Ja-cup/FiveLink/README.md

# FiveLink
FiveLink is a remote-controlled, pick-and-place robot developed for our Bachelor thesis in collaboration with Tronrud Engineering. The design builds on the earlier DuoPod prototype.

Project video: https://youtu.be/_2HHFRIy9HQ
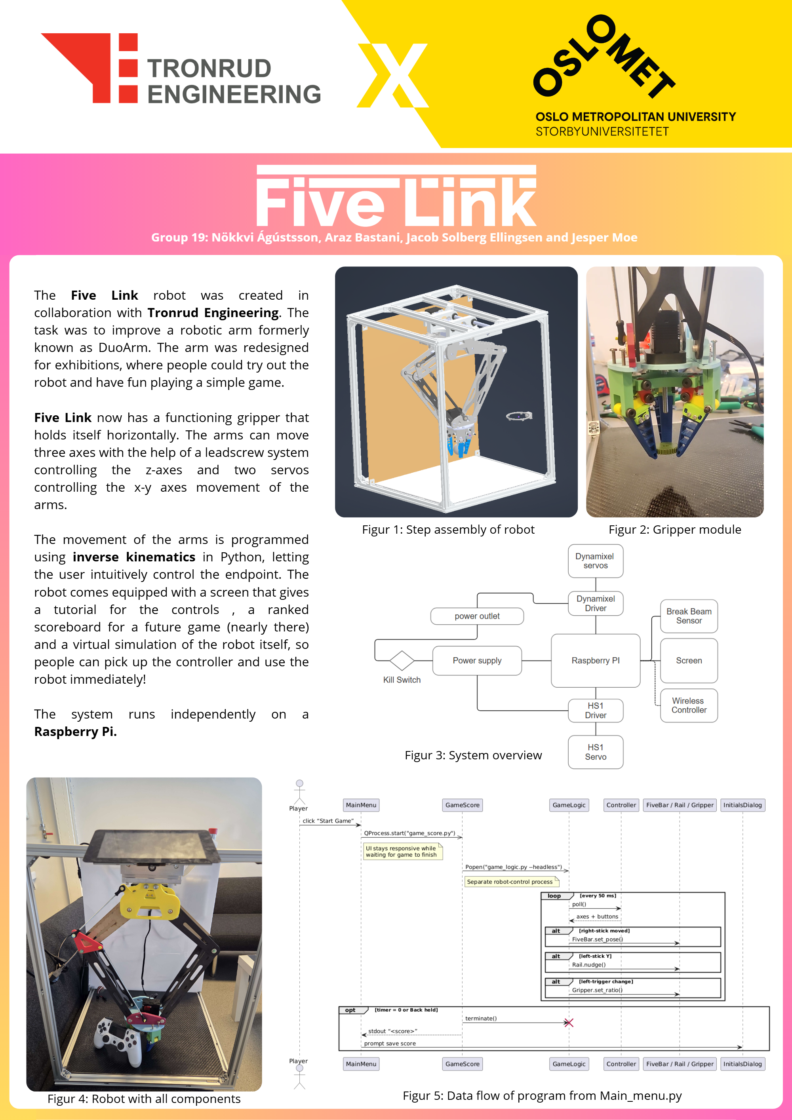
[picture p1: Poster.png]
PDF Poster
