Ja-cup/FiveLink/Software/goal gifs/hey-hi.gif

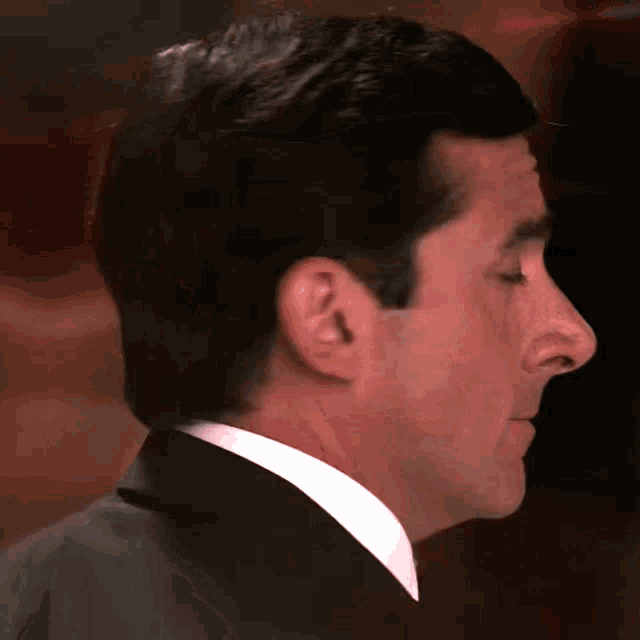
Software/goal gifs/hey-hi.gif
