Ja-cup/FiveLink/Software/goal gifs/kermit-nod-nod.gif

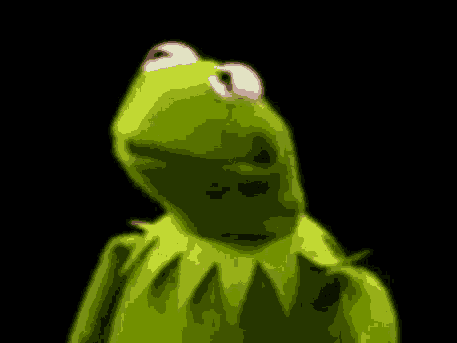
Software/goal gifs/kermit-nod-nod.gif
