Ja-cup/FiveLink/Software/goal gifs/siuuu-siu.gif

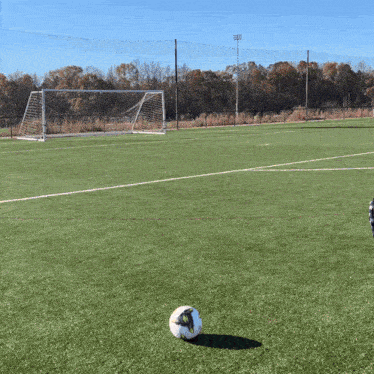
Software/goal gifs/siuuu-siu.gif
