Ja-cup/FiveLink/Software/goal gifs/spongebob-nick.gif

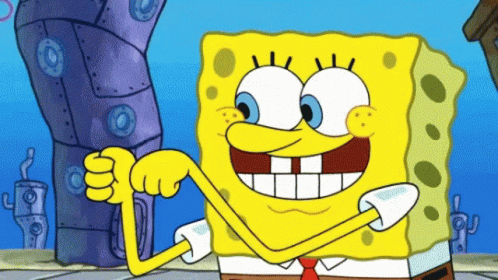
Software/goal gifs/spongebob-nick.gif
