Ja-cup/FiveLink/Design/6 Griper/Finger/Finger Assembly.stp

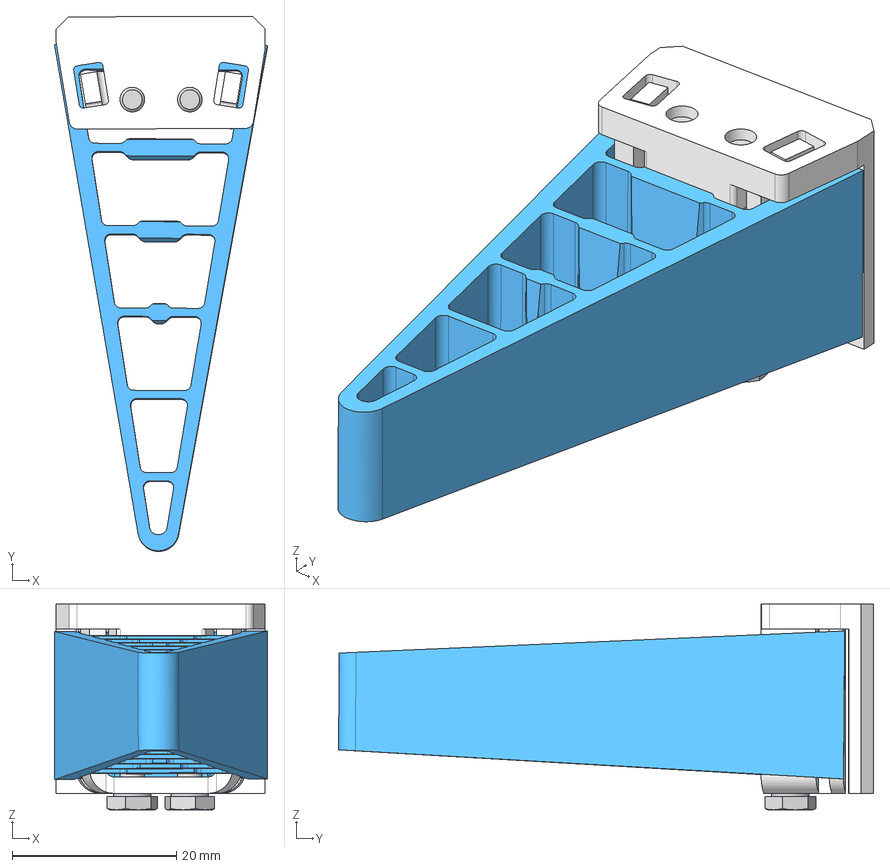
[picture p6: CAD file, 2025-08-07]
Design/6 Griper/Finger/Finger Assembly.stp
25.9 x 65.1 x 25.0 mm
4464306 DHAS-ME-H9-60---(befestigung)
Finger 60mm
Hexagon bolt DIN 933 - M3x22 x 2
Bakdel finger feste 3D - print
