Ja-cup/FiveLink/Design/1 Ramme/Assembly Ramme.stp

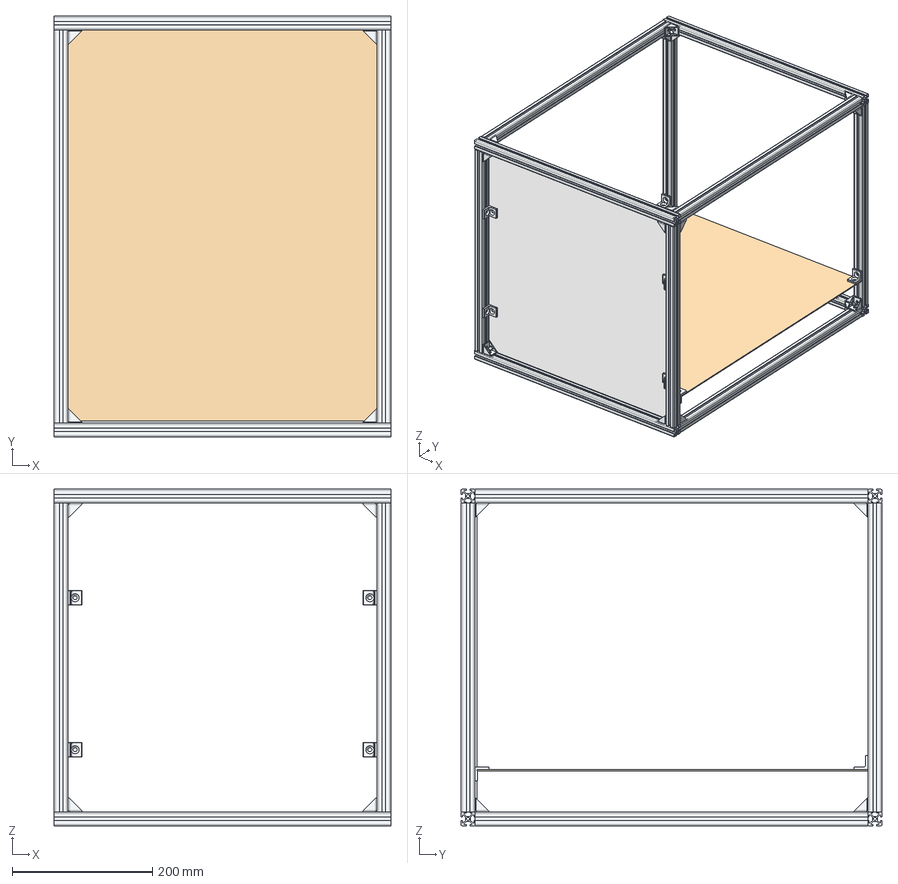
[picture p7: CAD file, 2025-08-07]
Design/1 Ramme/Assembly Ramme.stp
480.0 x 600.0 x 480.0 mm
Item Profile 20x20x440 x 4
Item Profile 20x20x480_480 x 4
Item Profile 20x20x560 x 4
CornerBracket x 24
Gulv
Anglebracket-2 x 8
Bakvegg
