Ja-cup/FiveLink/Design/4 Armer/Arm uten stabilisator assembly.stp

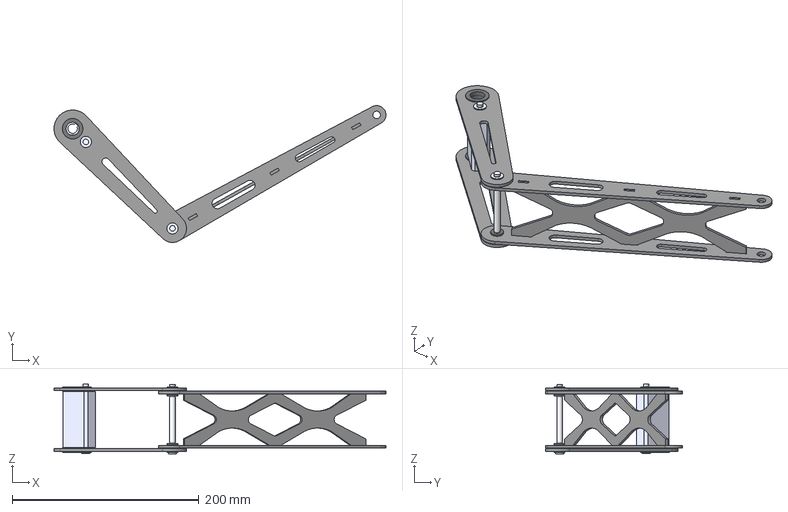
[picture p8: CAD file, 2025-08-07]
Design/4 Armer/Arm uten stabilisator assembly.stp
355.3 x 146.5 x 74.4 mm
Aksel-Arm Kobling
FlangeBearing 14x4mm x 4
HingePin AkselKobling x 2
Flange bearindID6 x 6
Aktiv arm ny lengde (1) x 2
Passiv arm ny lengde x 2
ibh_GFM-0607-024_2025411_1214_model x 2
ThrusterBearing 6x1.5 x 2
Avstiving Med Grop
