Ja-cup/FiveLink/Design/1 Ramme/Sidedel 1.stp

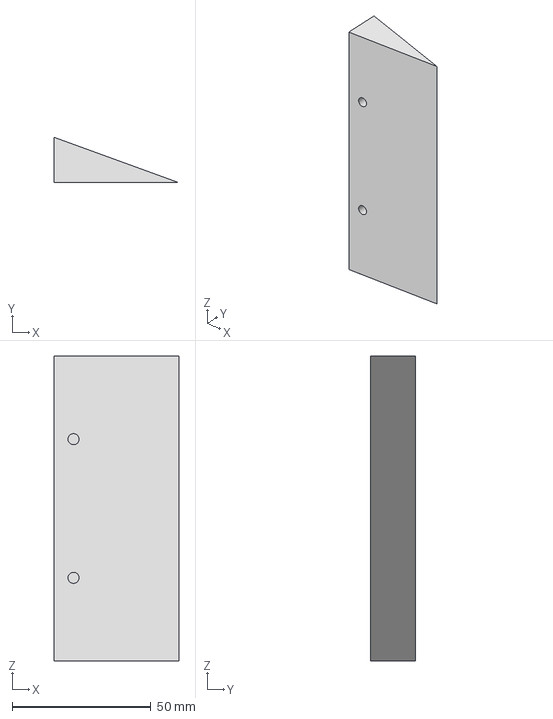
[picture p9: CAD file, 2025-08-07]
Design/1 Ramme/Sidedel 1.stp
45.0 x 16.4 x 110.0 mm
