Ja-cup/FiveLink/Design/2 Tredje Akse/Beholdt deler/Retaining Ring  C22.stp

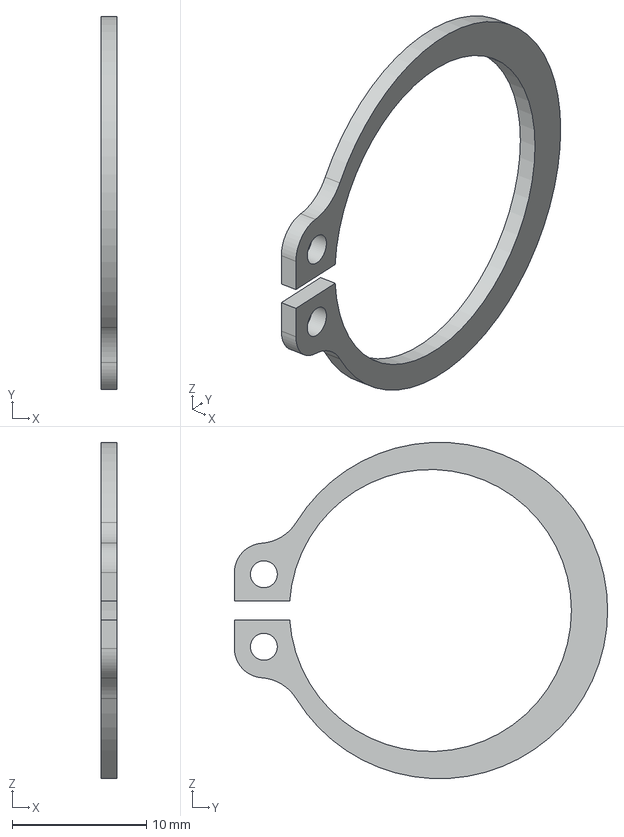
[picture p10: CAD file, 2025-08-07]
Design/2 Tredje Akse/Beholdt deler/Retaining Ring C22.stp
1.20 x 27.8 x 25.0 mm
