Ja-cup/FiveLink/Design/2 Tredje Akse/GirP30T.stp

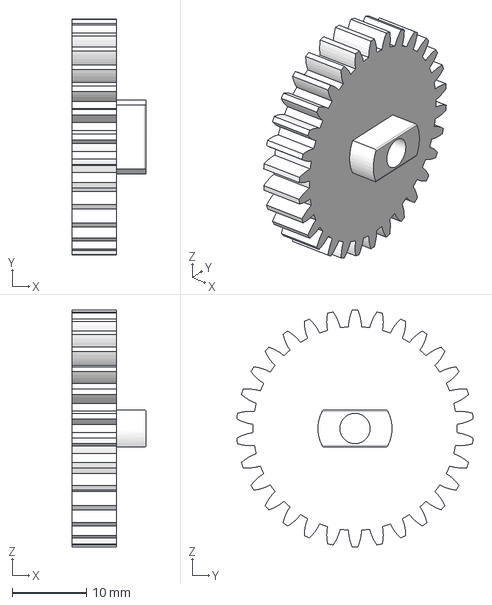
[picture p11: CAD file, 2025-08-07]
Design/2 Tredje Akse/GirP30T.stp
10.0 x 31.9 x 32.0 mm
