Ja-cup/FiveLink/Design/3 Festehub/Beholdt deler/Aksel.stp

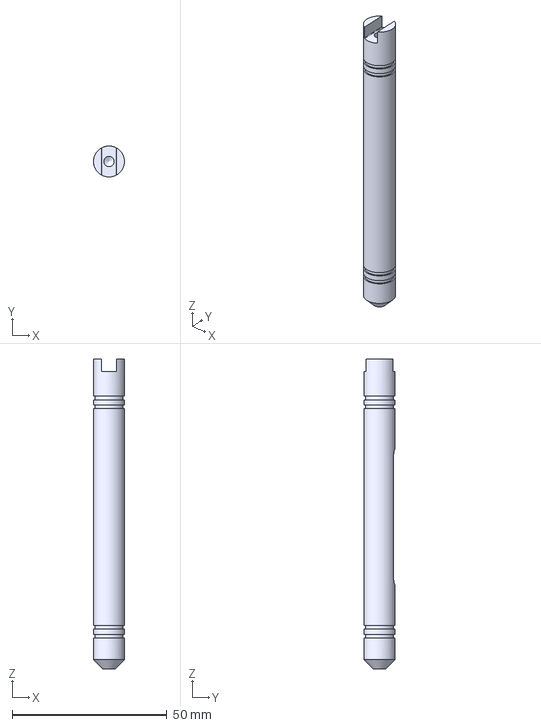
[picture p12: CAD file, 2025-08-07]
Design/3 Festehub/Beholdt deler/Aksel.stp
10.0 x 10.0 x 100.0 mm
