Ja-cup/FiveLink/Design/3 Festehub/Festehub.stp

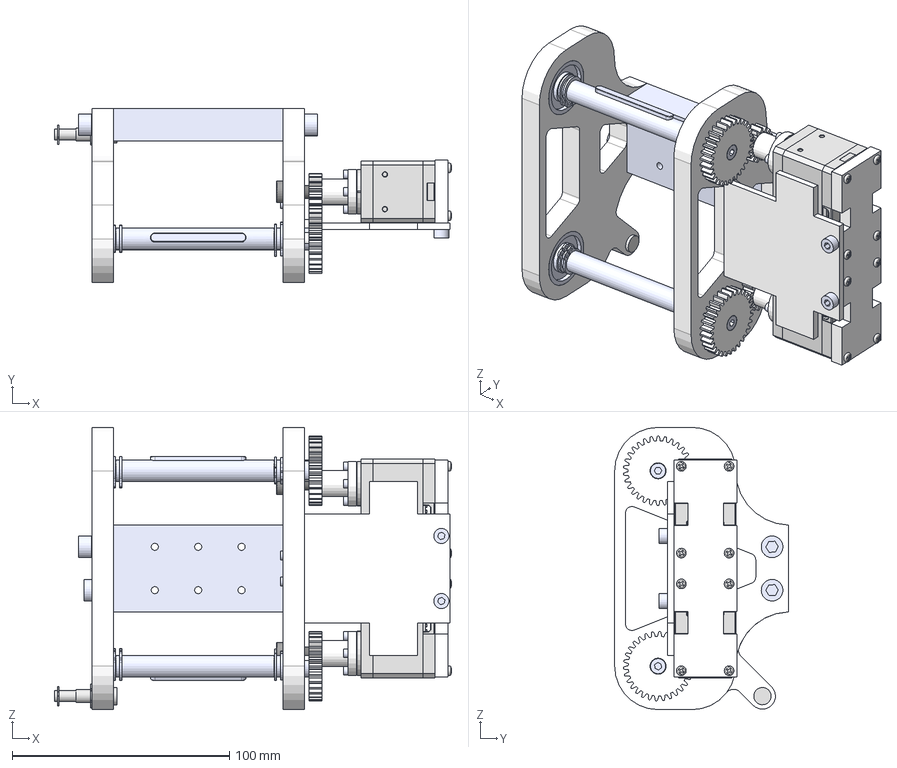
[picture p13: CAD file, 2025-08-07]
Design/3 Festehub/Festehub.stp
182.9 x 80.0 x 130.0 mm
Midt
A - Bakplate med bushing
GirP30T x 2
KileL44 x 2
Aksel x 2
Retainingring10mm x 8
M4x0,7 L12 x 2
BallbearingSteel x 4
M6x1,0 L20 x 4
BrakettMotor nye motorer (4)
fastenbracketmotor fiks
DC11_B01_CASE_M_DUMMY x 2
DC11_B01_CASE_F_DUMMY x 2
DC11_B01_CASE_B_DUMMY2 x 2
PHS_M2_5X12_K x 24
DX124_SCREW-COVER x 2
DC11_A01_WIN_LED x 2
DC11_A01_CVR_CABLE x 2
M_DC11_A01_IDLER x 2
DC11_A01_HORN_INSERT_1 x 16
M_DC11_A01_IDLER_CAP x 2
DC11_A01_IDLER_SCREW x 2
DC14_A01_INSERT_1 x 2
M_DC11_A01_HORN x 2
FHS_M2_5X06_NYLOK x 2
B3B-EH x 4
EHR-3 x 4
M4x0,7 L14 x 4
M2x0,4 L5 x 8
Lille gir + adapter x 2
NETWS4
NETWS5
Stabilisator adapter festehub NEW
A - Forplate
