Ja-cup/FiveLink/Design/4 Armer/Beholdt deler/HingePin ArmStab.stp

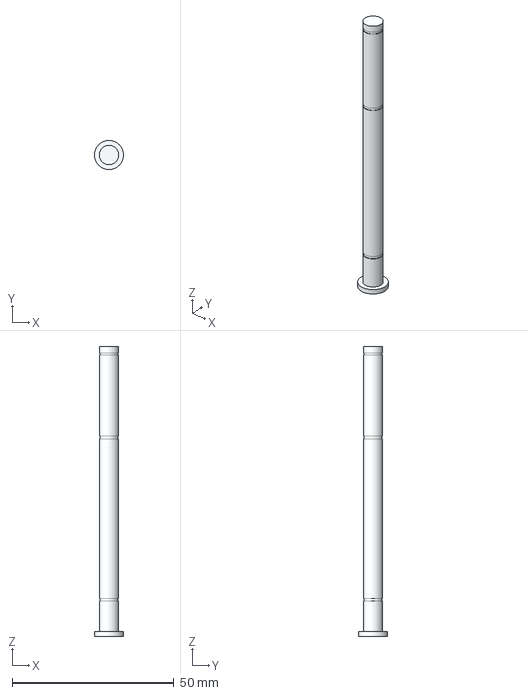
[picture p14: CAD file, 2025-08-07]
Design/4 Armer/Beholdt deler/HingePin ArmStab.stp
8.99 x 9.00 x 89.8 mm
