Ja-cup/FiveLink/Design/4 Armer/Passiv arm med mekanisk stopper.stp

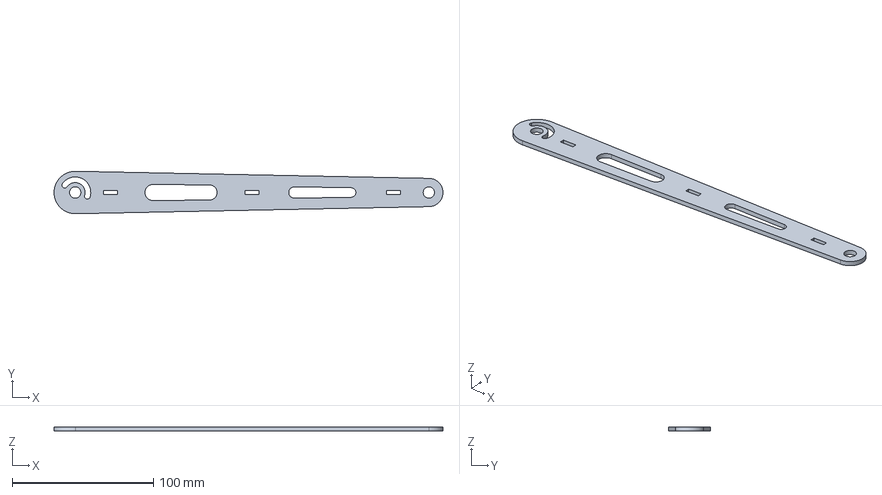
[picture p15: CAD file, 2025-08-07]
Design/4 Armer/Passiv arm med mekanisk stopper.stp
275.0 x 30.0 x 3.00 mm
