Ja-cup/FiveLink/Design/5 Stabilisator/ibh_GFM-0506-04_2025414_114_model.stp

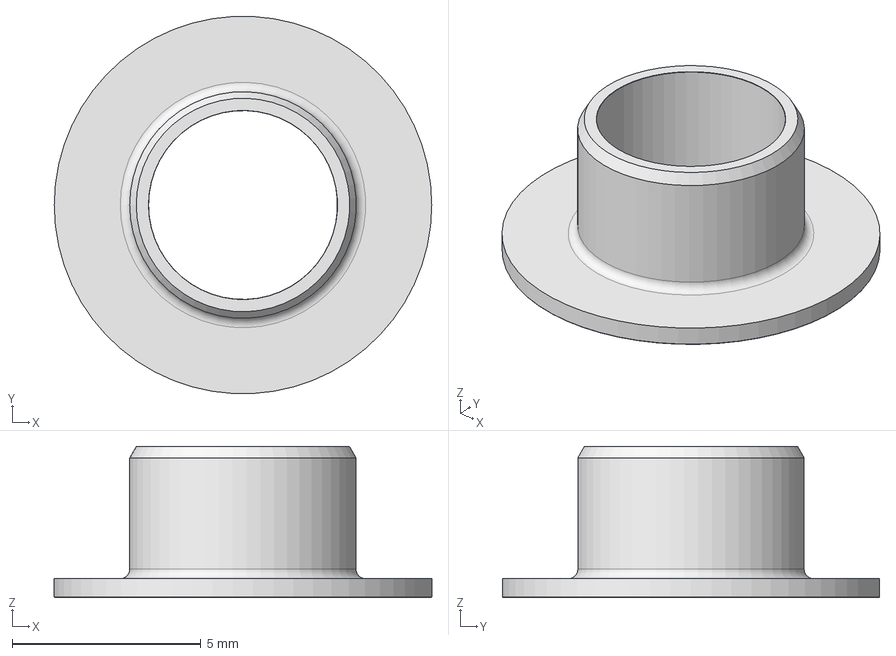
[picture p16: CAD file, 2025-08-07]
Design/5 Stabilisator/ibh_GFM-0506-04_2025414_114_model.stp
10.0 x 9.99 x 4.00 mm
