Ja-cup/FiveLink/Design/6 Griper/Beholdt deler/ThrusterBearing 6x1.5.stp

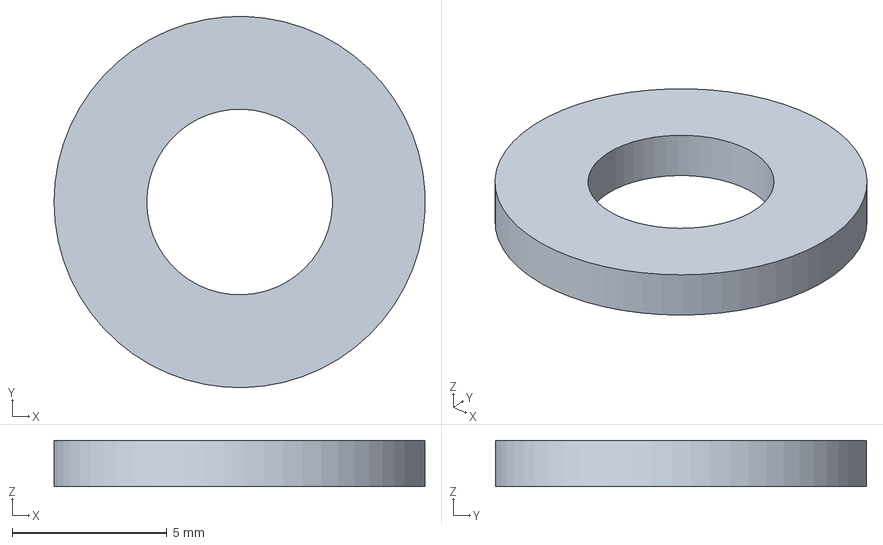
[picture p17: CAD file, 2025-08-07]
Design/6 Griper/Beholdt deler/ThrusterBearing 6x1.5.stp
12.0 x 12.0 x 1.50 mm
