Ja-cup/FiveLink/Design/6 Griper/Toolhub/Stabilisator adapter tool.stp

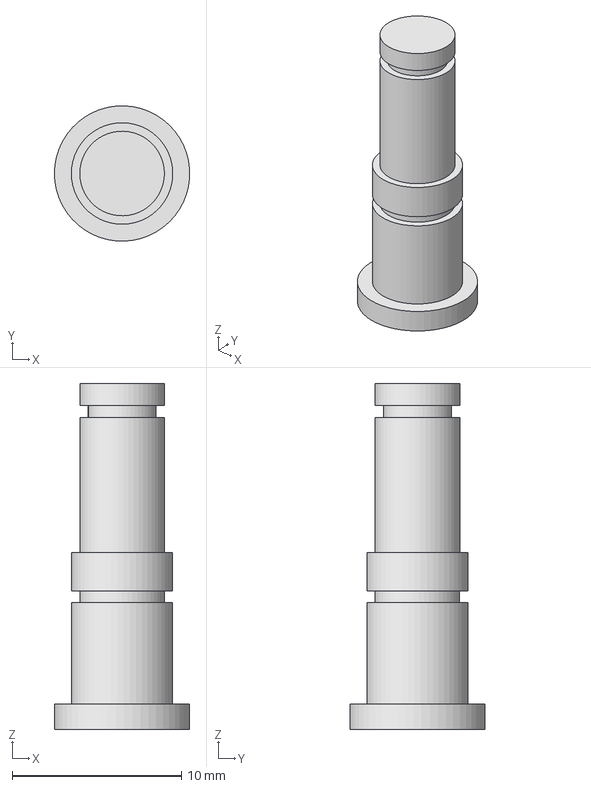
[picture p18: CAD file, 2025-08-07]
Design/6 Griper/Toolhub/Stabilisator adapter tool.stp
7.99 x 8.00 x 20.4 mm
