Ja-cup/FiveLink/Design/2 Tredje Akse/Beholdt deler/Bunnplate Rails.stp

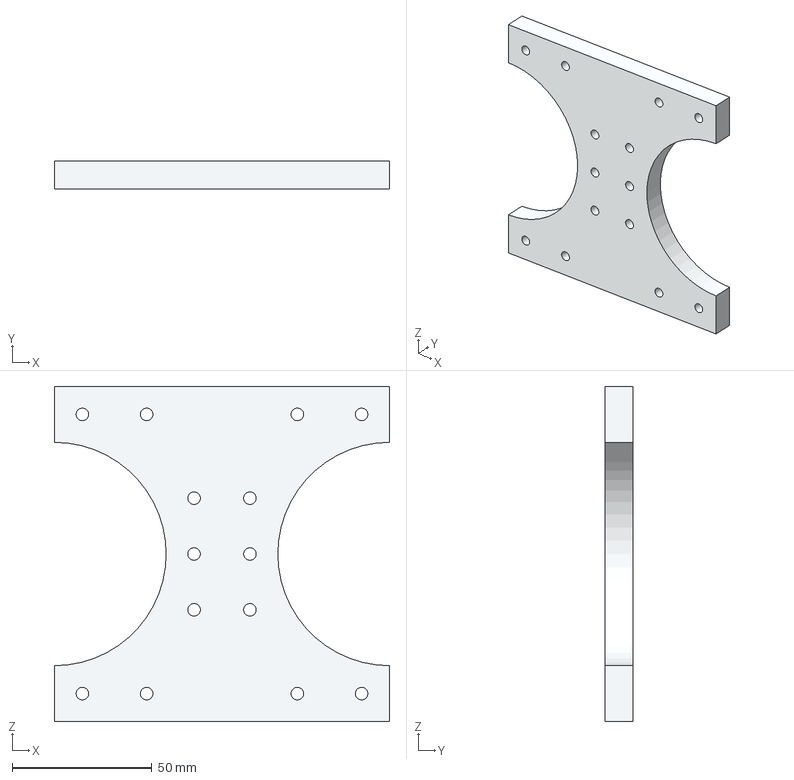
[picture p19: CAD file, 2025-08-07]
Design/2 Tredje Akse/Beholdt deler/Bunnplate Rails.stp
120.0 x 10.0 x 120.0 mm
