Ja-cup/FiveLink/Design/2 Tredje Akse/JSRM_3024TR12X6P3_1.stp

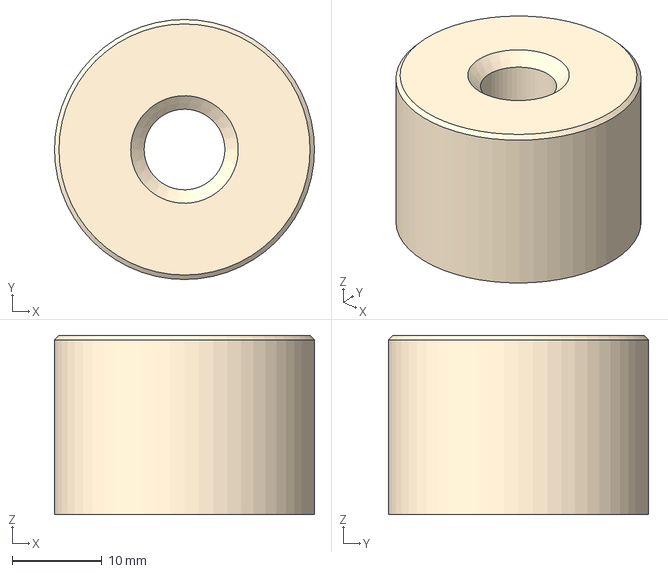
[picture p20: CAD file, 2025-08-07]
Design/2 Tredje Akse/JSRM_3024TR12X6P3_1.stp
29.0 x 29.0 x 20.0 mm
