Ja-cup/FiveLink/Design/3 Festehub/Beholdt deler/Frontside.stp

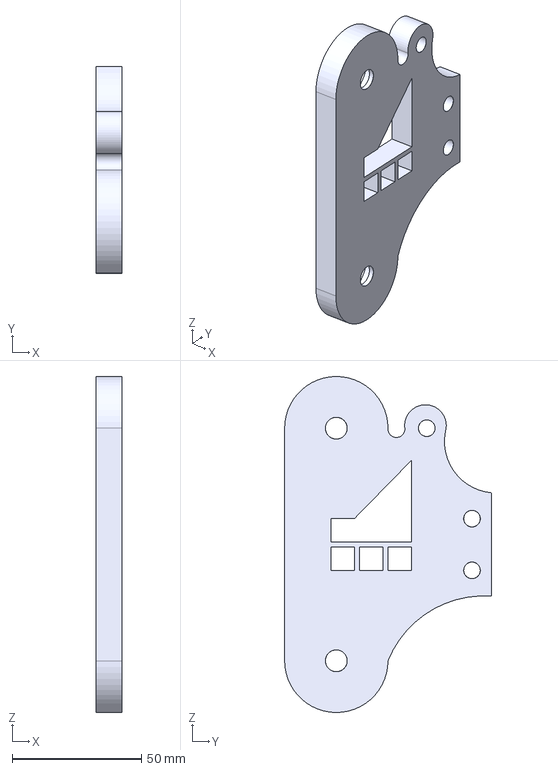
[picture p21: CAD file, 2025-08-07]
Design/3 Festehub/Beholdt deler/Frontside.stp
10.00 x 80.0 x 130.0 mm
