Ja-cup/FiveLink/Design/3 Festehub/Motorbrakett deler/XC-430_idle ny.stp

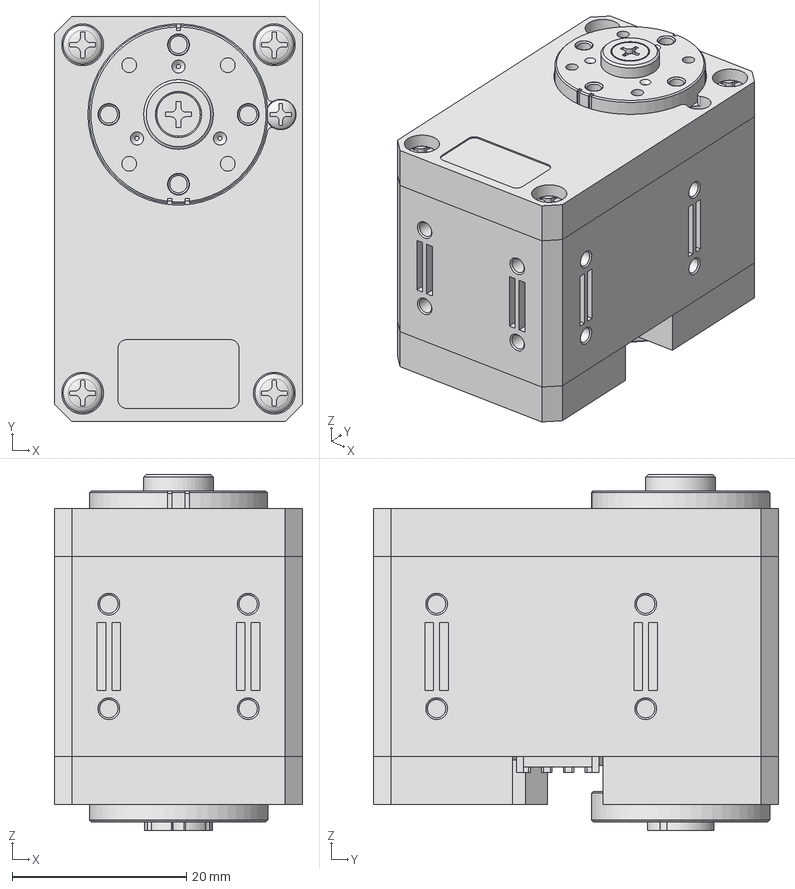
[picture p22: CAD file, 2025-08-07]
Design/3 Festehub/Motorbrakett deler/XC-430_idle ny.stp
28.5 x 46.5 x 40.9 mm
DC11_B01_CASE_M_DUMMY
DC11_B01_CASE_F_DUMMY
DC11_B01_CASE_B_DUMMY2
PHS_M2_5X12_K x 8
DX124_SCREW-COVER
DC11_A01_WIN_LED
M_DC11_A01_IDLER
DC11_A01_HORN_INSERT_1 x 8
M_DC11_A01_IDLER_CAP
DC11_A01_IDLER_SCREW
DC14_A01_INSERT_1
M_DC11_A01_HORN
FHS_M2_5X06_NYLOK
B3B-EH x 2
EHR-3 x 2
