Ja-cup/FiveLink/Design/3 Festehub/NETWS4.stp

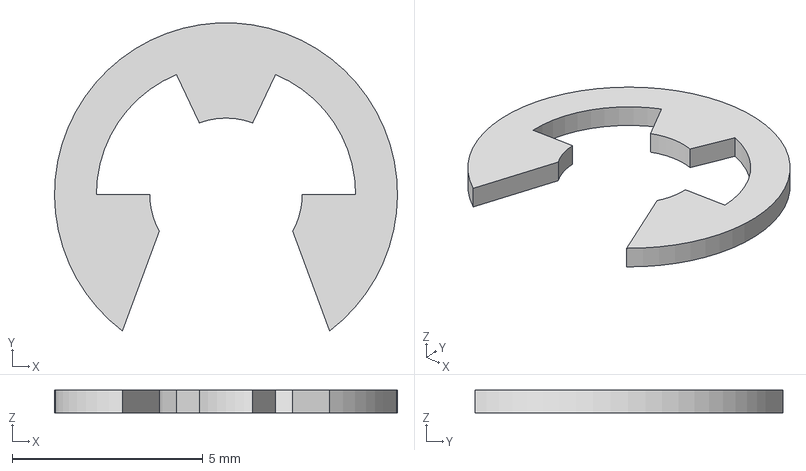
[picture p23: CAD file, 2025-08-07]
Design/3 Festehub/NETWS4.stp
9.00 x 8.08 x 0.6 mm
