Ja-cup/FiveLink/Design/4 Armer/Beholdt deler/FlangeBearing 14x4mm.stp

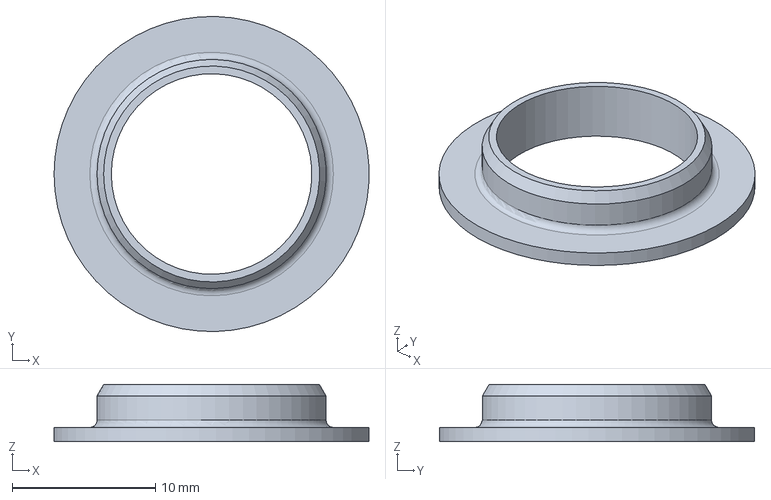
[picture p24: CAD file, 2025-08-07]
Design/4 Armer/Beholdt deler/FlangeBearing 14x4mm.stp
22.0 x 22.0 x 4.00 mm
