Ja-cup/FiveLink/Design/5 Stabilisator/96mm carbon rør.stp

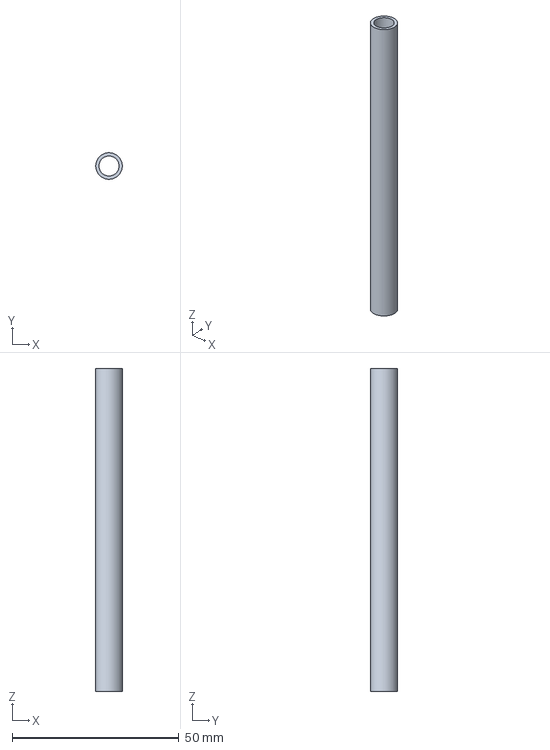
[picture p25: CAD file, 2025-08-07]
Design/5 Stabilisator/96mm carbon rør.stp
7.99 x 8.00 x 97.0 mm
