Ja-cup/FiveLink/Design/6 Griper/Beholdt deler/Flange bearindID6.stp

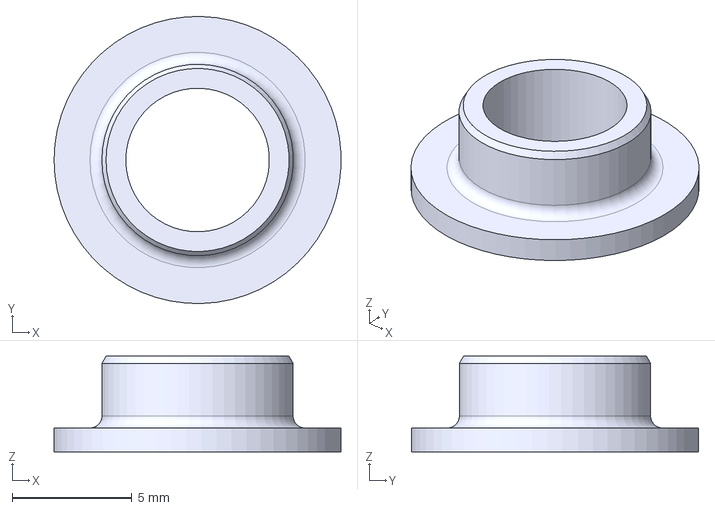
[picture p26: CAD file, 2025-08-07]
Design/6 Griper/Beholdt deler/Flange bearindID6.stp
12.0 x 12.0 x 4.00 mm
