Ja-cup/FiveLink/Design/6 Griper/Toolhub/Toolhub feste.stp

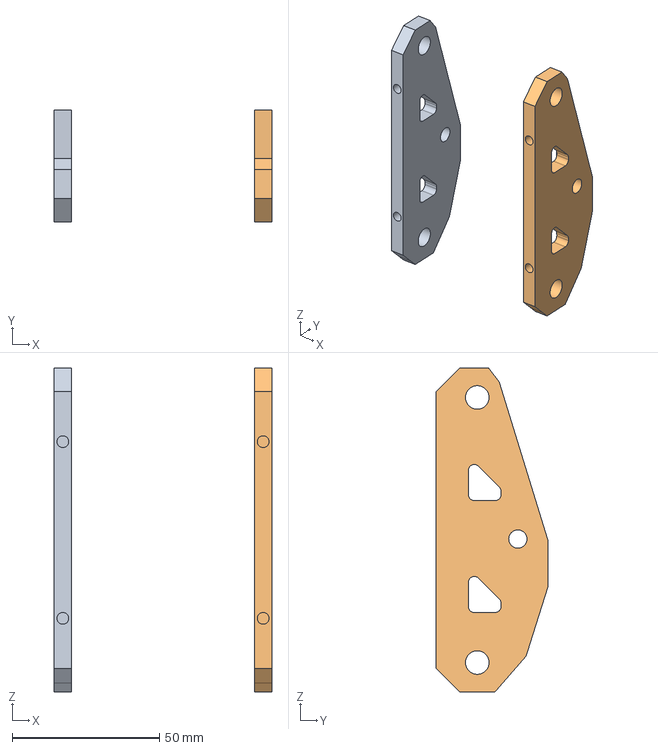
[picture p27: CAD file, 2025-08-07]
Design/6 Griper/Toolhub/Toolhub feste.stp
74.0 x 38.0 x 110.0 mm
