Ja-cup/FiveLink/Design/1 Ramme/Sidedel 2.stp

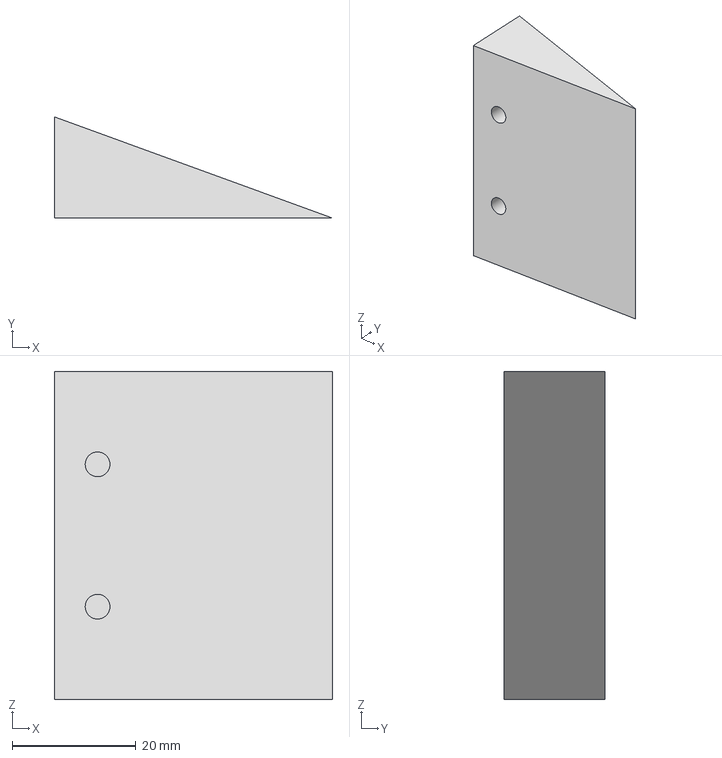
[picture p28: CAD file, 2025-08-07]
Design/1 Ramme/Sidedel 2.stp
45.0 x 16.4 x 53.0 mm
