Ja-cup/FiveLink/Design/2 Tredje Akse/Beholdt deler/Ball Bearing 608.stp

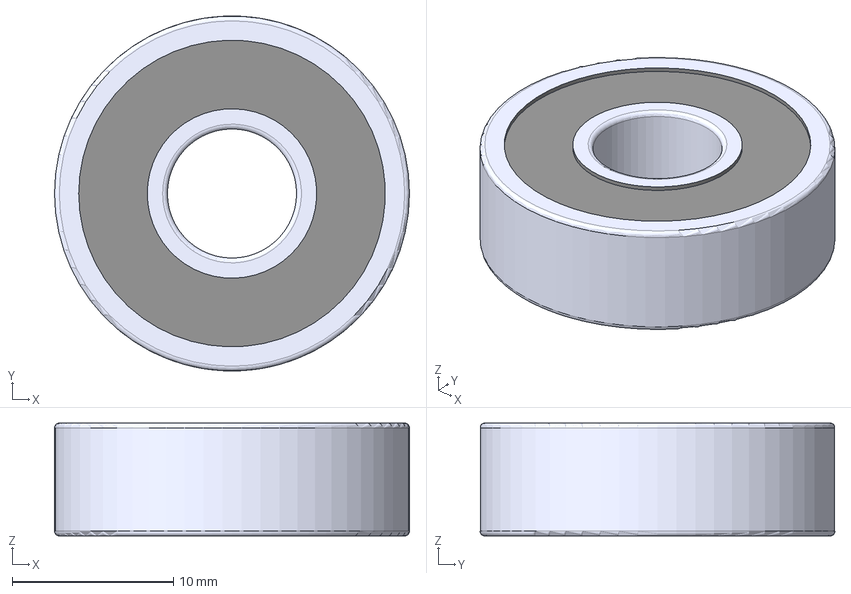
[picture p29: CAD file, 2025-08-07]
Design/2 Tredje Akse/Beholdt deler/Ball Bearing 608.stp
22.0 x 22.0 x 7.00 mm
