Ja-cup/FiveLink/Design/3 Festehub/Beholdt deler/Retainingring10mm.stp

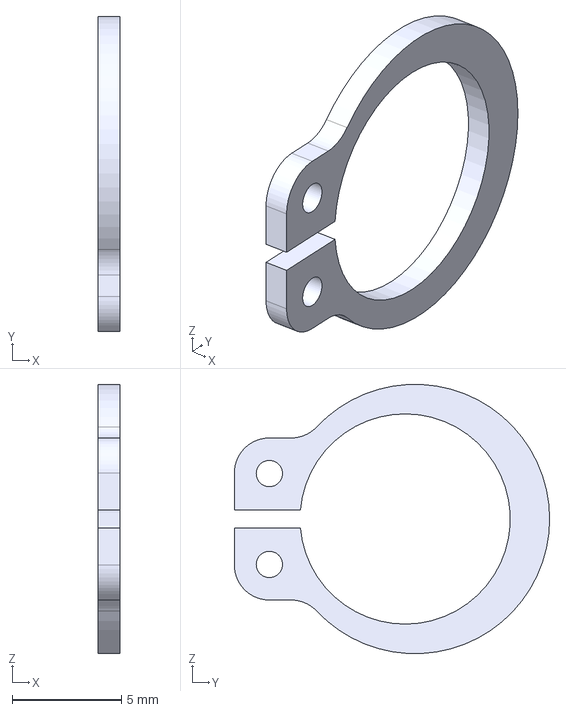
[picture p30: CAD file, 2025-08-07]
Design/3 Festehub/Beholdt deler/Retainingring10mm.stp
1.00 x 14.4 x 12.3 mm
