Ja-cup/FiveLink/Design/3 Festehub/Skruer/PHS_M2_5X12_K.stp

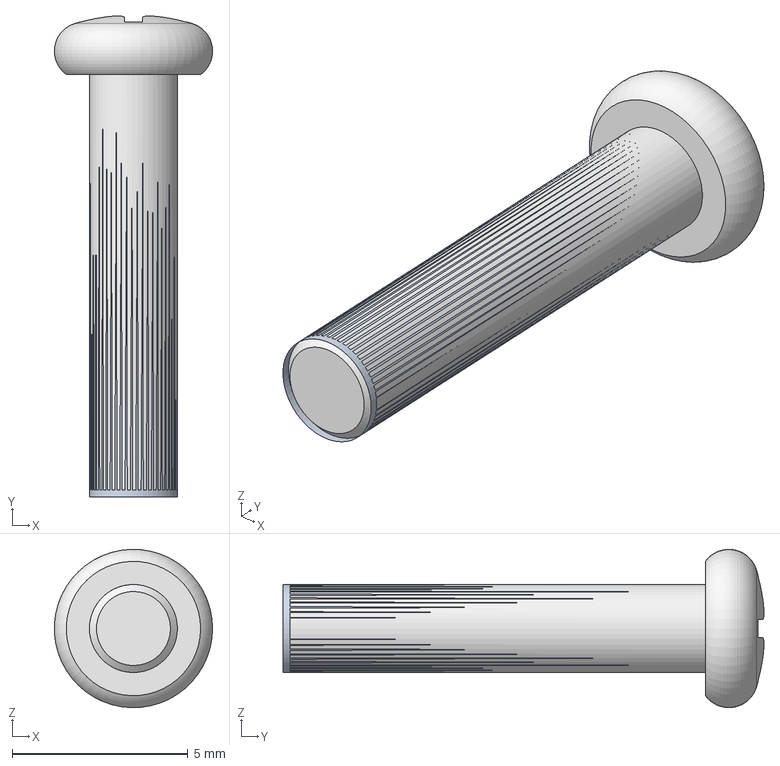
[picture p32: CAD file, 2025-08-07]
Design/3 Festehub/Skruer/PHS_M2_5X12_K.stp
4.49 x 13.7 x 4.50 mm
