Ja-cup/FiveLink/Design/4 Armer/Beholdt deler/Aksel-Arm Kobling.stp

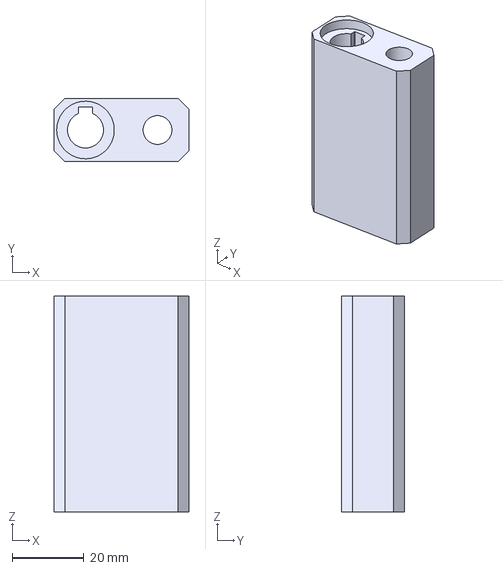
[picture p33: CAD file, 2025-08-07]
Design/4 Armer/Beholdt deler/Aksel-Arm Kobling.stp
37.5 x 17.5 x 60.0 mm
