Ja-cup/FiveLink/Design/6 Griper/Beholdt deler/HingepinArm.stp

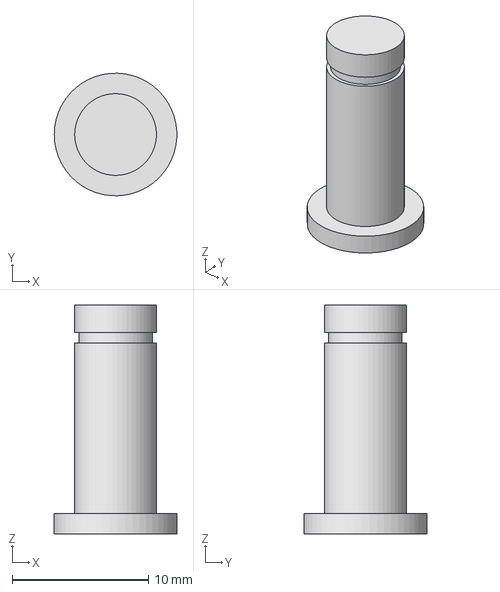
[picture p35: CAD file, 2025-08-07]
Design/6 Griper/Beholdt deler/HingepinArm.stp
8.99 x 9.00 x 16.8 mm
