Ja-cup/FiveLink/Design/6 Griper/Finger/Bakdel finger feste 3D - print.stp

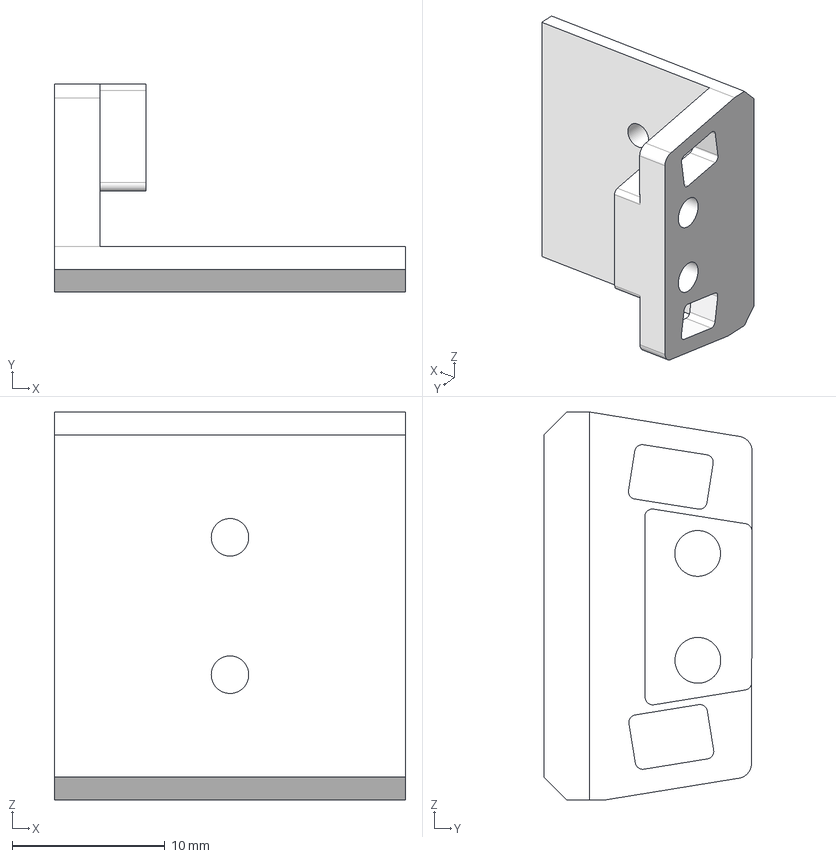
[picture p36: CAD file, 2025-08-07]
Design/6 Griper/Finger/Bakdel finger feste 3D - print.stp
23.0 x 13.6 x 25.4 mm
