Ja-cup/FiveLink/Design/6 Griper/Lengdefeste.stp

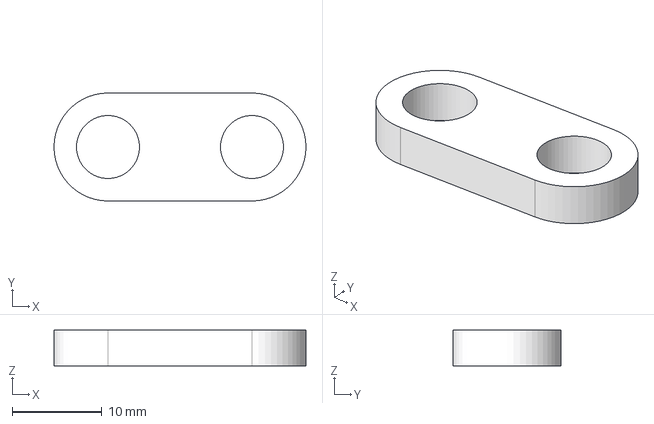
[picture p37: CAD file, 2025-08-07]
Design/6 Griper/Lengdefeste.stp
28.0 x 12.0 x 4.00 mm
