Ja-cup/FiveLink/Design/6 Griper/Skruer/ANSI B18.3.1M - M2x0.4 x 25(2).stp

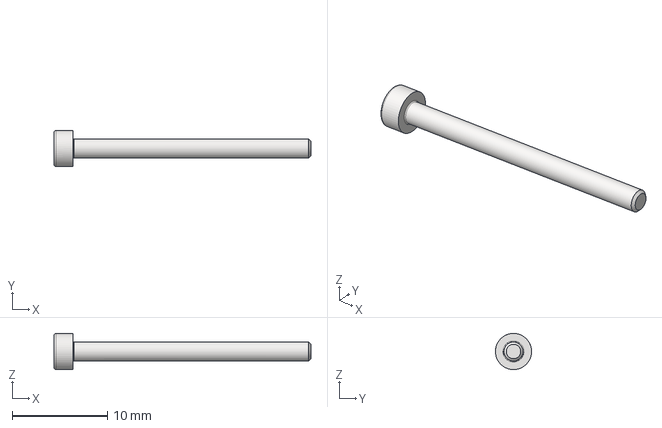
[picture p38: CAD file, 2025-08-07]
Design/6 Griper/Skruer/ANSI B18.3.1M - M2x0.4 x 25(2).stp
27.0 x 3.80 x 3.80 mm
