Ja-cup/FiveLink/Design/6 Griper/Toolhub/Brikke.stp

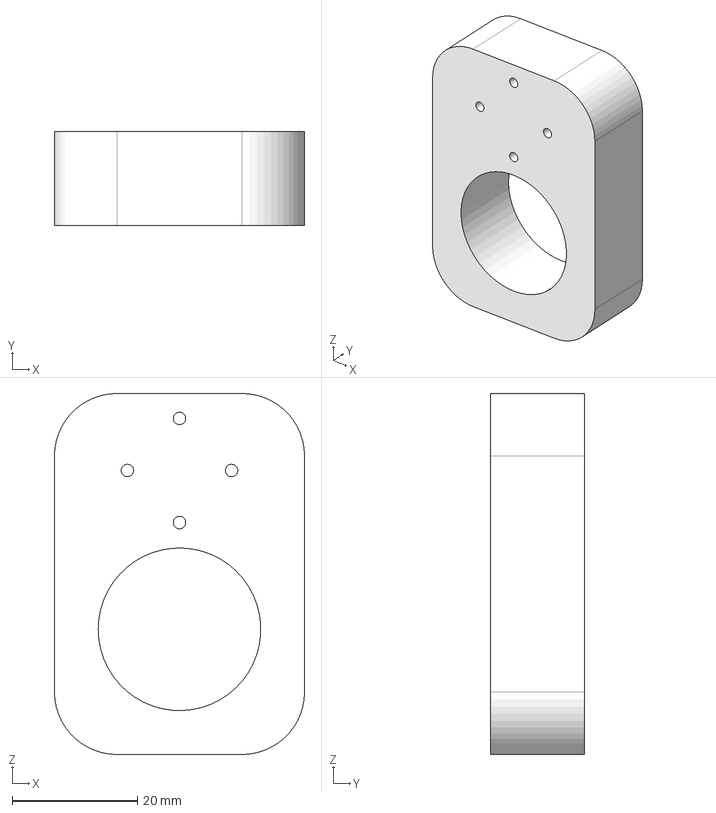
[picture p39: CAD file, 2025-08-07]
Design/6 Griper/Toolhub/Brikke.stp
40.0 x 15.0 x 57.7 mm
