Ja-cup/FiveLink/Design/1 Ramme/Vinkeldel.stp

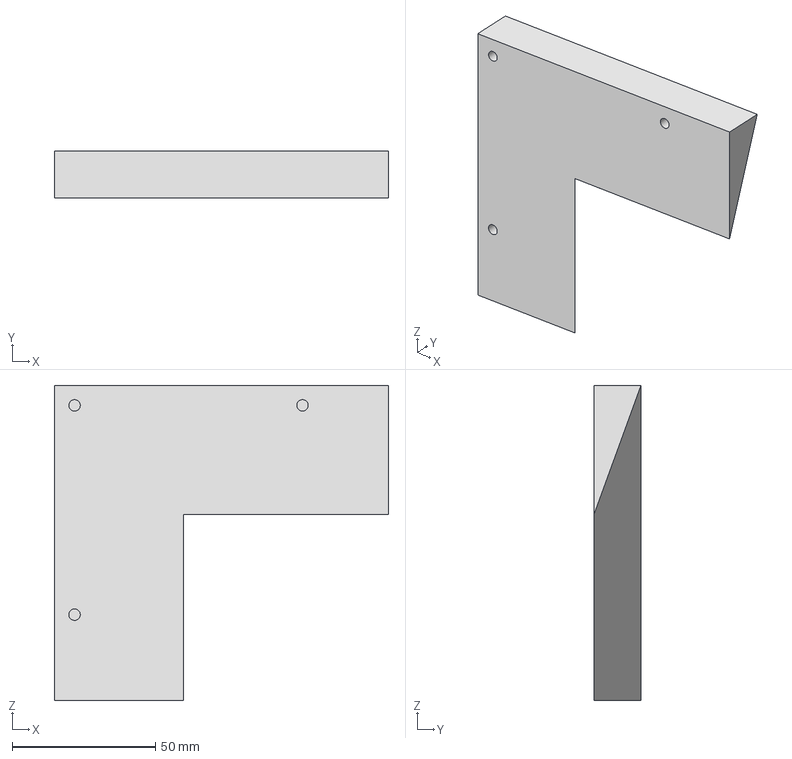
[picture p40: CAD file, 2025-08-07]
Design/1 Ramme/Vinkeldel.stp
116.5 x 16.4 x 110.0 mm
