Ja-cup/FiveLink/Design/2 Tredje Akse/Beholdt deler/AdapterDrivhjul.stp

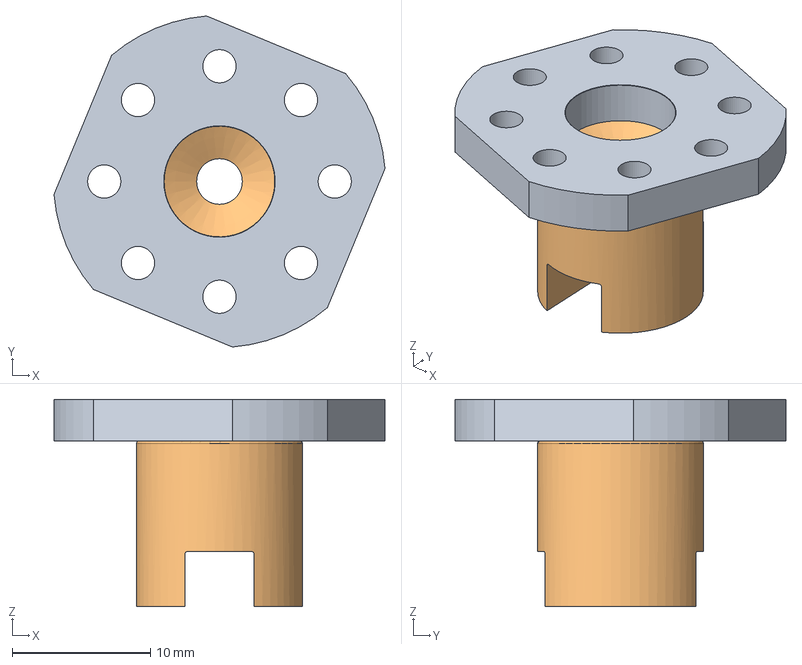
[picture p41: CAD file, 2025-08-07]
Design/2 Tredje Akse/Beholdt deler/AdapterDrivhjul.stp
23.9 x 23.9 x 15.0 mm
