Ja-cup/FiveLink/Design/2 Tredje Akse/GirP15T.stp

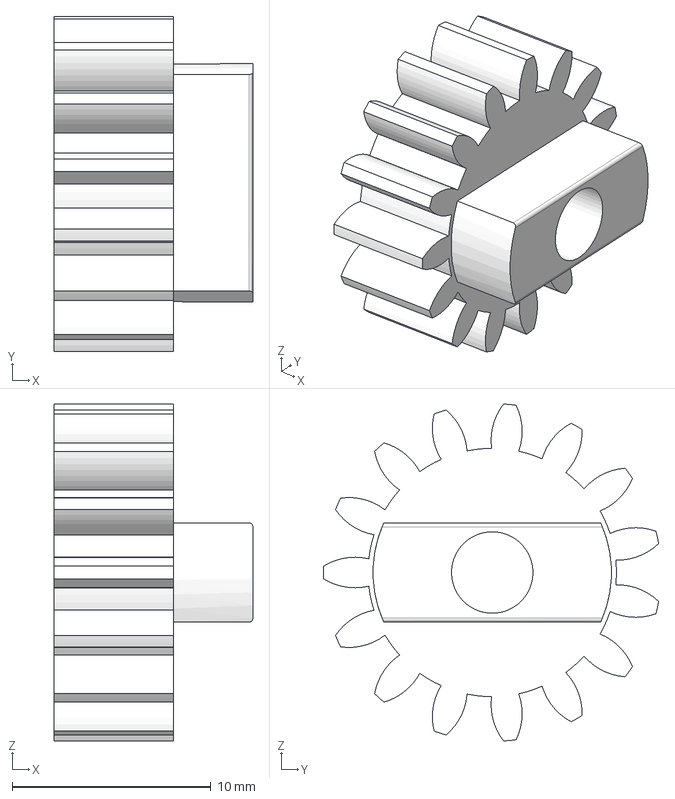
[picture p42: CAD file, 2025-08-07]
Design/2 Tredje Akse/GirP15T.stp
10.0 x 16.9 x 17.0 mm
