Ja-cup/FiveLink/Design/3 Festehub/Beholdt deler/Midt.stp

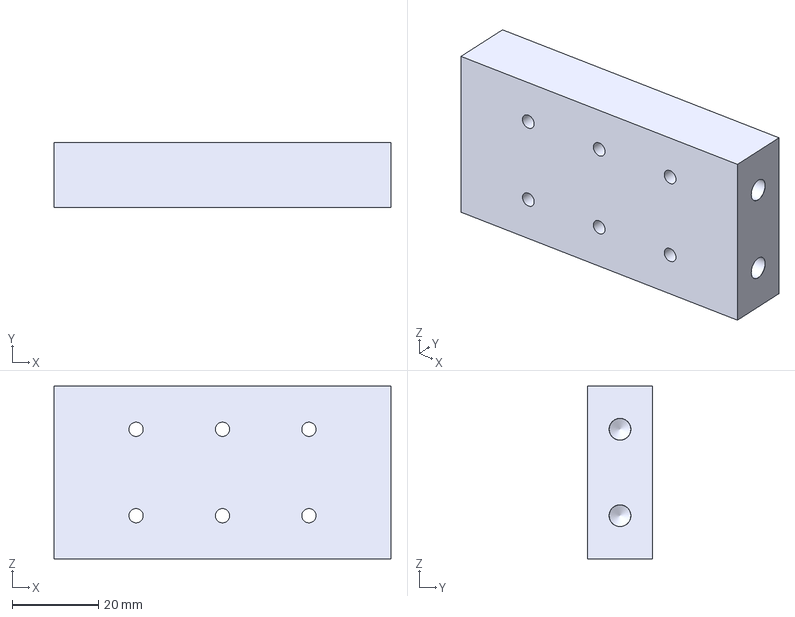
[picture p43: CAD file, 2025-08-07]
Design/3 Festehub/Beholdt deler/Midt.stp
78.0 x 15.0 x 40.0 mm
