Ja-cup/FiveLink/Design/3 Festehub/Motorbrakett deler/Lille gir + adapter.stp

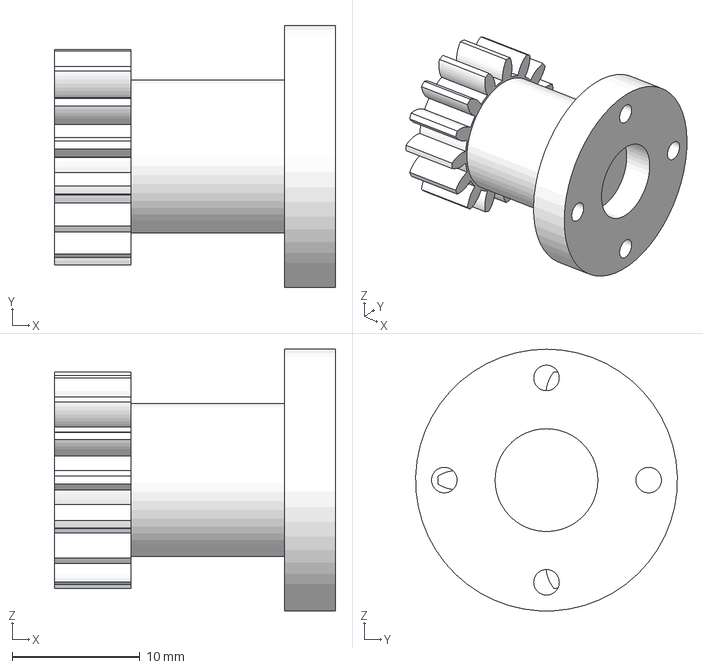
[picture p44: CAD file, 2025-08-07]
Design/3 Festehub/Motorbrakett deler/Lille gir + adapter.stp
22.0 x 20.5 x 20.5 mm
