Ja-cup/FiveLink/Design/3 Festehub/NETWS5.stp

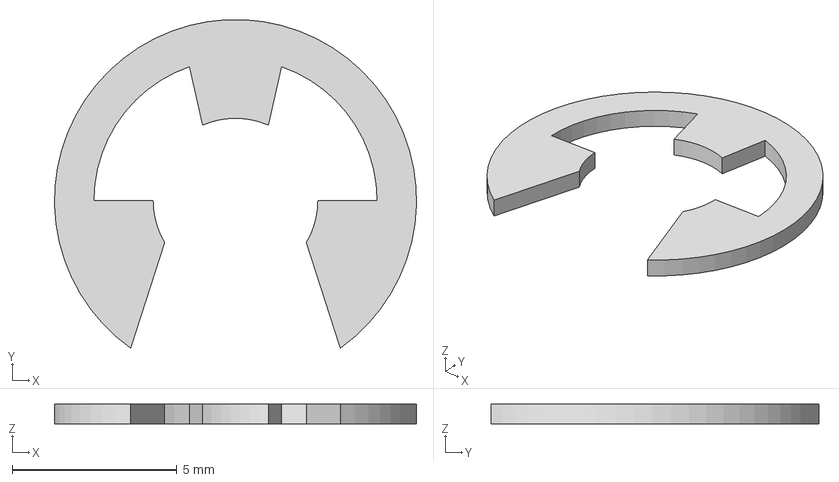
[picture p45: CAD file, 2025-08-07]
Design/3 Festehub/NETWS5.stp
11.0 x 9.98 x 0.6 mm
