Ja-cup/FiveLink/Design/4 Armer/HingePin AkselKobling.stp

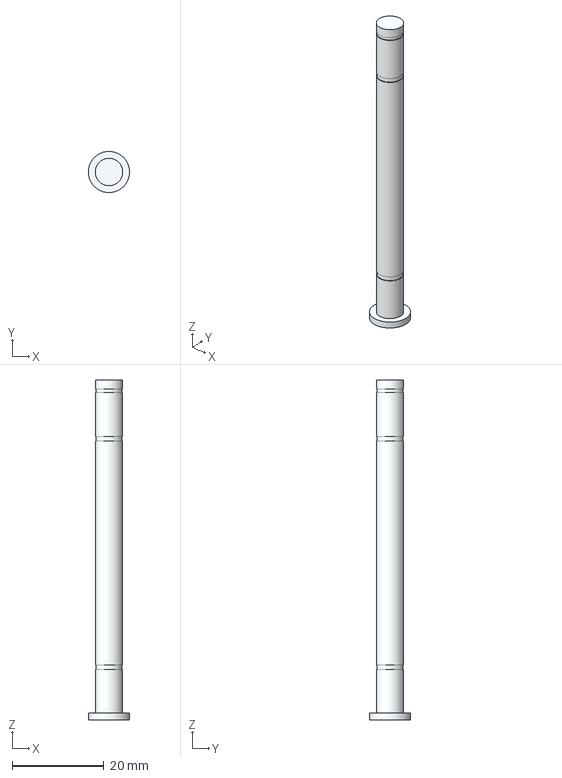
[picture p46: CAD file, 2025-08-07]
Design/4 Armer/HingePin AkselKobling.stp
8.99 x 9.00 x 74.3 mm
