Ja-cup/FiveLink/Design/5 Stabilisator/KBLM_05_1.stp

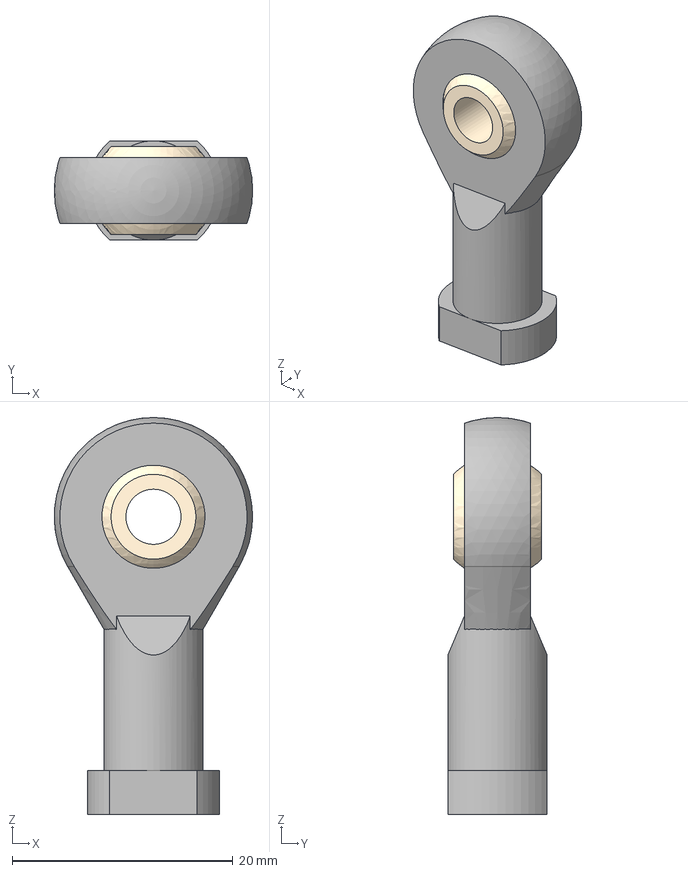
[picture p47: CAD file, 2025-08-07]
Design/5 Stabilisator/KBLM_05_1.stp
18.0 x 9.00 x 36.0 mm
