Ja-cup/FiveLink/Design/6 Griper/Toolhub/MotorAdapter.stp

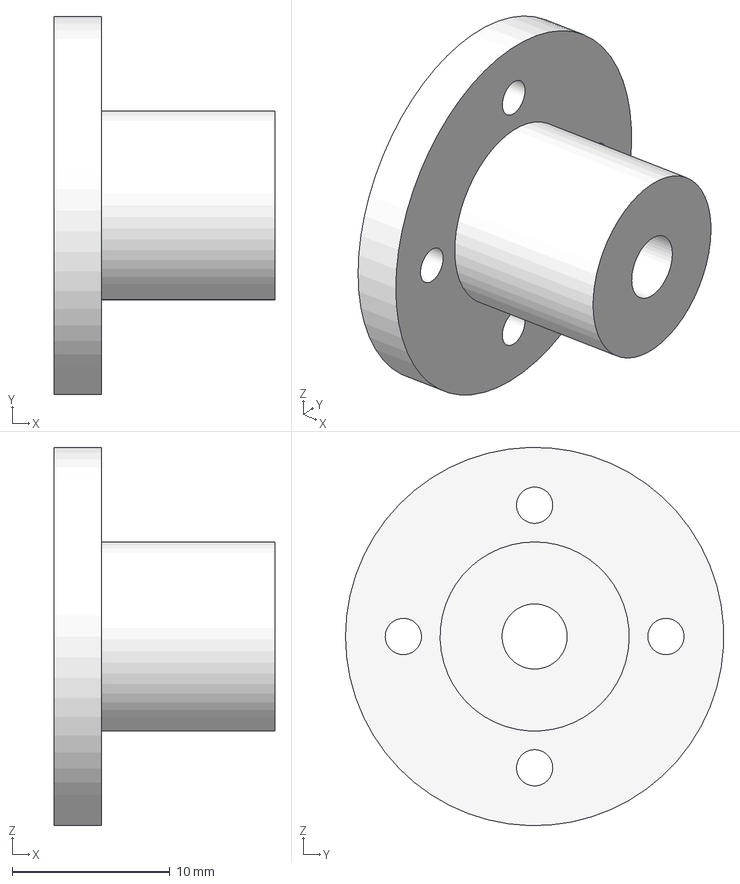
[picture p48: CAD file, 2025-08-07]
Design/6 Griper/Toolhub/MotorAdapter.stp
14.0 x 24.0 x 24.0 mm
