Ja-cup/FiveLink/Design/6 Griper/Underfeste.stp

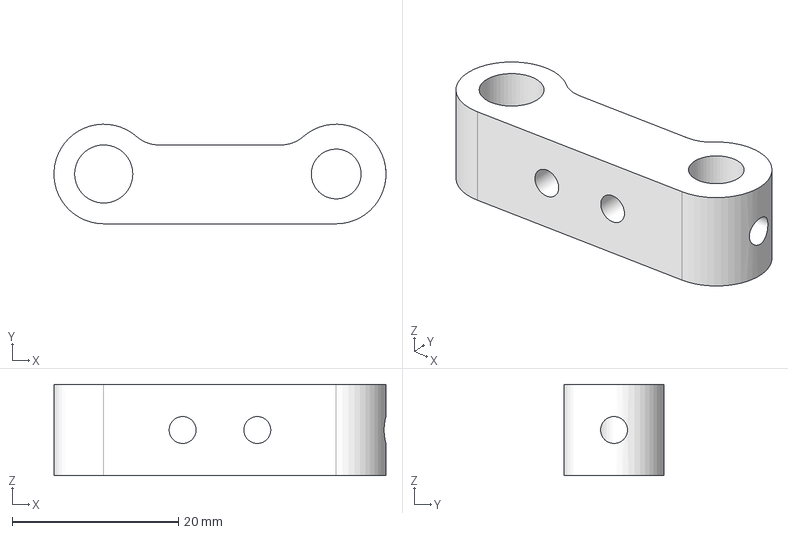
[picture p49: CAD file, 2025-08-07]
Design/6 Griper/Underfeste.stp
40.0 x 12.0 x 11.0 mm
