Ja-cup/FiveLink/Design/1 Ramme/Kurv.stp

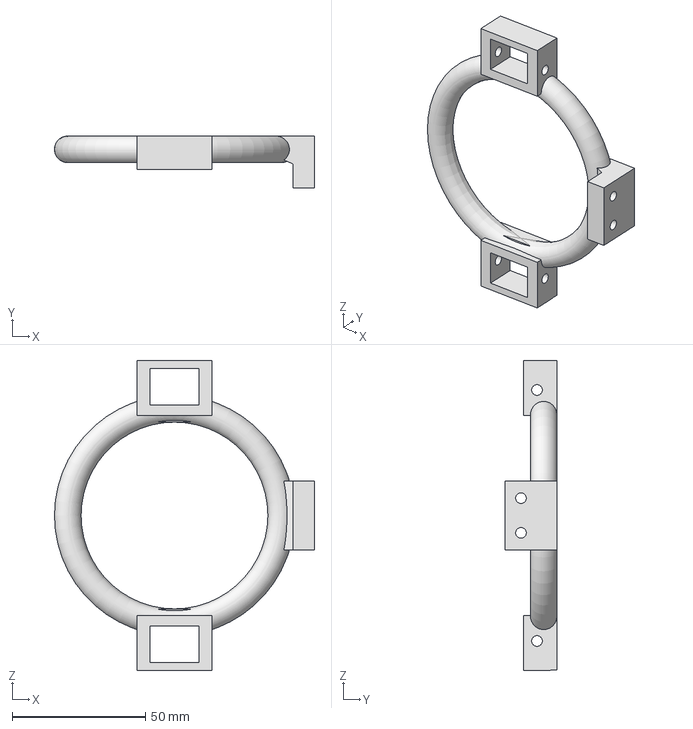
[picture p50: CAD file, 2025-08-07]
Design/1 Ramme/Kurv.stp
97.5 x 19.5 x 116.2 mm
