Ja-cup/FiveLink/Design/2 Tredje Akse/Beholdt deler/CornerBracket.stp

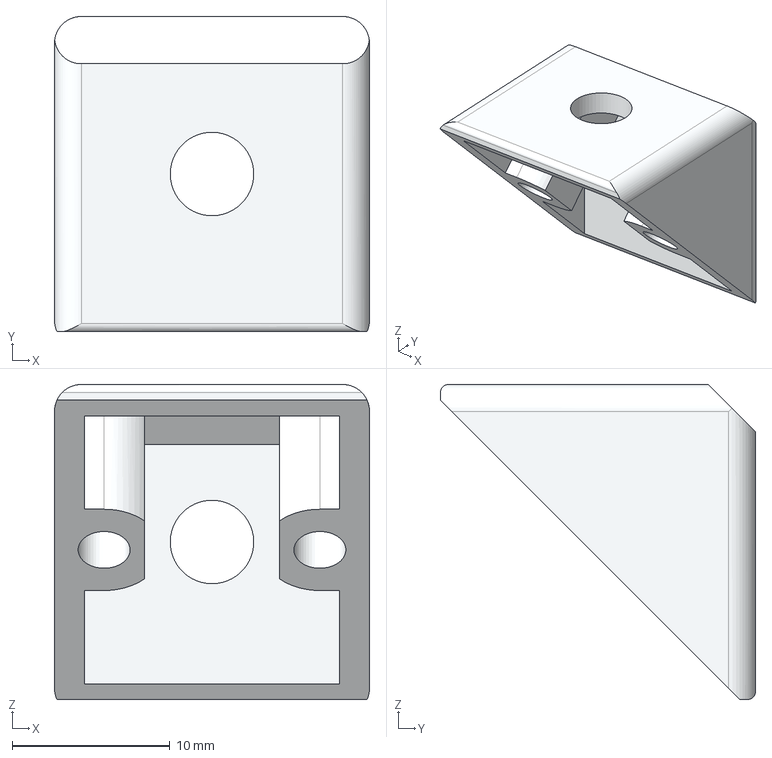
[picture p51: CAD file, 2025-08-07]
Design/2 Tredje Akse/Beholdt deler/CornerBracket.stp
20.0 x 20.0 x 20.0 mm
