Ja-cup/FiveLink/Design/2 Tredje Akse/Båtskive M5X20mm.stp

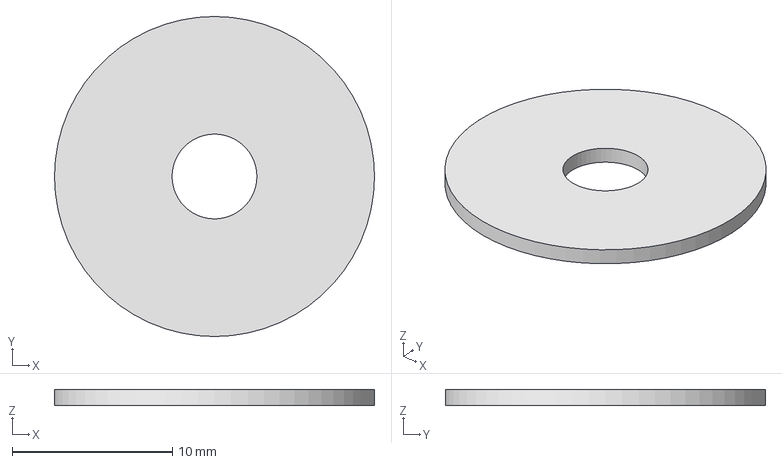
[picture p52: CAD file, 2025-08-07]
Design/2 Tredje Akse/Båtskive M5X20mm.stp
20.0 x 20.0 x 1.00 mm
