Ja-cup/FiveLink/Design/2 Tredje Akse/Skruer/AS 1474 - M5(1).stp

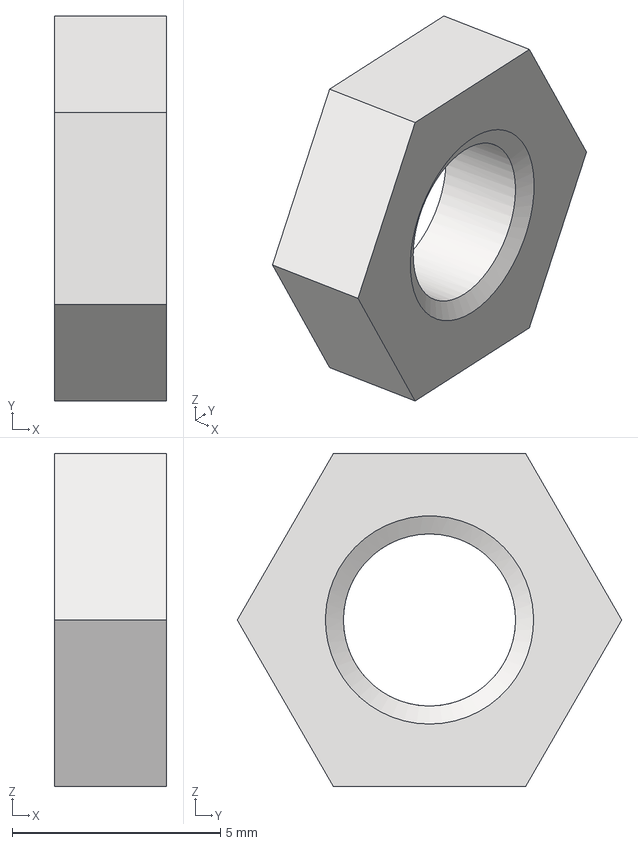
[picture p53: CAD file, 2025-08-07]
Design/2 Tredje Akse/Skruer/AS 1474 - M5(1).stp
2.70 x 9.24 x 8.00 mm
