Ja-cup/FiveLink/Design/3 Festehub/Beholdt deler/KileL44.stp

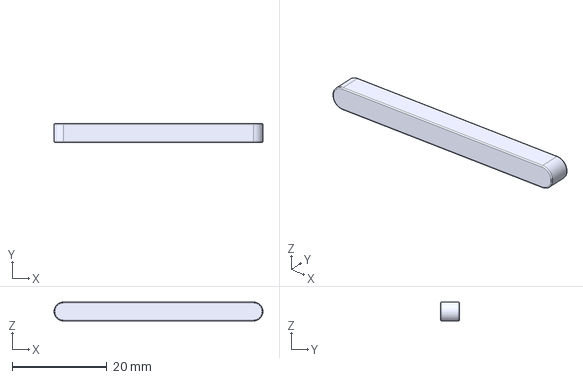
[picture p54: CAD file, 2025-08-07]
Design/3 Festehub/Beholdt deler/KileL44.stp
44.0 x 4.00 x 4.00 mm
