Ja-cup/FiveLink/Design/3 Festehub/Motorbrakett deler/BrakettMotor nye motorer (4).stp

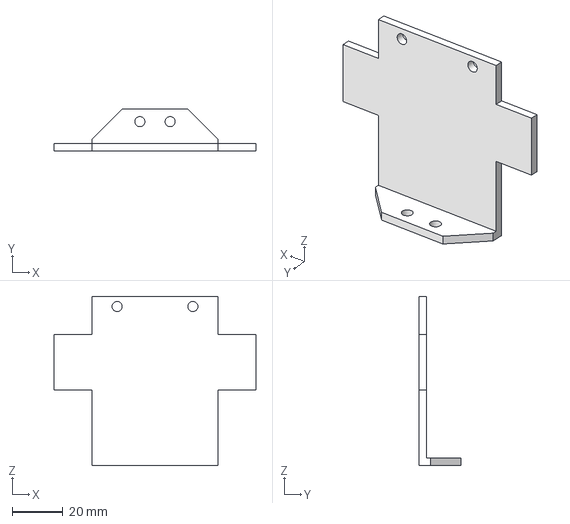
[picture p55: CAD file, 2025-08-07]
Design/3 Festehub/Motorbrakett deler/BrakettMotor nye motorer (4).stp
80.0 x 16.6 x 67.0 mm
