Ja-cup/FiveLink/Design/4 Armer/Aktiv arm.stp

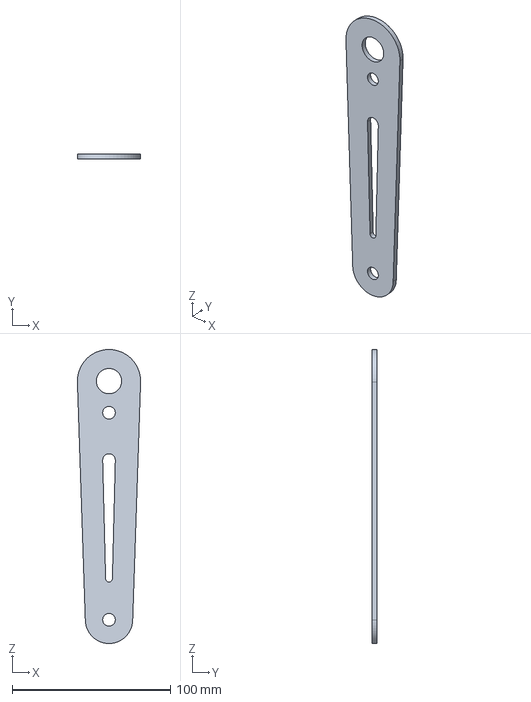
[picture p56: CAD file, 2025-08-07]
Design/4 Armer/Aktiv arm.stp
40.0 x 3.00 x 186.0 mm
