Ja-cup/FiveLink/Design/5 Stabilisator/117mm.stp

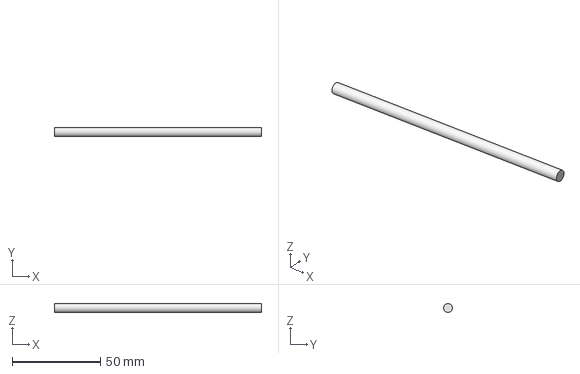
[picture p57: CAD file, 2025-08-07]
Design/5 Stabilisator/117mm.stp
117.0 x 5.00 x 5.00 mm
