Ja-cup/FiveLink/Design/6 Griper/Finger/Finger 60mm.stp

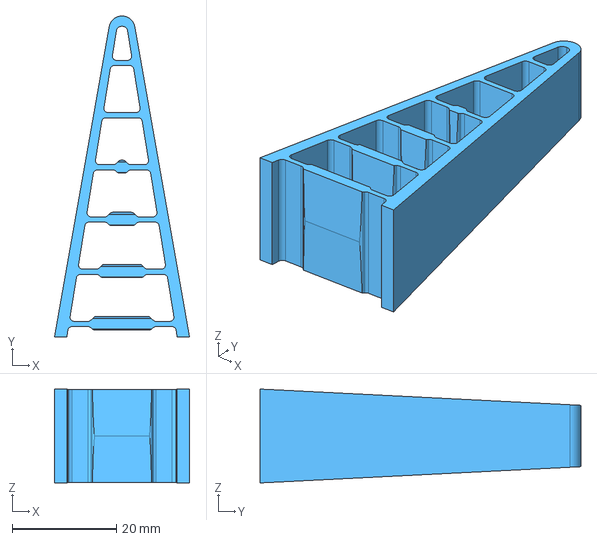
[picture p58: CAD file, 2025-08-07]
Design/6 Griper/Finger/Finger 60mm.stp
25.9 x 61.5 x 18.0 mm
