Ja-cup/FiveLink/Design/6 Griper/PingPongBall 40mm.stp

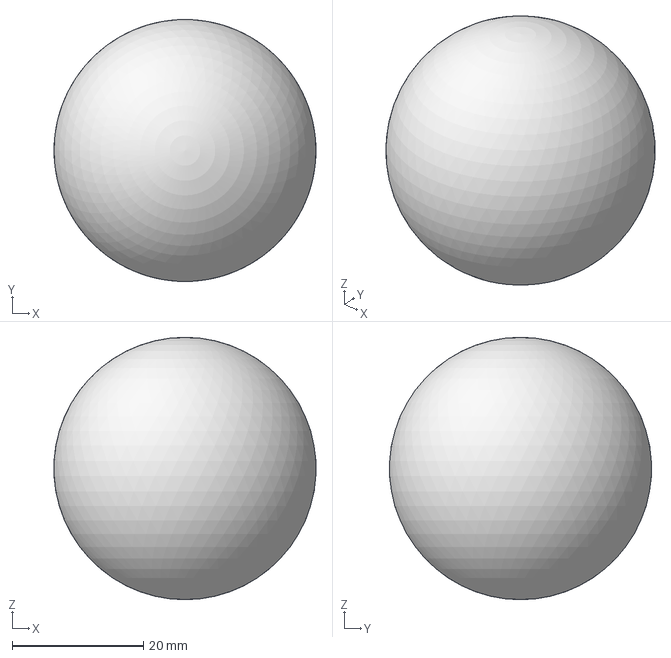
[picture p59: CAD file, 2025-08-07]
Design/6 Griper/PingPongBall 40mm.stp
39.9 x 39.9 x 40.0 mm
