Ja-cup/FiveLink/Design/6 Griper/Skruer/ANSI B18.3.1M - M2x0.4 x 16(2).stp

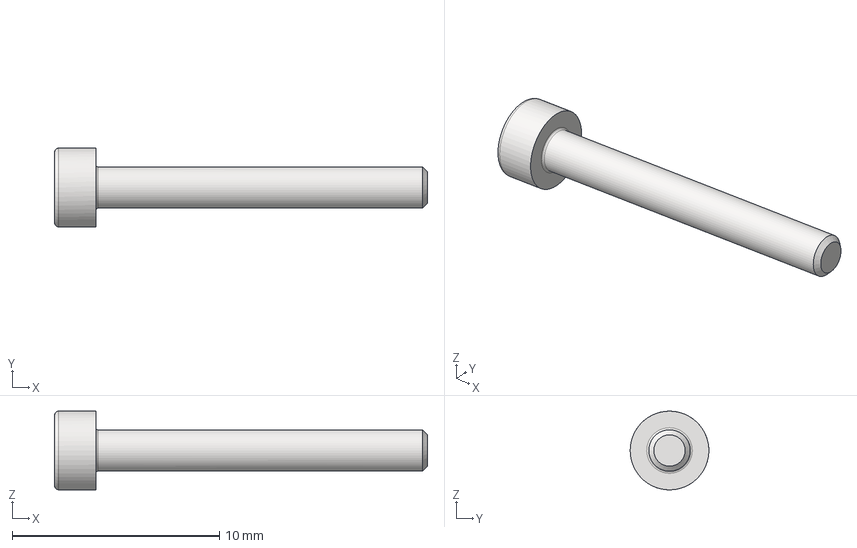
[picture p60: CAD file, 2025-08-07]
Design/6 Griper/Skruer/ANSI B18.3.1M - M2x0.4 x 16(2).stp
18.0 x 3.80 x 3.80 mm
