Ja-cup/FiveLink/Design/6 Griper/Toolhub/Plate.stp

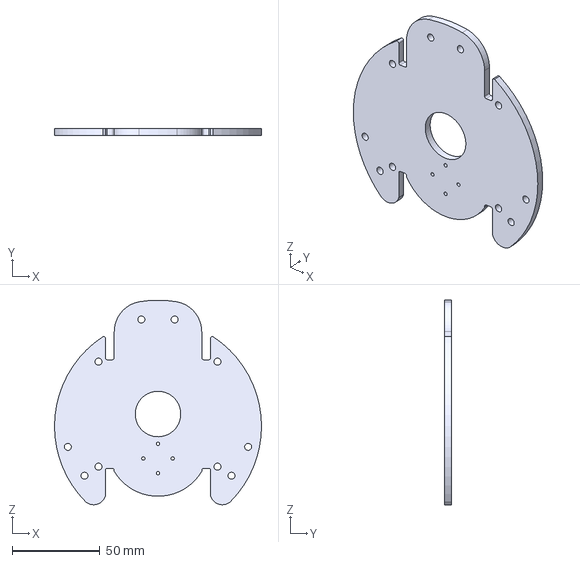
[picture p61: CAD file, 2025-08-07]
Design/6 Griper/Toolhub/Plate.stp
118.3 x 4.00 x 116.8 mm
