Ja-cup/FiveLink/Design/2 Tredje Akse/Beholdt deler/Aluminium shaft.stp

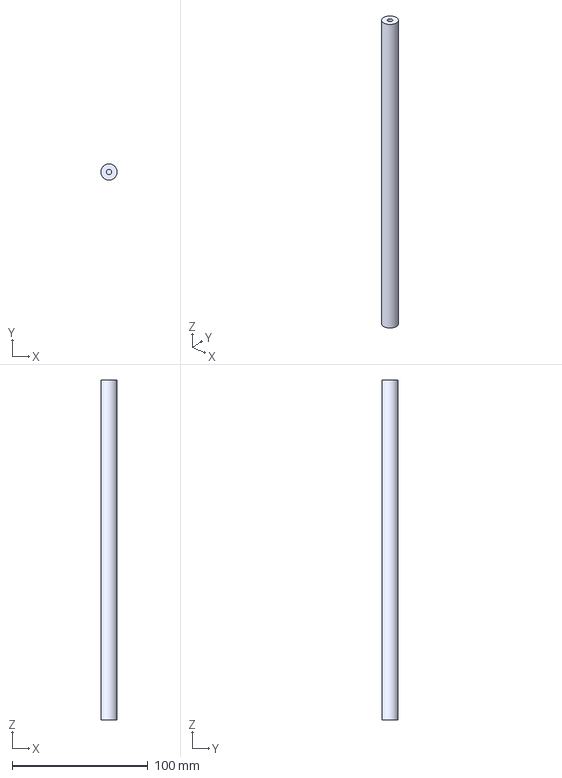
[picture p62: CAD file, 2025-08-07]
Design/2 Tredje Akse/Beholdt deler/Aluminium shaft.stp
12.0 x 12.0 x 250.0 mm
