Ja-cup/FiveLink/Design/3 Festehub/Beholdt deler/BallbearingSteel.stp

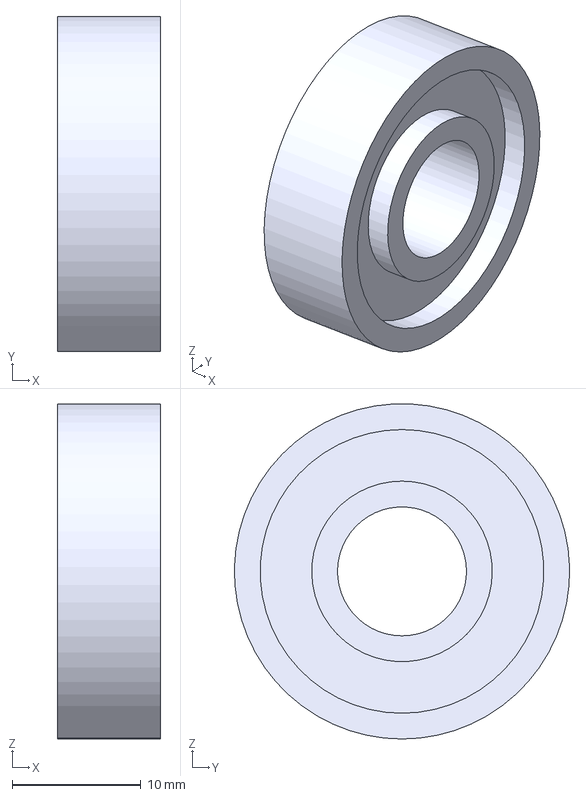
[picture p63: CAD file, 2025-08-07]
Design/3 Festehub/Beholdt deler/BallbearingSteel.stp
8.00 x 26.0 x 26.0 mm
