Ja-cup/FiveLink/Design/3 Festehub/Motorbrakett deler/BrakettMotor del 2.stp

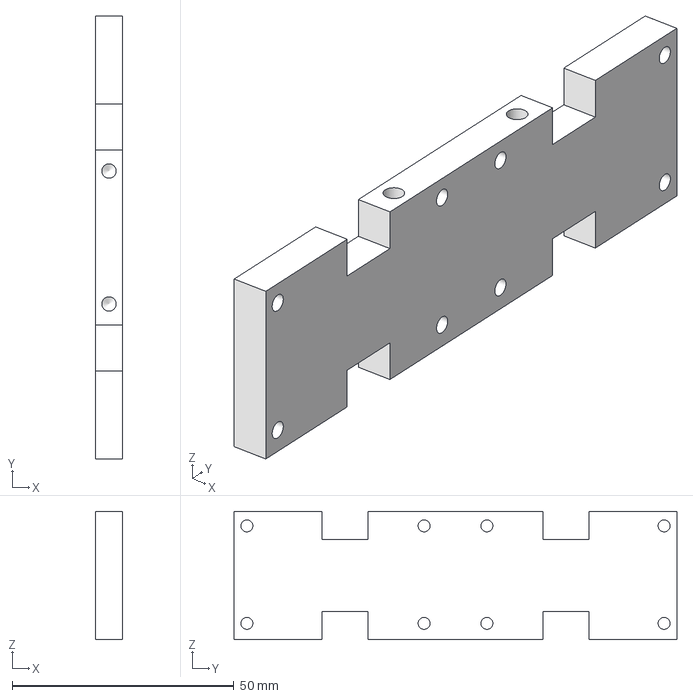
[picture p64: CAD file, 2025-08-07]
Design/3 Festehub/Motorbrakett deler/BrakettMotor del 2.stp
6.00 x 100.0 x 29.0 mm
