Ja-cup/FiveLink/Design/4 Armer/Avstiving.stp

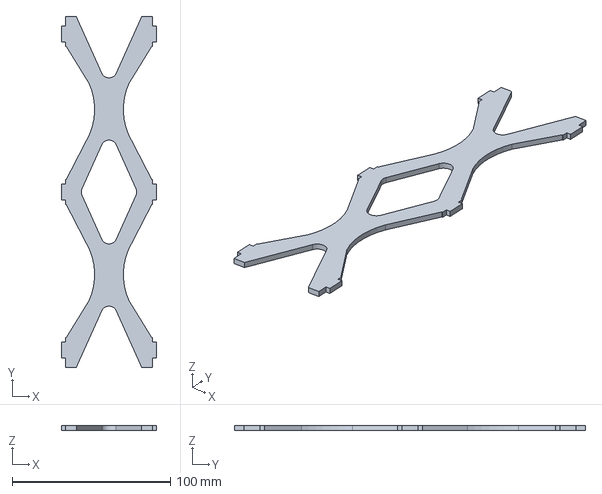
[picture p65: CAD file, 2025-08-07]
Design/4 Armer/Avstiving.stp
60.0 x 221.9 x 3.00 mm
