Ja-cup/FiveLink/Design/4 Armer/Beholdt deler/SleeveBearing 6x10.stp

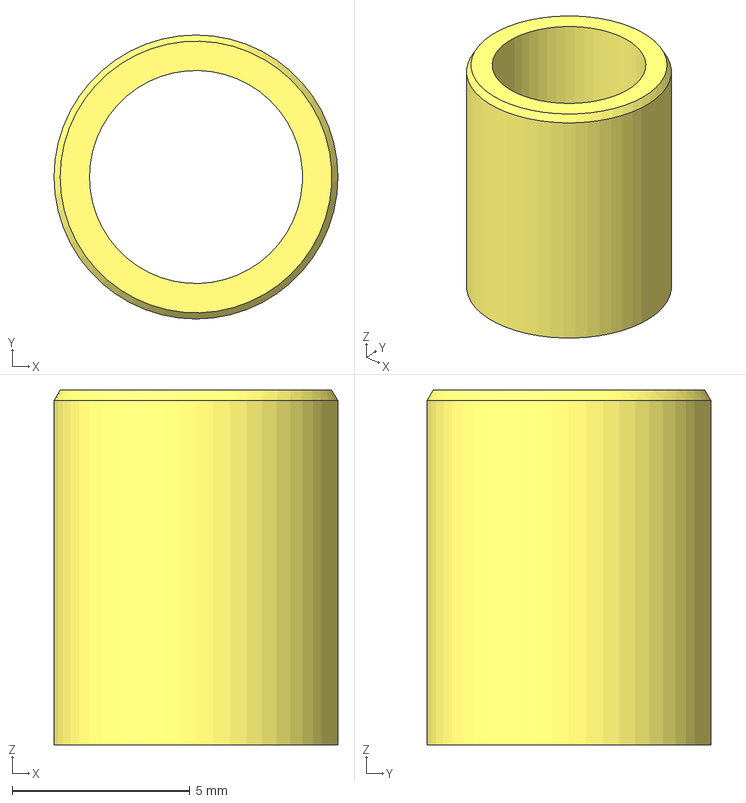
[picture p66: CAD file, 2025-08-07]
Design/4 Armer/Beholdt deler/SleeveBearing 6x10.stp
8.00 x 8.00 x 10.0 mm
