Ja-cup/FiveLink/Design/5 Stabilisator/HingePin stabilisator lange.stp

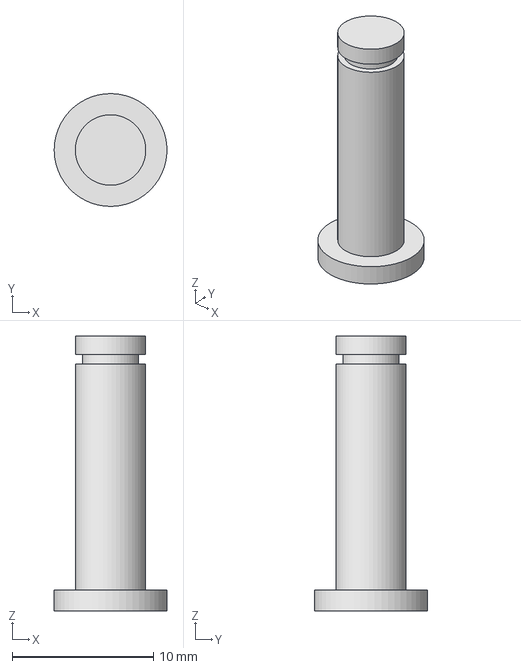
[picture p67: CAD file, 2025-08-07]
Design/5 Stabilisator/HingePin stabilisator lange.stp
7.99 x 8.00 x 19.5 mm
