Ja-cup/FiveLink/Design/6 Griper/ibh_GFM-0607-024_2025411_1214_model.stp

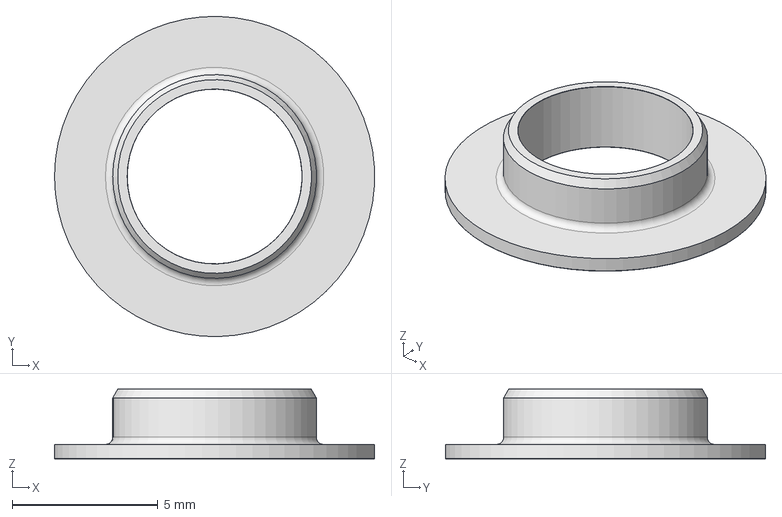
[picture p68: CAD file, 2025-08-07]
Design/6 Griper/ibh_GFM-0607-024_2025411_1214_model.stp
11.0 x 11.0 x 2.40 mm
