Ja-cup/FiveLink/Design/2 Tredje Akse/Beholdt deler/Endefeste.stp

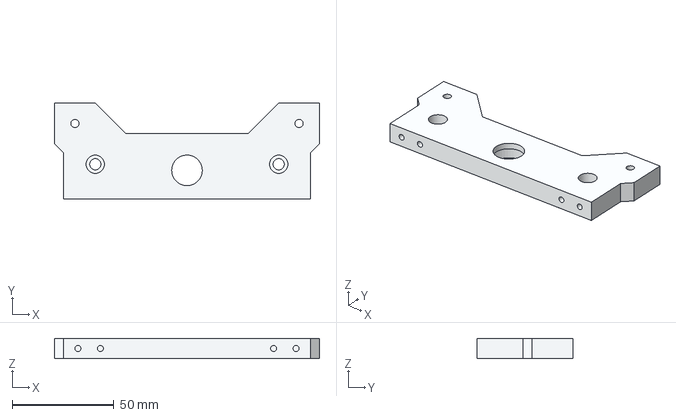
[picture p69: CAD file, 2025-08-07]
Design/2 Tredje Akse/Beholdt deler/Endefeste.stp
130.0 x 47.0 x 10.0 mm
