Ja-cup/FiveLink/Design/3 Festehub/Stabilisator adapter festehub.stp

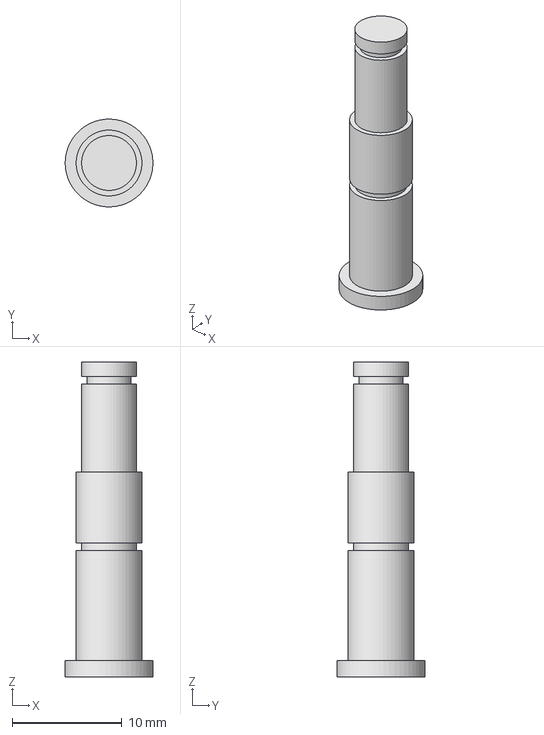
[picture p70: CAD file, 2025-08-07]
Design/3 Festehub/Stabilisator adapter festehub.stp
7.99 x 8.00 x 28.7 mm
