Ja-cup/FiveLink/Design/4 Armer/Arm med stabilisator.stp

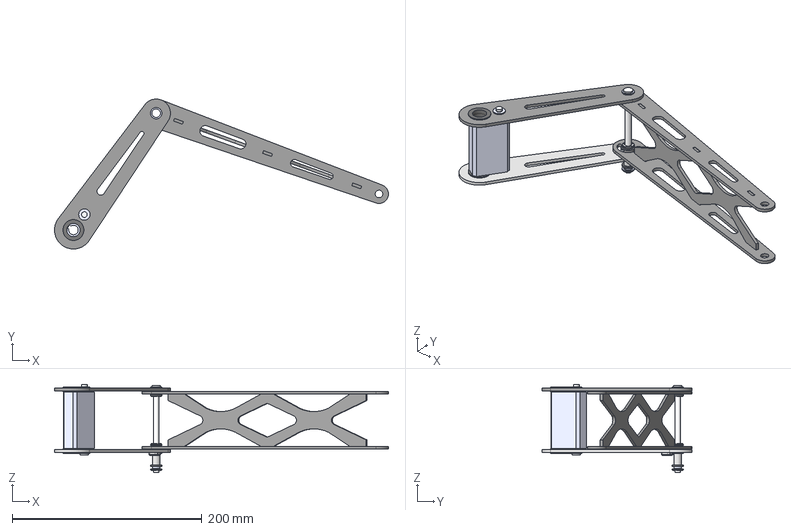
[picture p71: CAD file, 2025-08-07]
Design/4 Armer/Arm med stabilisator.stp
352.3 x 158.2 x 93.1 mm
Aksel-Arm Kobling
FlangeBearing 14x4mm x 4
HingePin AkselKobling
Flange bearindID6 x 7
Aktiv arm ny lengde (1)
Aktiv arm ny lengde
Passiv arm ny lengde
Passiv arm ny lengde V2 med stopper
HingePin ArmStab
ibh_ZSM-0608-12_2025429_1117_model
ThrusterBearing 6x1.5 x 3
NETWS5 x 3
Mechanical Stopper Screw
ibh_GFM-0607-024_2025411_1214_model x 2
Avstiving Med Grop
