Ja-cup/FiveLink/Design/5 Stabilisator/Stabilisator trekant.stp

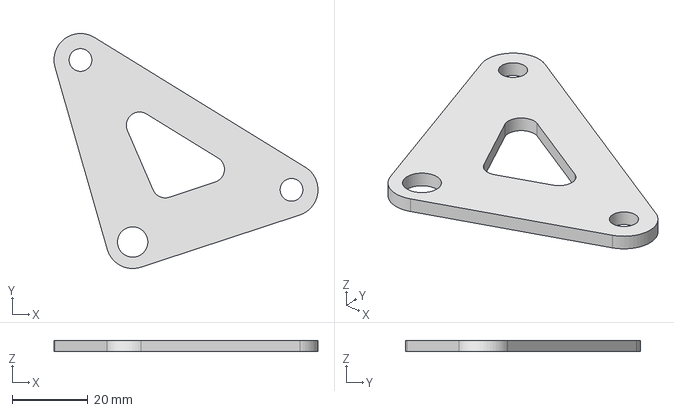
[picture p72: CAD file, 2025-08-07]
Design/5 Stabilisator/Stabilisator trekant.stp
69.7 x 62.1 x 3.00 mm
