Ja-cup/FiveLink/Design/2 Tredje Akse/Beholdt deler/MotorBrakett Rails.stp

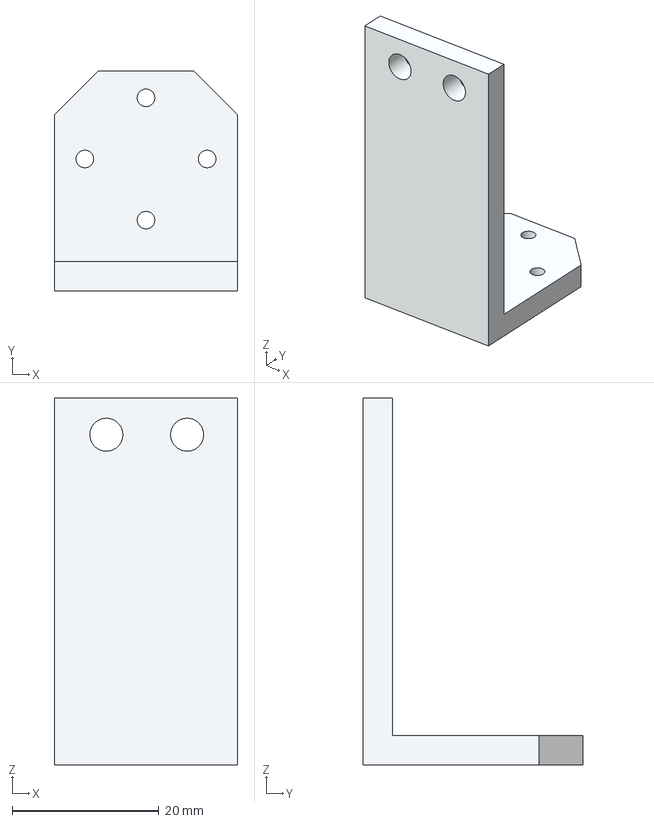
[picture p73: CAD file, 2025-08-07]
Design/2 Tredje Akse/Beholdt deler/MotorBrakett Rails.stp
25.0 x 30.0 x 50.0 mm
