Ja-cup/FiveLink/Design/5 Stabilisator/Stabilisator lange pinne.stp

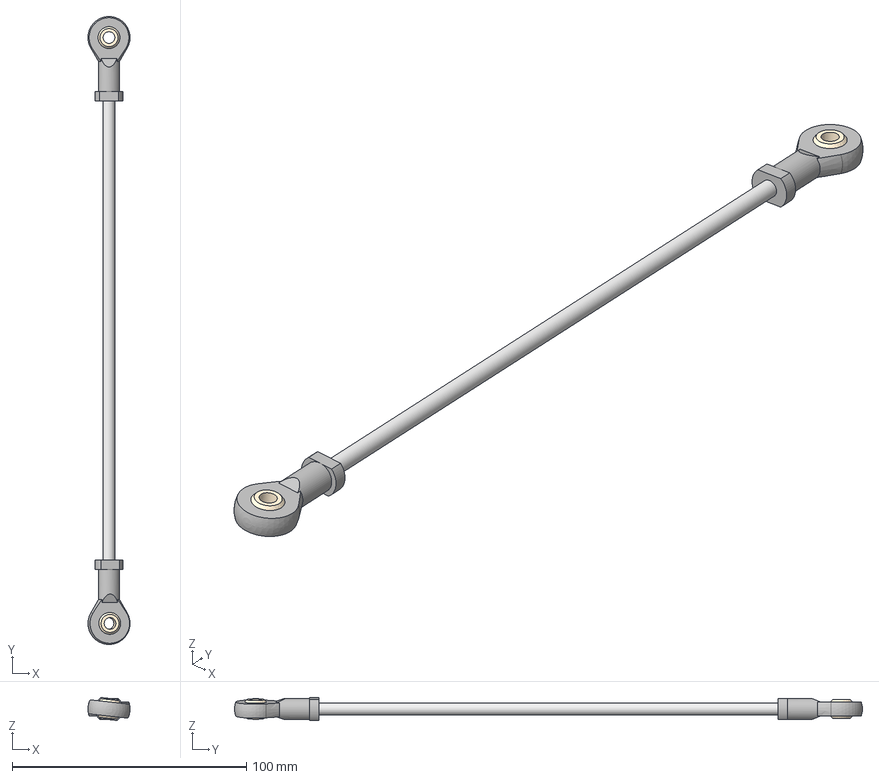
[picture p74: CAD file, 2025-08-07]
Design/5 Stabilisator/Stabilisator lange pinne.stp
18.0 x 268.0 x 9.83 mm
216mm
