Ja-cup/FiveLink/Design/6 Griper/DST_JFRM_131315DS5X5_1.stp

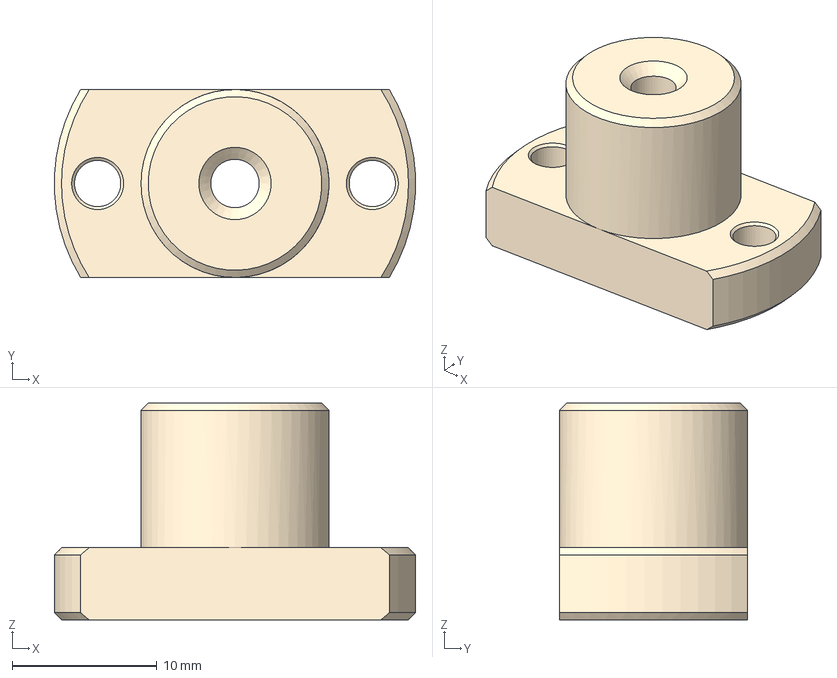
[picture p75: CAD file, 2025-08-07]
Design/6 Griper/DST_JFRM_131315DS5X5_1.stp
25.0 x 13.0 x 15.0 mm
