Ja-cup/FiveLink/Design/2 Tredje Akse/Beholdt deler/Retaining Ring  C8.stp

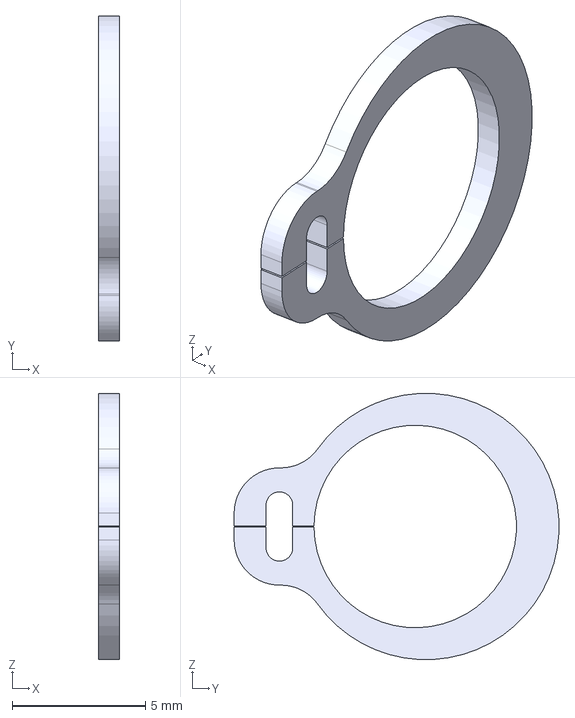
[picture p76: CAD file, 2025-08-07]
Design/2 Tredje Akse/Beholdt deler/Retaining Ring C8.stp
0.8 x 12.2 x 9.99 mm
