Ja-cup/FiveLink/Design/4 Armer/ibh_ZSM-0608-12_2025429_1117_model.stp

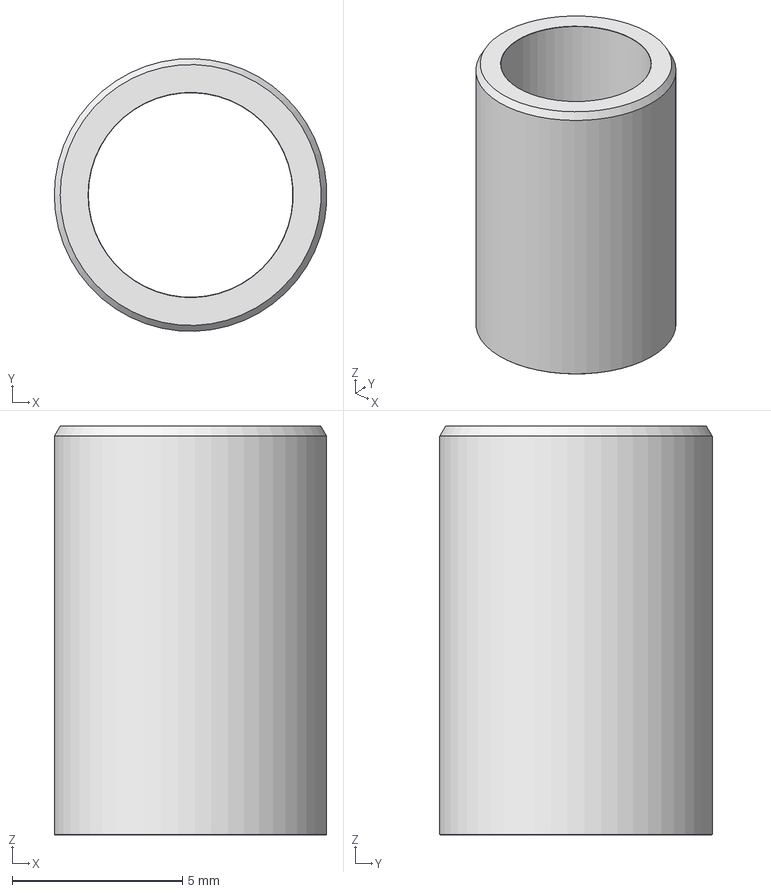
[picture p77: CAD file, 2025-08-07]
Design/4 Armer/ibh_ZSM-0608-12_2025429_1117_model.stp
7.99 x 8.00 x 12.0 mm
