Ja-cup/FiveLink/Design/5 Stabilisator/Stabilisator korte pinne.stp

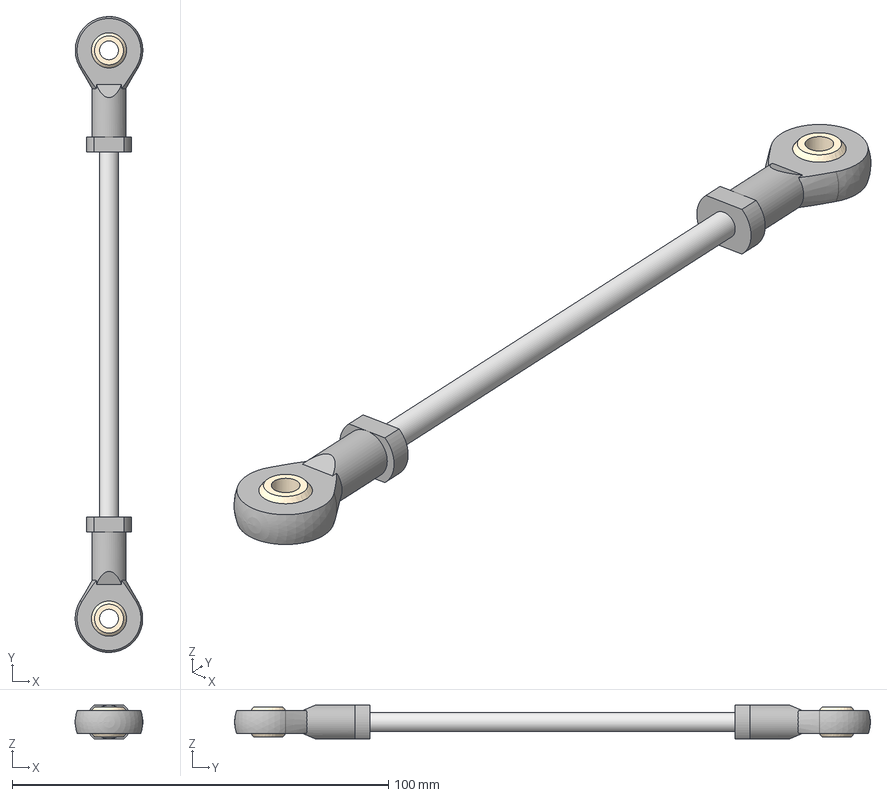
[picture p78: CAD file, 2025-08-07]
Design/5 Stabilisator/Stabilisator korte pinne.stp
18.0 x 169.0 x 9.00 mm
117mm
