Ja-cup/FiveLink/Design/2 Tredje Akse/Beholdt deler/Linear Bearing 12.stp

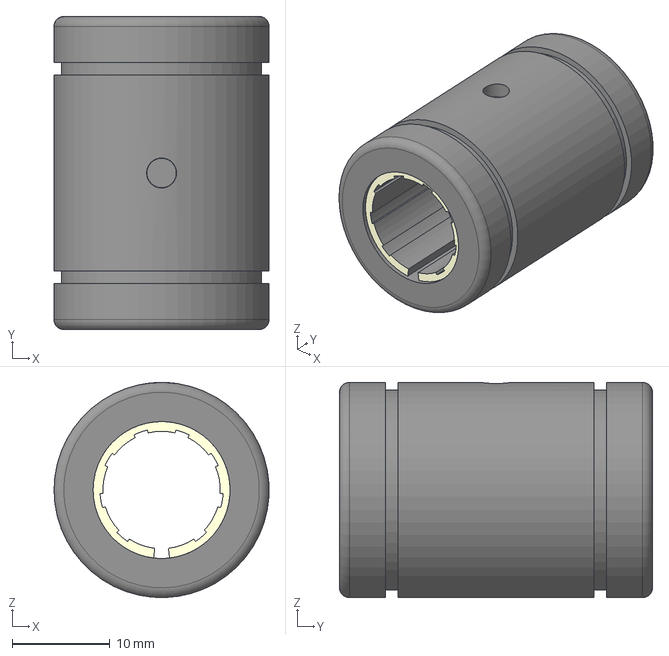
[picture p79: CAD file, 2025-08-07]
Design/2 Tredje Akse/Beholdt deler/Linear Bearing 12.stp
22.0 x 32.0 x 22.0 mm
