Ja-cup/FiveLink/Design/4 Armer/HingePin ArmStab.stp

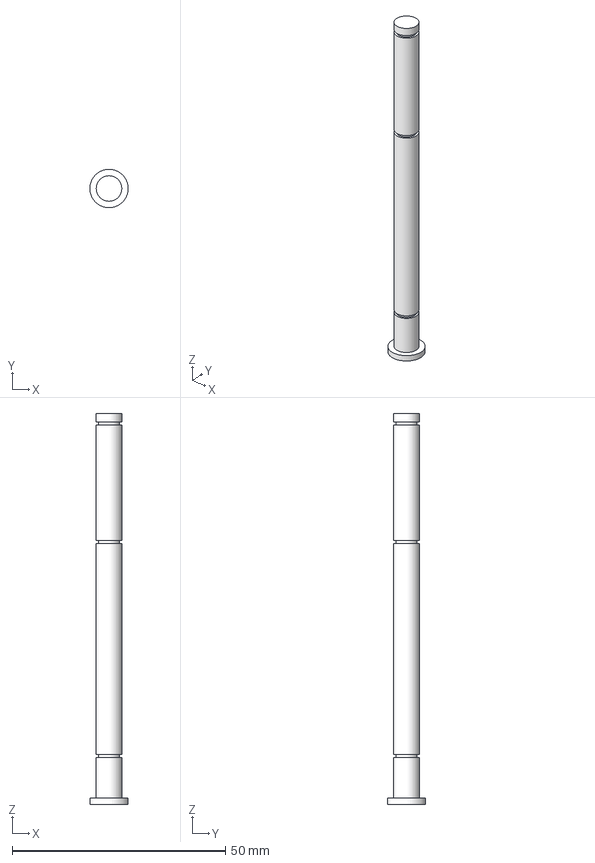
[picture p80: CAD file, 2025-08-07]
Design/4 Armer/HingePin ArmStab.stp
8.99 x 9.00 x 91.8 mm
