Ja-cup/FiveLink/Design/5 Stabilisator/216mm.stp

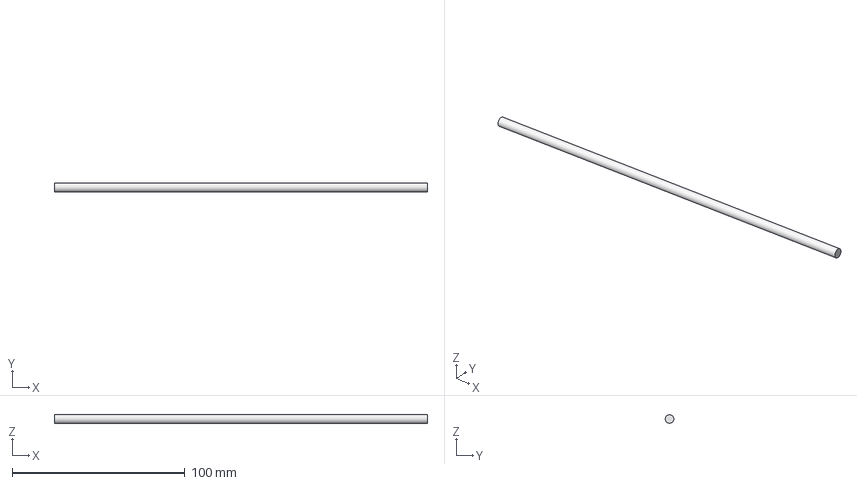
[picture p81: CAD file, 2025-08-07]
Design/5 Stabilisator/216mm.stp
216.0 x 5.00 x 5.00 mm
