Ja-cup/FiveLink/Design/6 Griper/Midtplate.stp

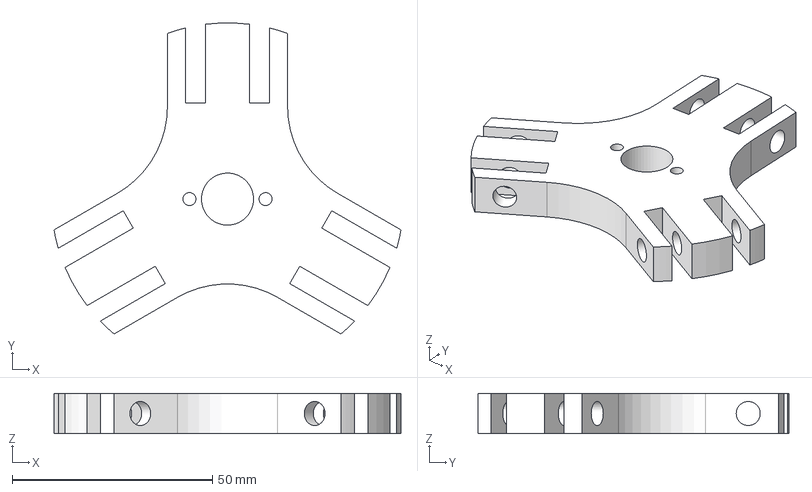
[picture p82: CAD file, 2025-08-07]
Design/6 Griper/Midtplate.stp
86.6 x 77.6 x 10.0 mm
