Ja-cup/FiveLink/Design/5 Stabilisator/HingePin stabilisator korte.stp

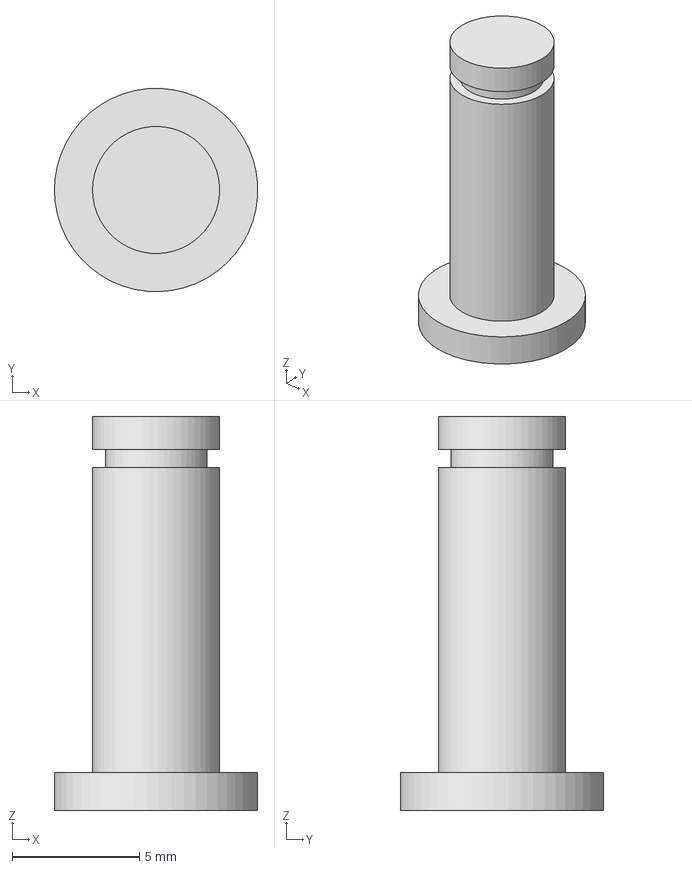
[picture p83: CAD file, 2025-08-07]
Design/5 Stabilisator/HingePin stabilisator korte.stp
7.99 x 8.00 x 15.5 mm
