Ja-cup/FiveLink/Design/6 Griper/fingerbeveger (1).stp

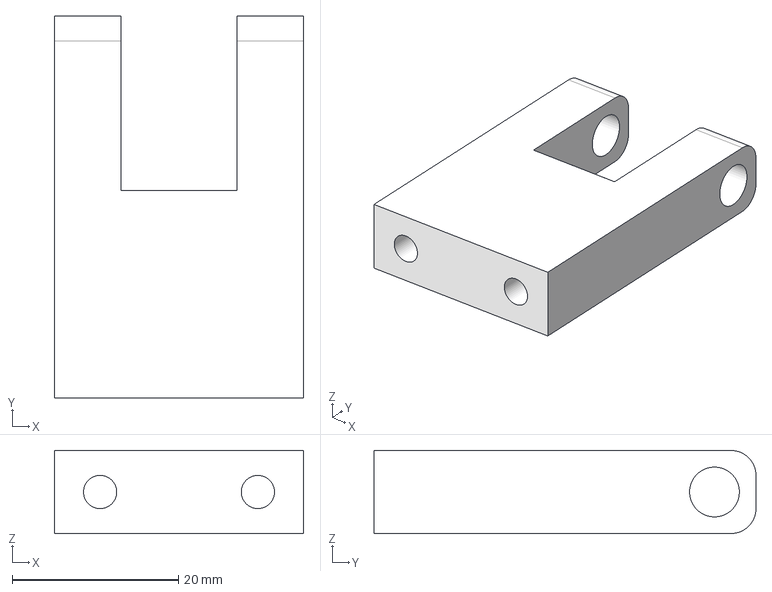
[picture p84: CAD file, 2025-08-07]
Design/6 Griper/fingerbeveger (1).stp
30.0 x 46.0 x 10.0 mm
