Ja-cup/FiveLink/Design/2 Tredje Akse/Beholdt deler/Item Profile 20x20x440.stp

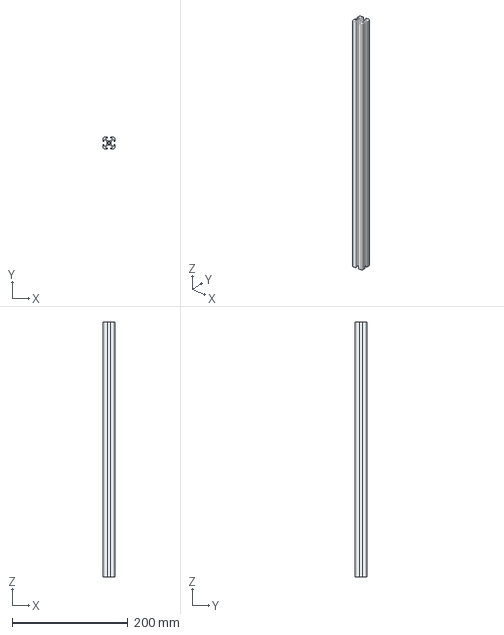
[picture p85: CAD file, 2025-08-07]
Design/2 Tredje Akse/Beholdt deler/Item Profile 20x20x440.stp
20.0 x 20.0 x 440.0 mm
