Ja-cup/FiveLink/(list of files, cad)

Other CAD files:
Design/3 Festehub/Forplate.stp
Design/4 Armer/Beholdt deler/ThrusterBearing 6x1.5.stp
Design/3 Festehub/Bakplate.stp
Design/4 Armer/Beholdt deler/Flange bearindID6.stp
Design/4 Armer/Beholdt deler/HingePin AkselKobling.stp
Design/4 Armer/Passiv arm.stp
Design/2 Tredje Akse/Beholdt deler/Feste Linear Bearings og LS Nut.stp
Design/2 Tredje Akse/Lead Screw 12-3.stp
Design/2 Tredje Akse/Skruer/M2x0,4 L10.stp
Design/2 Tredje Akse/Skruer/M2x0,4 L5.stp
Design/2 Tredje Akse/Skruer/M4x0,7 L12.stp
Design/2 Tredje Akse/Skruer/M4x0,7 L20.stp
Design/2 Tredje Akse/Skruer/M5x0,8 L12.stp
Design/2 Tredje Akse/Skruer/M5x0,8 L15.stp
Design/2 Tredje Akse/Skruer/M5x0,8 L25.stp
Design/3 Festehub/62331200.stp
Design/3 Festehub/Motorbrakett deler/619706012.stp
Design/3 Festehub/Skruer/M2x0,4 L5.stp
Design/3 Festehub/Skruer/M4x0,7 L12.stp
Design/3 Festehub/Skruer/M4x0,7 L14.stp
Design/3 Festehub/Skruer/M6x1,0 L20.stp
Design/4 Armer/Mechanical Stopper Screw.stp
Design/6 Griper/619706020.stp
Design/6 Griper/619706030.stp
Design/6 Griper/65200500.stp
Design/6 Griper/Finger/4464306 DHAS-ME-H9-60---(befestigung).stp
Design/6 Griper/Finger/Hexagon bolt DIN 933 - M3x22.stp
Design/6 Griper/Skruer/M4x0,7 L12.stp
Design/6 Griper/Skruer/M4x0,7 L14.stp
Design/6 Griper/Skruer/M4x0,7 L20.stp
