Ja-cup/FiveLink/Software/tutorial.png

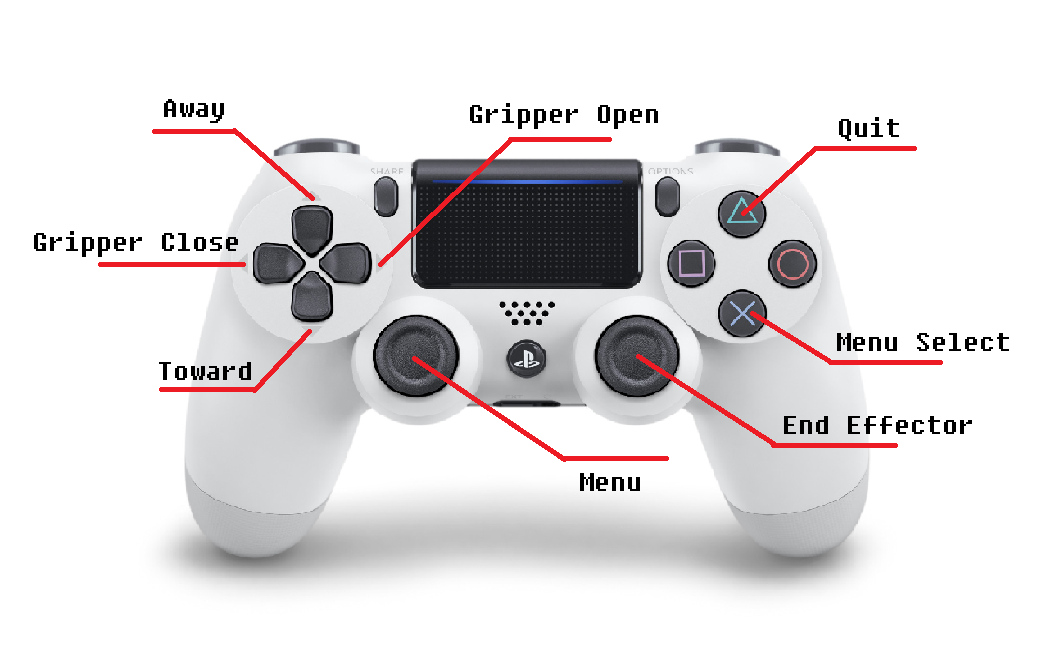
Software/tutorial.png
