Ja-cup/FiveLink/Design/Robotarm drawing (utdatert).pdf

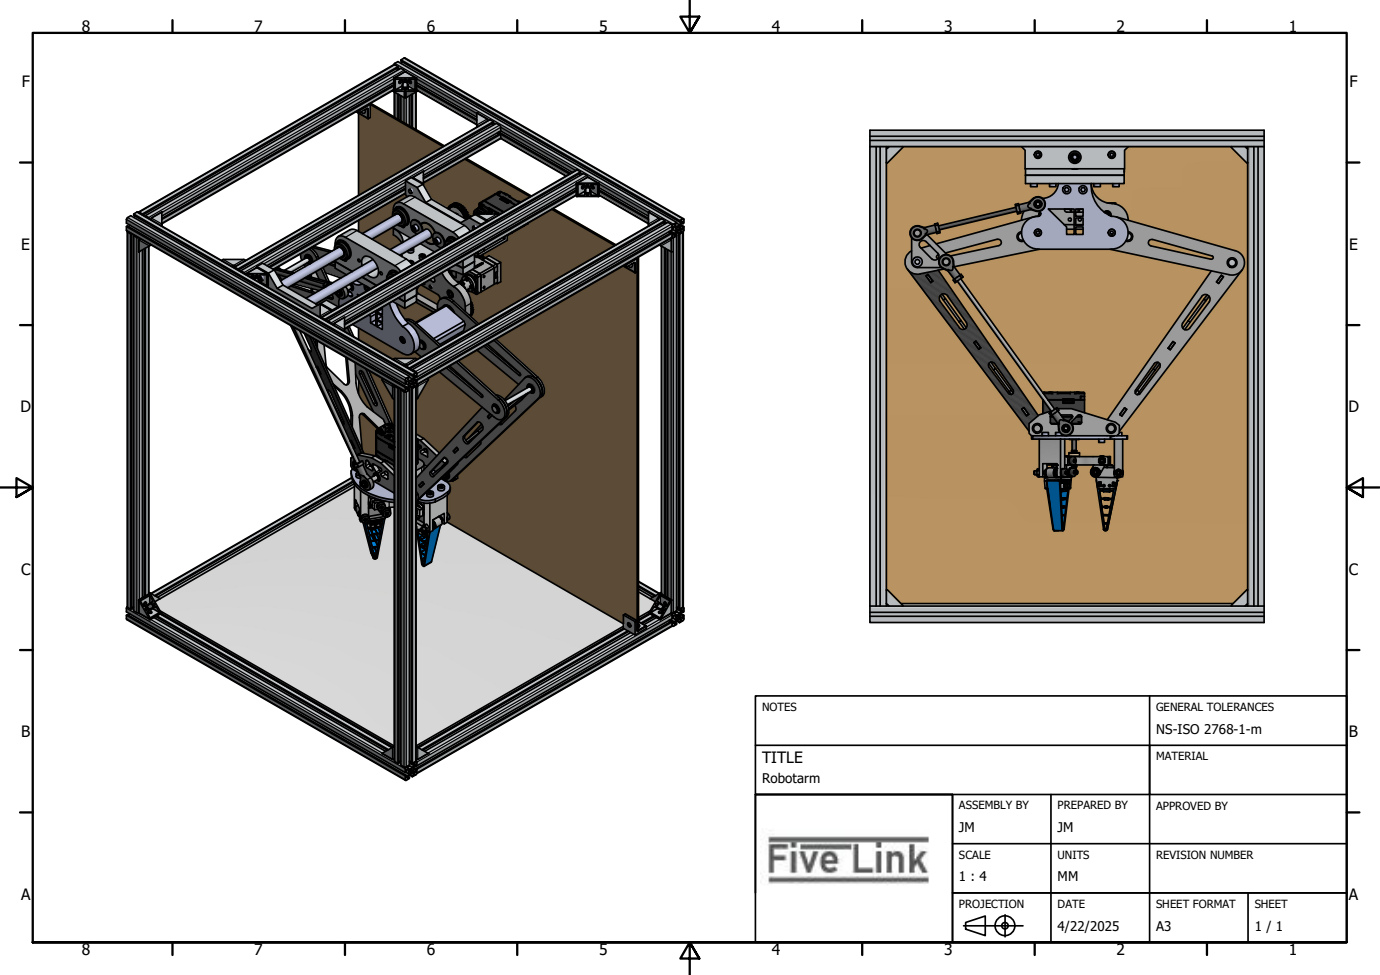
[picture p87: page 1]

NOTES | GENERAL TOLERANCES NS-ISO 2768-1-m

TITLE Robotarm | MATERIAL

ASSEMBLY BY JM | PREPARED BY JM | APPROVED BY

SCALE 1 : 4 | UNITS MM | REVISION NUMBER

PROJECTION | | DATE 4/22/2025 | SHEET FORMAT A3 | SHEET 1 / 1
