Ja-cup/FiveLink/Design/6 Griper/Griper Drawing (utdatert).pdf

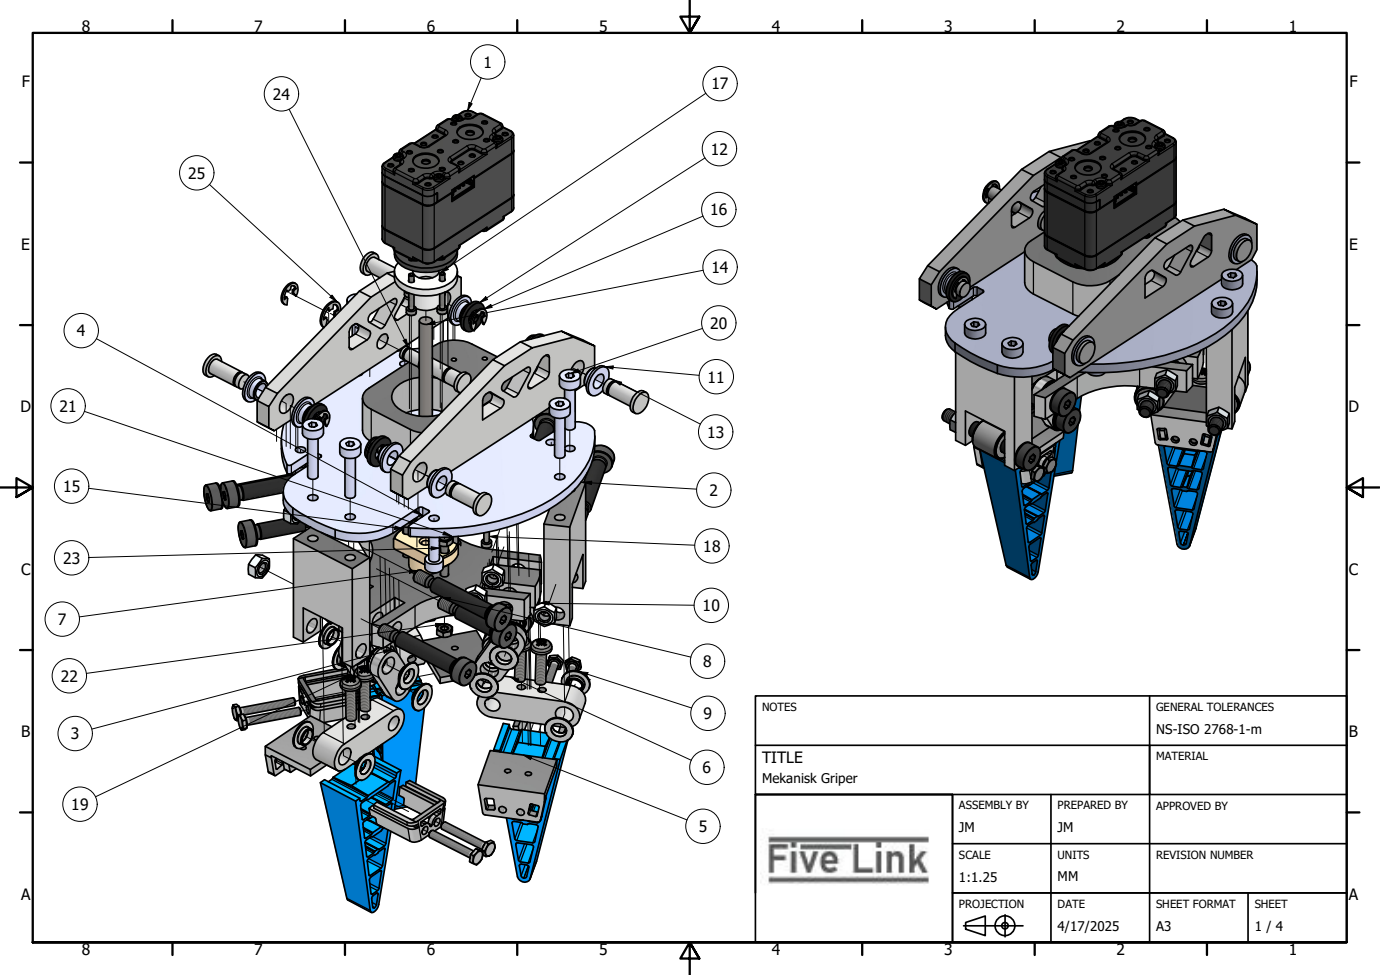
[picture p88: page 1]

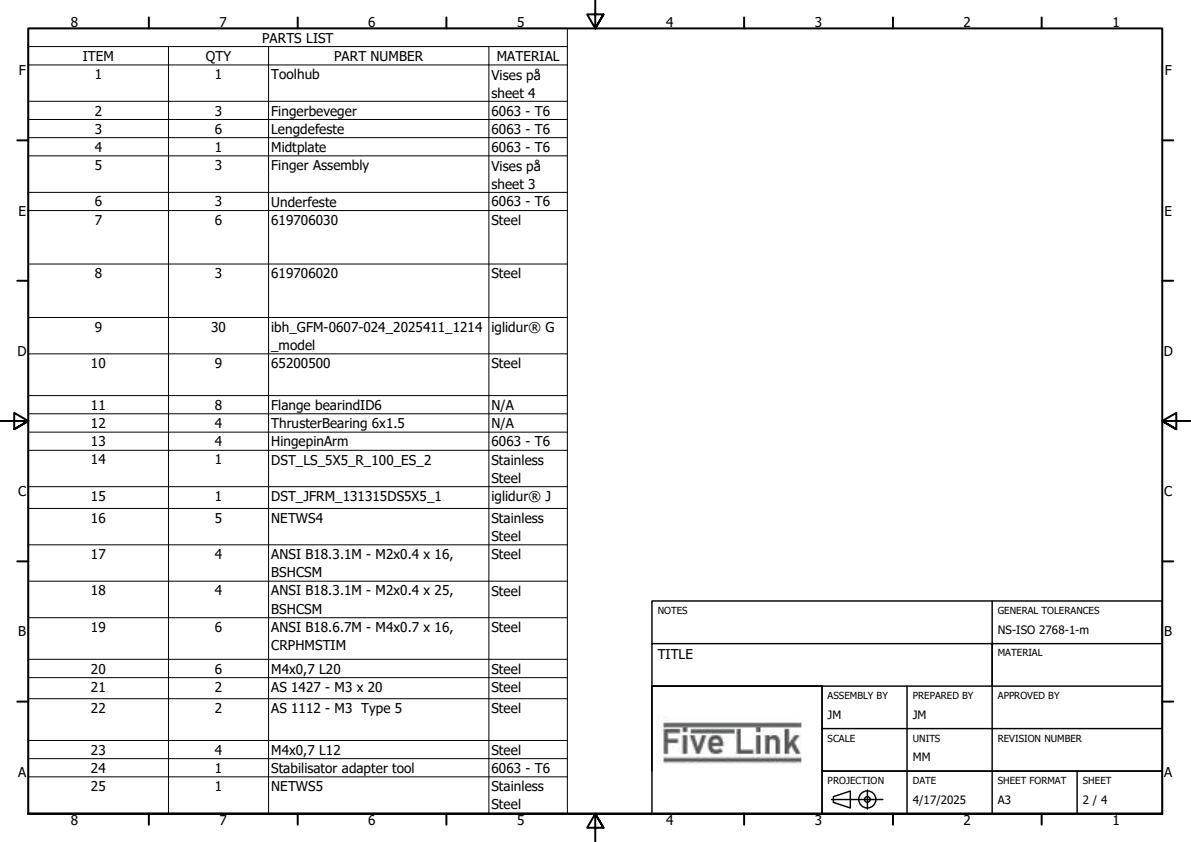
[picture p89: page 2]
NETWS4 ANSI B18.3.1M - M2x0.4 x 16,; Steel BSHCSM 17; ANSI B18.3.1M - M2x0.4 x 25,; Steel BSHCSM 18; ANSI B18.6.7M - M4x0.7 x 16,; Steel CRPHMSTIM 19; Steel 21; Steel 22; AS 1112 - M3 Type 5; Steel 23; Steel 24; Stabilisator adapter tool

I T E M | Q TY | P A RT N U M B E R | M AT E R I A L
1 | 1 | T o olh u b | V i s e s p å s h e e t 4

2 | 3 | F i n g e r b e v e g e r | 6 0 6 3 -T 6
3 | 6 | L e n g d e fe s t e | 6 0 6 3 -T 6
4 | 1 | M i d t pla t e | 6 0 6 3 -T 6
5 | 3 | F i n g e r A s s e m bly | V i s e s p å s h e e t 3

6 | 3 | U n d e r fe s t e | 6 0 6 3 -T 6
7 | 6 3 | 6 619706020 1 9 7 0 6 0 3 0 | S Steel ibh_GFM-0607-024_2025411_1214 iglidu t e el 8

8 4 4 | Flange bearindID6 ThrusterBearing 6x1.5 HingepinArm 0 0 | S N/A 12 N/A 13 6063 t e el 11

1 1 | DST_LS_5X5_R_100_ES_2 15 DST_JFRM_131315DS5X5_1 | S iglidu t a i el 14 nle s s S t e

r ® J
S t a i nle s s S t e

1 | NETWS5 | S t a i el 25 nle s s S t e

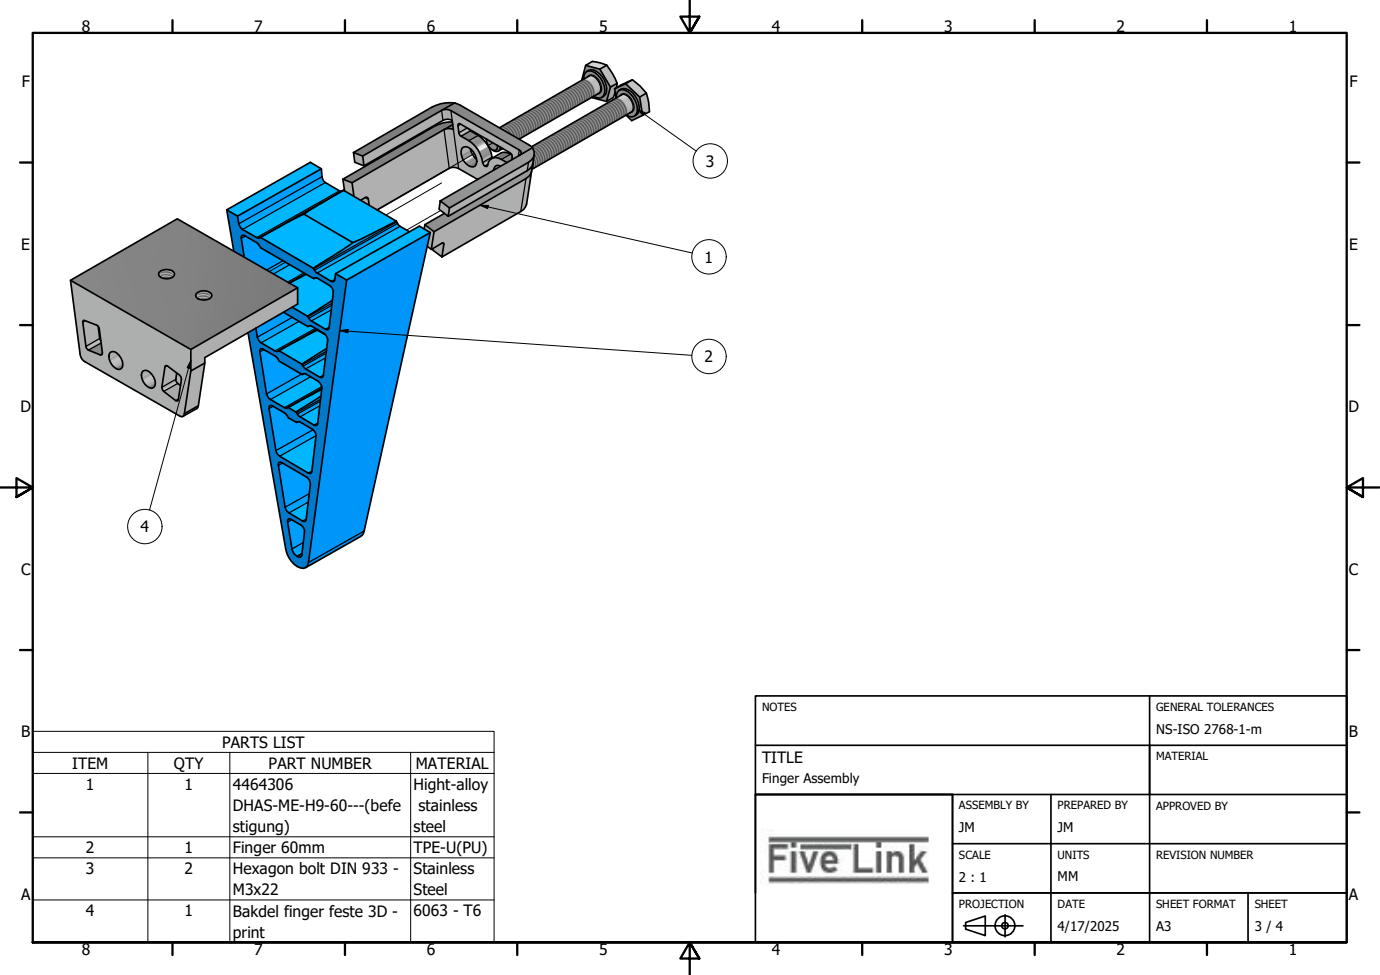
[picture p90: page 3]
PARTS LIST

NOTES | GENERAL TOLERANCES NS-ISO 2768-1-m

TITLE Finger Assembly | MATERIAL

ITEM | QTY | PART NUMBER | MATERIAL
1 | 1 | 4464306 DHAS-ME-H9-60---(befe stigung) | Hight-alloy stainless steel

ASSEMBLY BY JM | PREPARED BY JM | APPROVED BY

2 | 1 | Finger 60mm | TPE-U(PU)
3 | 2 | Hexagon bolt DIN 933 -M3x22 | Stainless Steel

SCALE 2 : 1 | UNITS MM | REVISION NUMBER

PROJECTION | | DATE 4/17/2025 | SHEET FORMAT A3 | SHEET 3 / 4

4 | 1 | Bakdel finger feste 3D -print | 6063 - T6

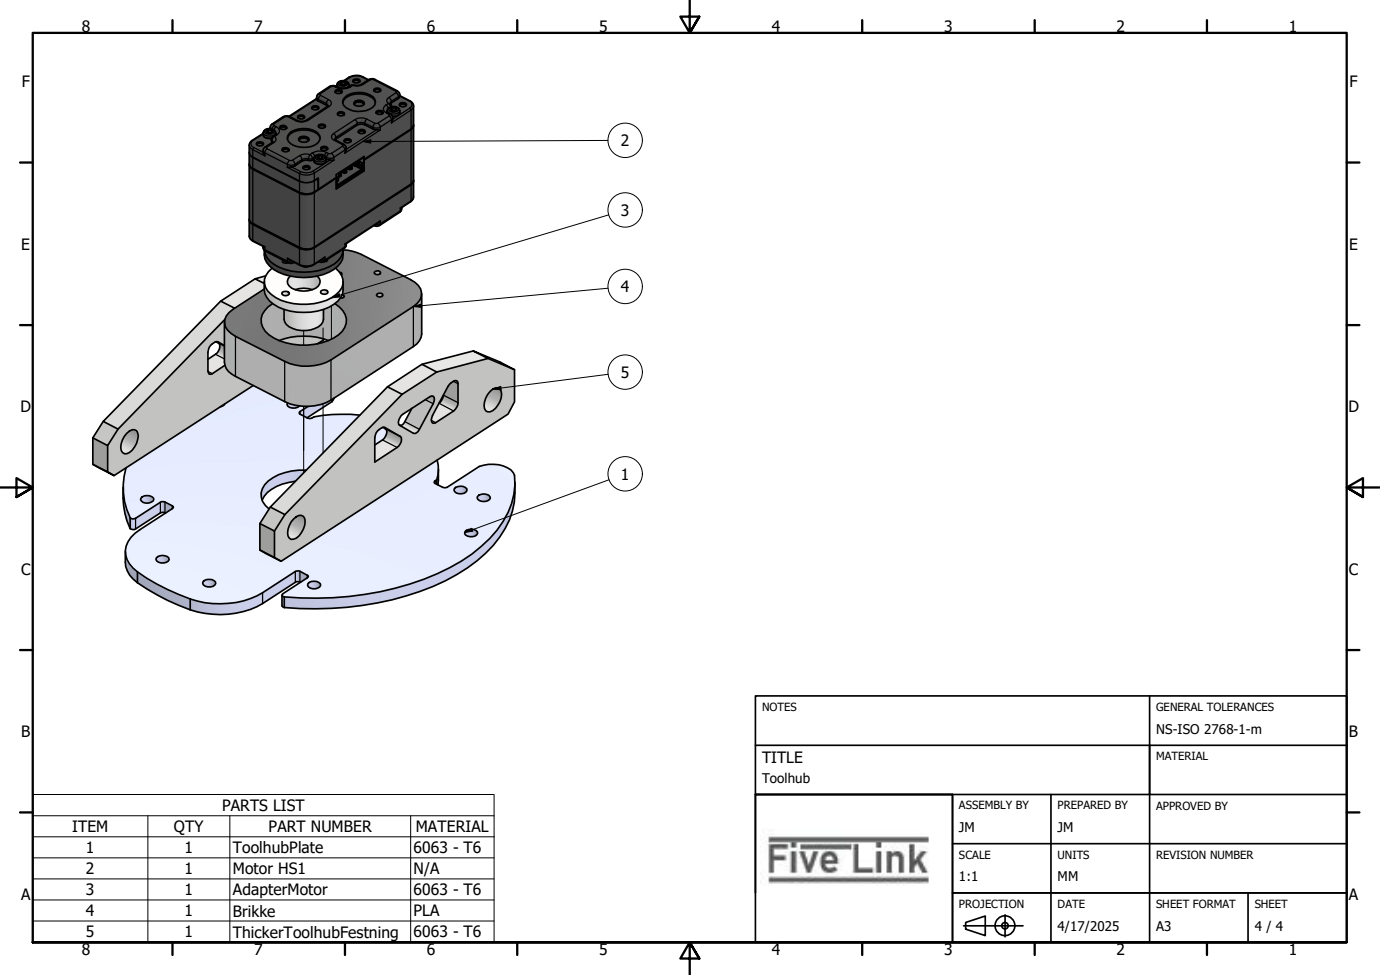
[picture p91: page 4]
PARTS LIST; ASSEMBLY BY; APPROVED BY; PREPARED BY

NOTES | GENERAL TOLERANCES NS-ISO 2768-1-m

TITLE Toolhub | MATERIAL

ITEM | QTY | PART NUMBER | MATERIAL
1 | 1 | ToolhubPlate | 6063 - T6
2 | 1 | Motor HS1 | N/A
3 | 1 | AdapterMotor | 6063 - T6
4 | 1 | Brikke | PLA
5 | 1 | ThickerToolhubFestning | 6063 - T6

SCALE 1:1 | UNITS MM | REVISION NUMBER

PROJECTION | | DATE 4/17/2025 | SHEET FORMAT A3 | SHEET 4 / 4
