Ja-cup/FiveLink/Design/3 Festehub/Festehub drawing (utdatert).pdf

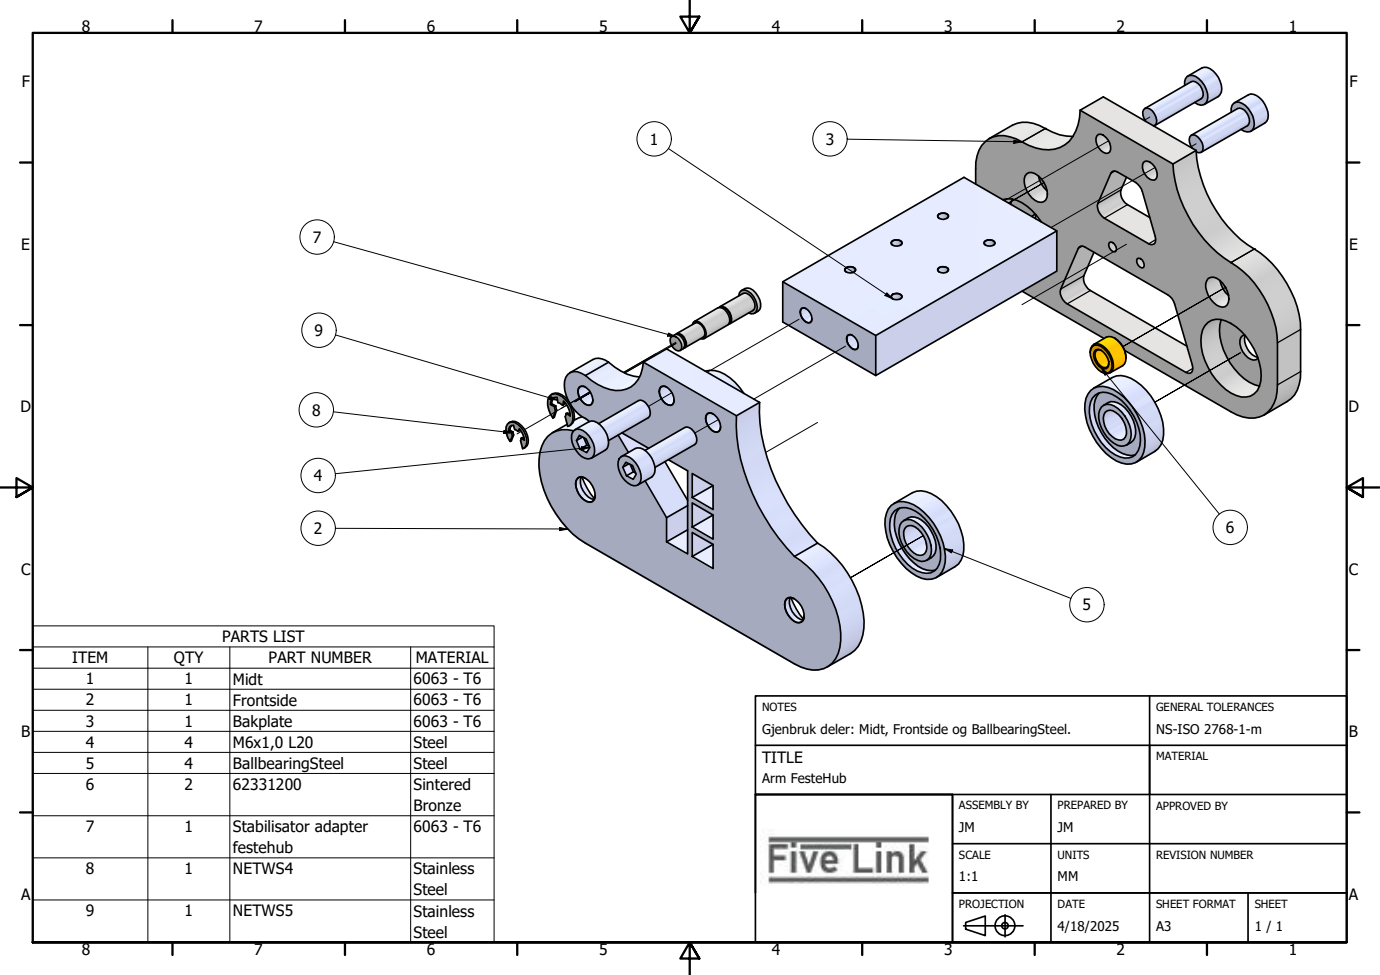
[picture p92: page 1]
PARTS LIST

ITEM | QTY | PART NUMBER | MATERIAL
1 | 1 | Midt | 6063 - T6
2 | 1 | Frontside | 6063 - T6
3 | 1 | Bakplate | 6063 - T6
4 | 4 | M6x1,0 L20 | Steel
5 | 4 | BallbearingSteel | Steel
6 | 2 | 62331200 | Sintered Bronze

NOTES Gjenbruk deler: Midt, Frontside og BallbearingSteel. | GENERAL TOLERANCES NS-ISO 2768-1-m

TITLE Arm FesteHub | MATERIAL

ASSEMBLY BY JM | PREPARED BY JM | APPROVED BY

7 | 1 | Stabilisator adapter festehub | 6063 - T6

SCALE 1:1 | UNITS MM | REVISION NUMBER

8 | 1 | NETWS4 | Stainless Steel

PROJECTION | | DATE 4/18/2025 | SHEET FORMAT A3 | SHEET 1 / 1

9 | 1 | NETWS5 | Stainless Steel
