Ja-cup/FiveLink/Design/3 Festehub/MotorBrakett drawing (utdatert).pdf

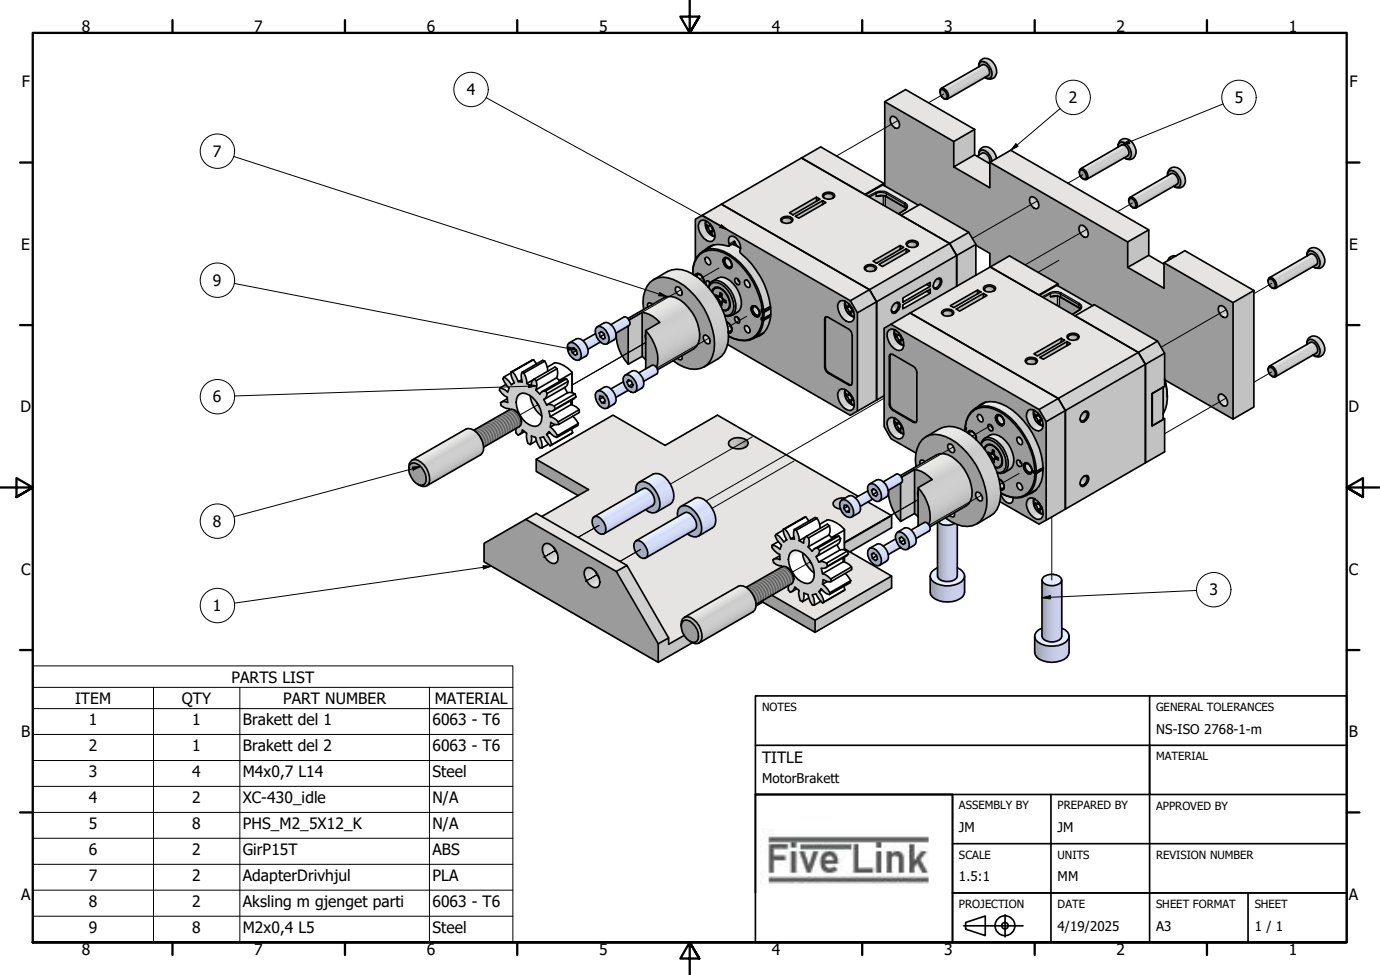
[picture p93: page 1]
PARTS LIST; Aksling m gjenget parti; Steel; SHEET FORMAT

ITEM | QTY | PART NUMBER | MATERIAL
1 | 1 | Brakett del 1 | 6063 - T6
2 | 1 | Brakett del 2 | 6063 - T6
3 | 4 | M4x0,7 L14 | Steel
4 5 | 2 8 | XC-430_idle PHS_M2_5X12_K | N/A

NOTES | GENERAL TOLERANCES NS-ISO 2768-1-m

TITLE MotorBrakett | MATERIAL

ASSEMBLY BY JM | PREPARED BY JM | APPROVED BY

6 | 2 | GirP15T | ABS
7 | 2 | AdapterDrivhjul | PLA

SCALE 1.5:1 | UNITS MM | REVISION NUMBER
