Ja-cup/FiveLink/Design/4 Armer/Arm med stabilisator drawing (utdatert).pdf

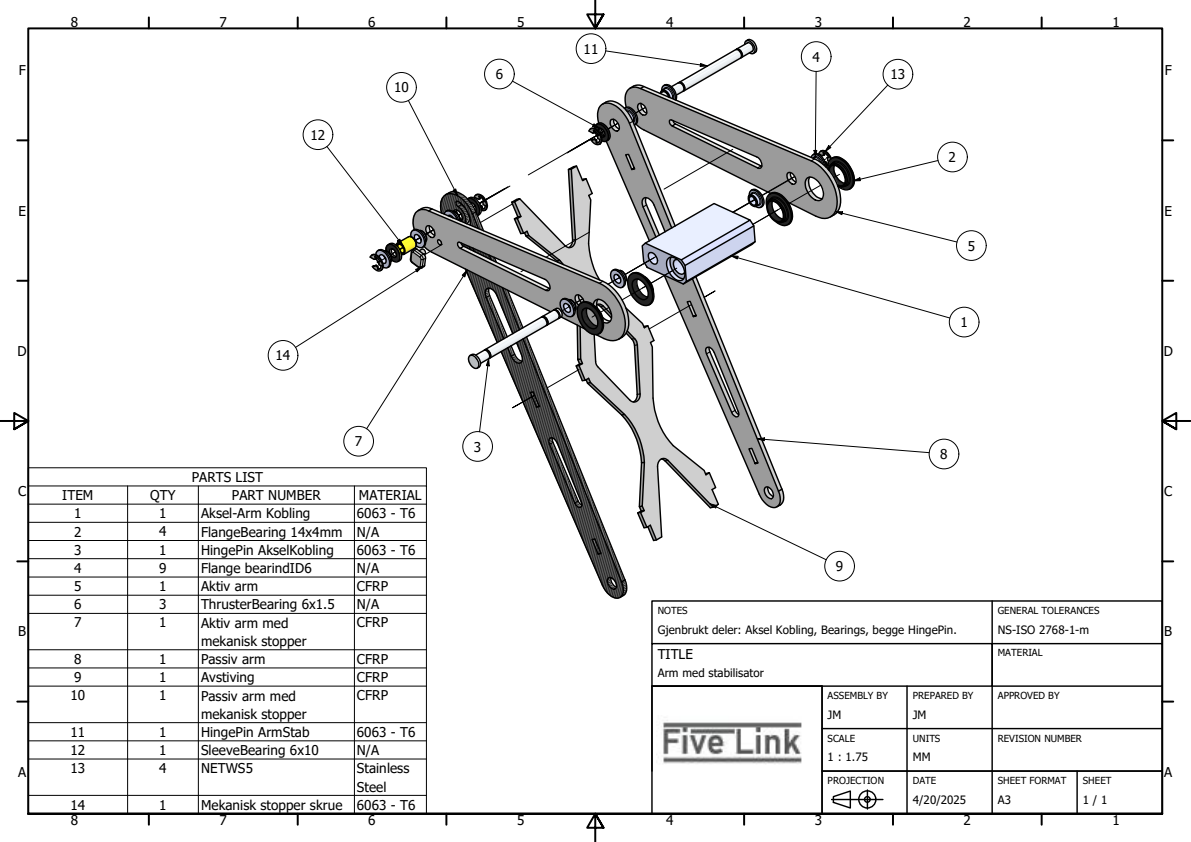
[picture p94: page 1]
PARTS LIST; Passiv arm med; CFRP; mekanisk stopper; ASSEMBLY BY; APPROVED BY; PREPARED BY

ITEM | QTY | PART NUMBER | MATERIAL
1 | 1 | Aksel-Arm Kobling | 6063 - T6
2 | 4 | FlangeBearing 14x4mm | N/A
3 | 1 | HingePin AkselKobling | 6063 - T6
4 | 9 | Flange bearindID6 | N/A
5 | 1 | Aktiv arm | CFRP
6 | 3 | ThrusterBearing 6x1.5 | N/A
7 | 1 | Aktiv arm med mekanisk stopper | CFRP

NOTES Gjenbrukt deler: Aksel Kobling, Bearings, begge HingePin. | GENERAL TOLERANCES NS-ISO 2768-1-m

TITLE Arm med stabilisator | MATERIAL

8 | 1 | Passiv arm | CFRP
9 | 1 | Avstiving | CFRP

11 | 1 | HingePin ArmStab | 6063 - T6
12 | 1 | SleeveBearing 6x10 | N/A
13 | 4 | NETWS5 | Stainless Steel

SCALE 1 : 1.75 | UNITS MM | REVISION NUMBER

PROJECTION | | DATE 4/20/2025 | SHEET FORMAT A3 | SHEET 1 / 1

14 | 1 | Mekanisk stopper skrue | 6063 - T6
