Ja-cup/FiveLink/Design/4 Armer/Arm uten stabilisator drawing (utdatert).pdf

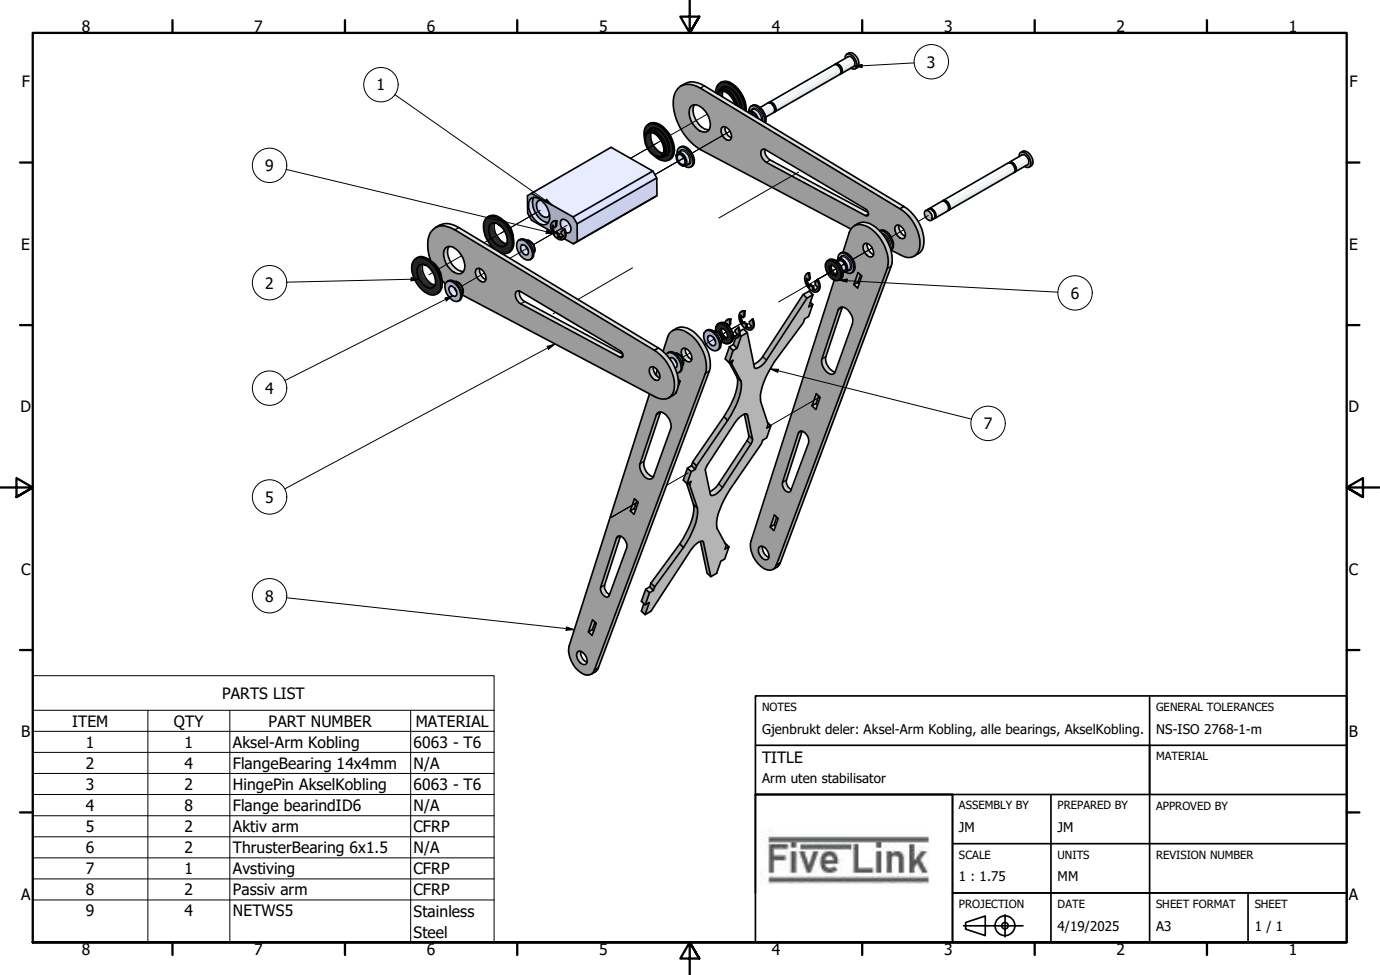
[picture p95: page 1]
PARTS LIST; Flange bearindID6; ASSEMBLY BY; APPROVED BY; PREPARED BY

NOTES Gjenbrukt deler: Aksel-Arm Kobling, alle bearings, AkselKobling. | GENERAL TOLERANCES NS-ISO 2768-1-m

ITEM | QTY | PART NUMBER | MATERIAL
1 | 1 | Aksel-Arm Kobling | 6063 - T6
2 | 4 | FlangeBearing 14x4mm | N/A
3 | 2 | HingePin AkselKobling | 6063 - T6

TITLE Arm uten stabilisator | MATERIAL

5 | 2 | Aktiv arm | CFRP
6 | 2 | ThrusterBearing 6x1.5 | N/A
7 | 1 | Avstiving | CFRP
8 | 2 | Passiv arm | CFRP
9 | 4 | NETWS5 | Stainless Steel

SCALE 1 : 1.75 | UNITS MM | REVISION NUMBER

PROJECTION | | DATE 4/19/2025 | SHEET FORMAT A3 | SHEET 1 / 1
