Ja-cup/FiveLink/Design/1 Ramme/Ramme drawing.pdf

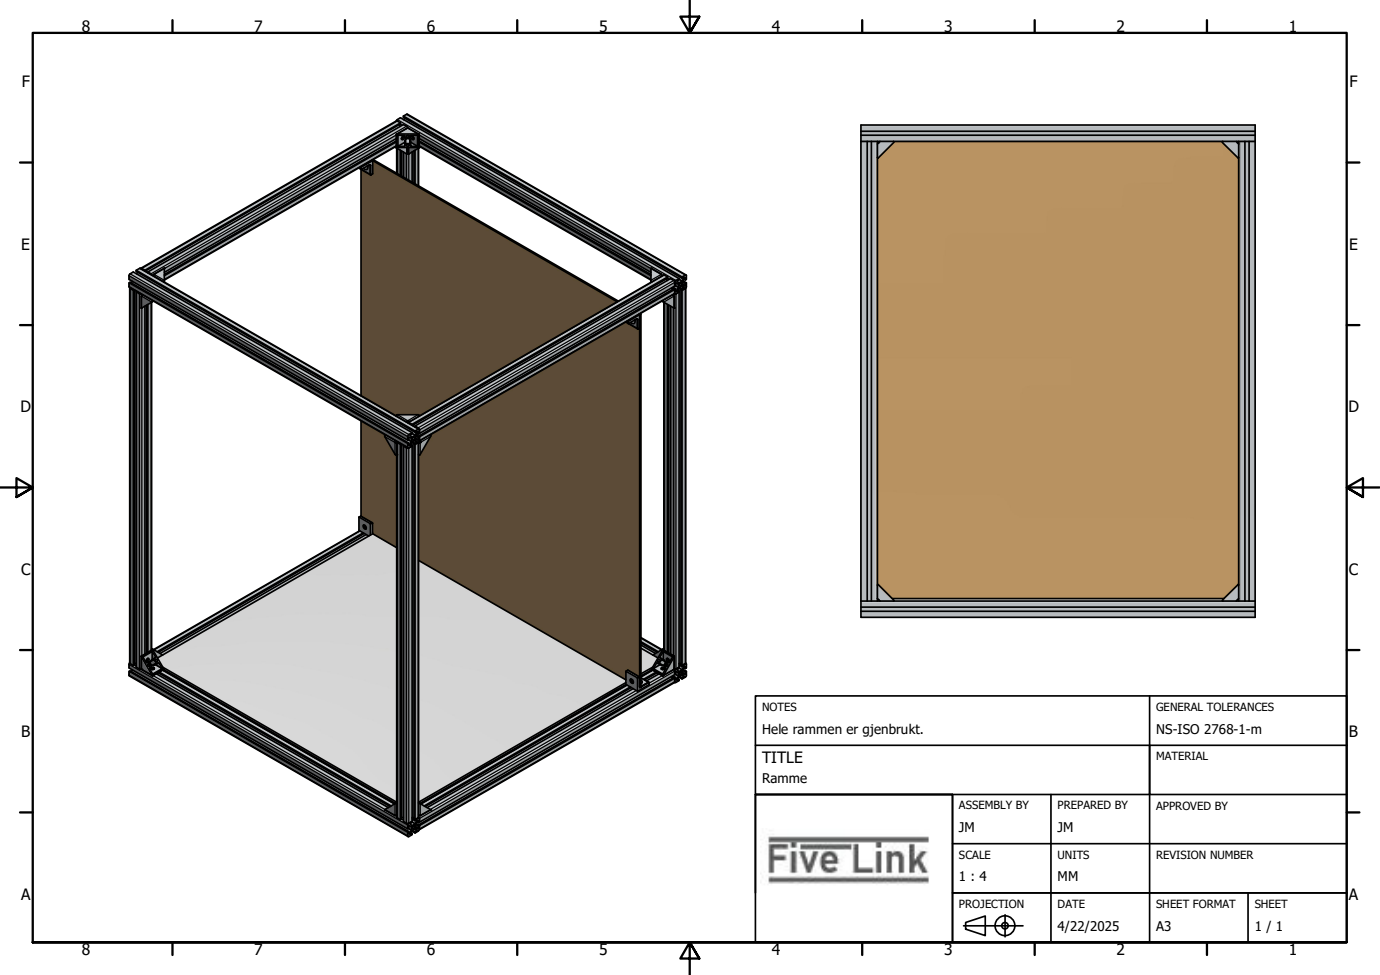
[picture p96: page 1]

NOTES Hele rammen er gjenbrukt. | GENERAL TOLERANCES NS-ISO 2768-1-m

TITLE Ramme | MATERIAL

ASSEMBLY BY JM | PREPARED BY JM | APPROVED BY

SCALE 1 : 4 | UNITS MM | REVISION NUMBER

PROJECTION | | DATE 4/22/2025 | SHEET FORMAT A3 | SHEET 1 / 1
