Ja-cup/FiveLink/Design/2 Tredje Akse/Motor med adapter og gir drawing.pdf

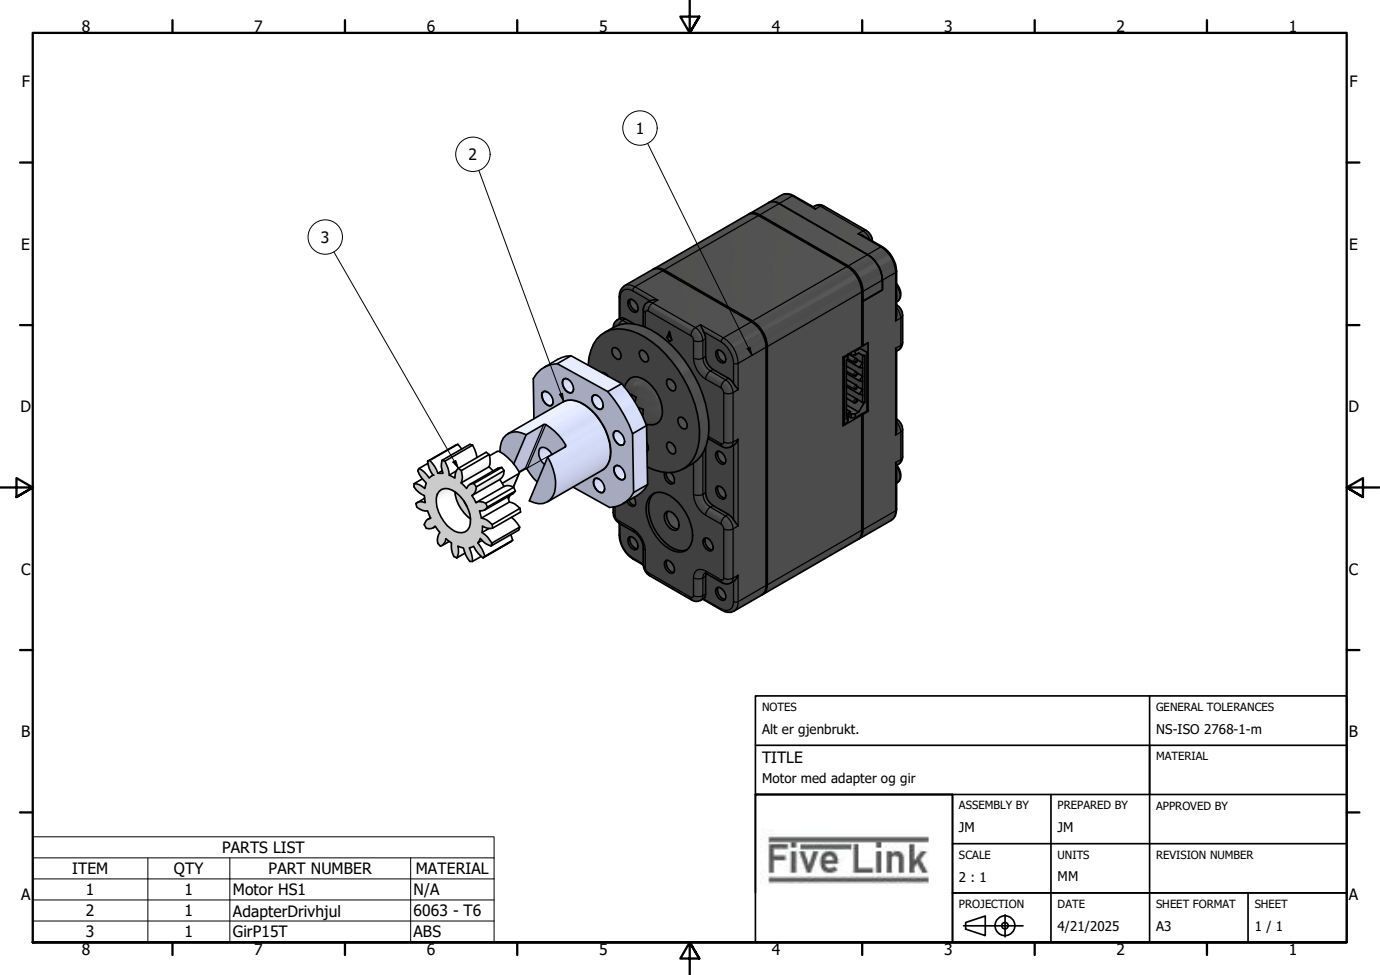
[picture p97: page 1]
PARTS LIST

NOTES Alt er gjenbrukt. | GENERAL TOLERANCES NS-ISO 2768-1-m

TITLE Motor med adapter og gir | MATERIAL

ASSEMBLY BY JM | PREPARED BY JM | APPROVED BY

SCALE 2 : 1 | UNITS MM | REVISION NUMBER

ITEM | QTY | PART NUMBER | MATERIAL
1 | 1 | Motor HS1 | N/A
2 | 1 | AdapterDrivhjul | 6063 - T6
3 | 1 | GirP15T | ABS

PROJECTION | | DATE 4/21/2025 | SHEET FORMAT A3 | SHEET 1 / 1
