Ja-cup/FiveLink/Design/2 Tredje Akse/Rails drawing.pdf

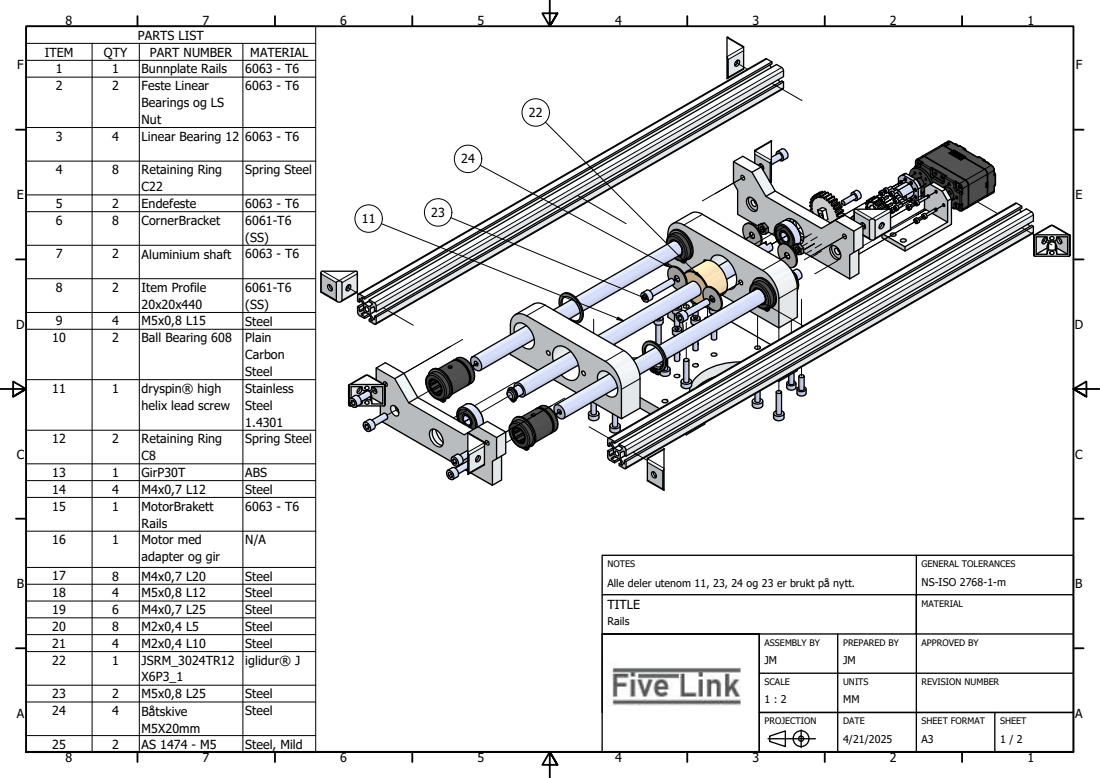
[picture p98: page 1]

I T E M | Q T Y | P A RT N U M B E R | M AT E R I A L
1 | 1 | B u n n pla t e R a ils | 6 0 6 3 -T 6
2 | 2 | F e s t e L i n e a r B e a r i n g s o g L S N u t | 6 0 6 3 -T 6

5 | 2 | E n d e f e s t e | 6 0 6 3 -T 6
6 | 8 | C o r n e r B r a c k e t | 6 0 6 1 -T 6 ( S S )

7 | 2 | Alu m i n i u m s h a ft | 6 0 6 3 -T 6

8 | 2 | I t e m P r o f ile 2 0 x 2 0 x 4 4 0 | 6 0 6 1 -T 6 ( S S )

9 | 4 | M 5 x 0 , 8 L 1 5 | S t e
2 | Ball Bearing 608 | el Plain Carbo Stainle el 10 n S t e

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

1 3 | 1 | G i r P 3 0 T | A B S
1 4 | 4 | M 4 x 0 , 7 L 1 2 | S 6063 t e el MotorBrakett
1 5 | 1 | R a ils | -T 6

N O T E S å Alle d ele r u t e n o m 1 1 , 2 3 , 2 4 o g 2 3 e r b r u kt p n y t t . | G E N E RA L T O L E RA N C E S N S -I S O 2 7 6 8 -1 -m

1 7 | 8 | M 4 x 0 , 7 L 2 0 | S t e
4 6 8 4 | M5x0,8 L12 M4x0,7 L25 M2x0,4 L5 M2x0,4 L10 | Steel 19 Steel 20 Steel 21 Steel JSRM_3024TR12 iglidu el 18

T I T L E R a ils | M AT E R I A L

2 4 | 4 | | Steel M5X20mm el Båtskive

2 5 | 2 | A S 1 4 7 4 -M 5 | S t e el, M ild

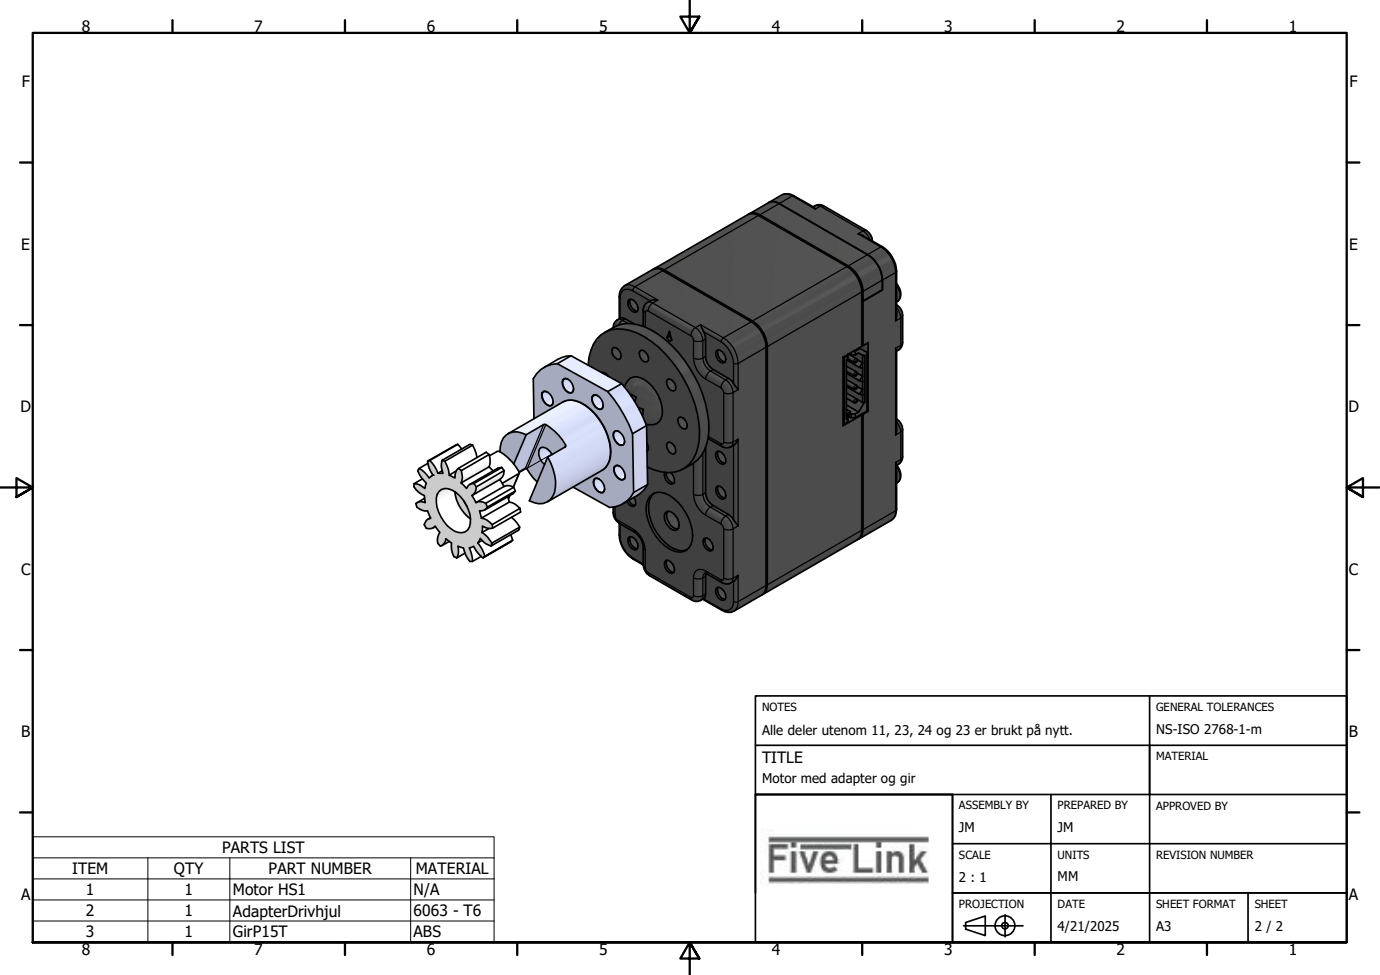
[picture p99: page 2]
PARTS LIST

NOTES Alle deler utenom 11, 23, 24 og 23 er brukt på nytt. | GENERAL TOLERANCES NS-ISO 2768-1-m

TITLE Motor med adapter og gir | MATERIAL

ASSEMBLY BY JM | PREPARED BY JM | APPROVED BY

SCALE 2 : 1 | UNITS MM | REVISION NUMBER

ITEM | QTY | PART NUMBER | MATERIAL
1 | 1 | Motor HS1 | N/A
2 | 1 | AdapterDrivhjul | 6063 - T6
3 | 1 | GirP15T | ABS

PROJECTION | | DATE 4/21/2025 | SHEET FORMAT A3 | SHEET 2 / 2
