Ja-cup/FiveLink/Design/3 Festehub/Beholdt deler/Aksel drawing.pdf

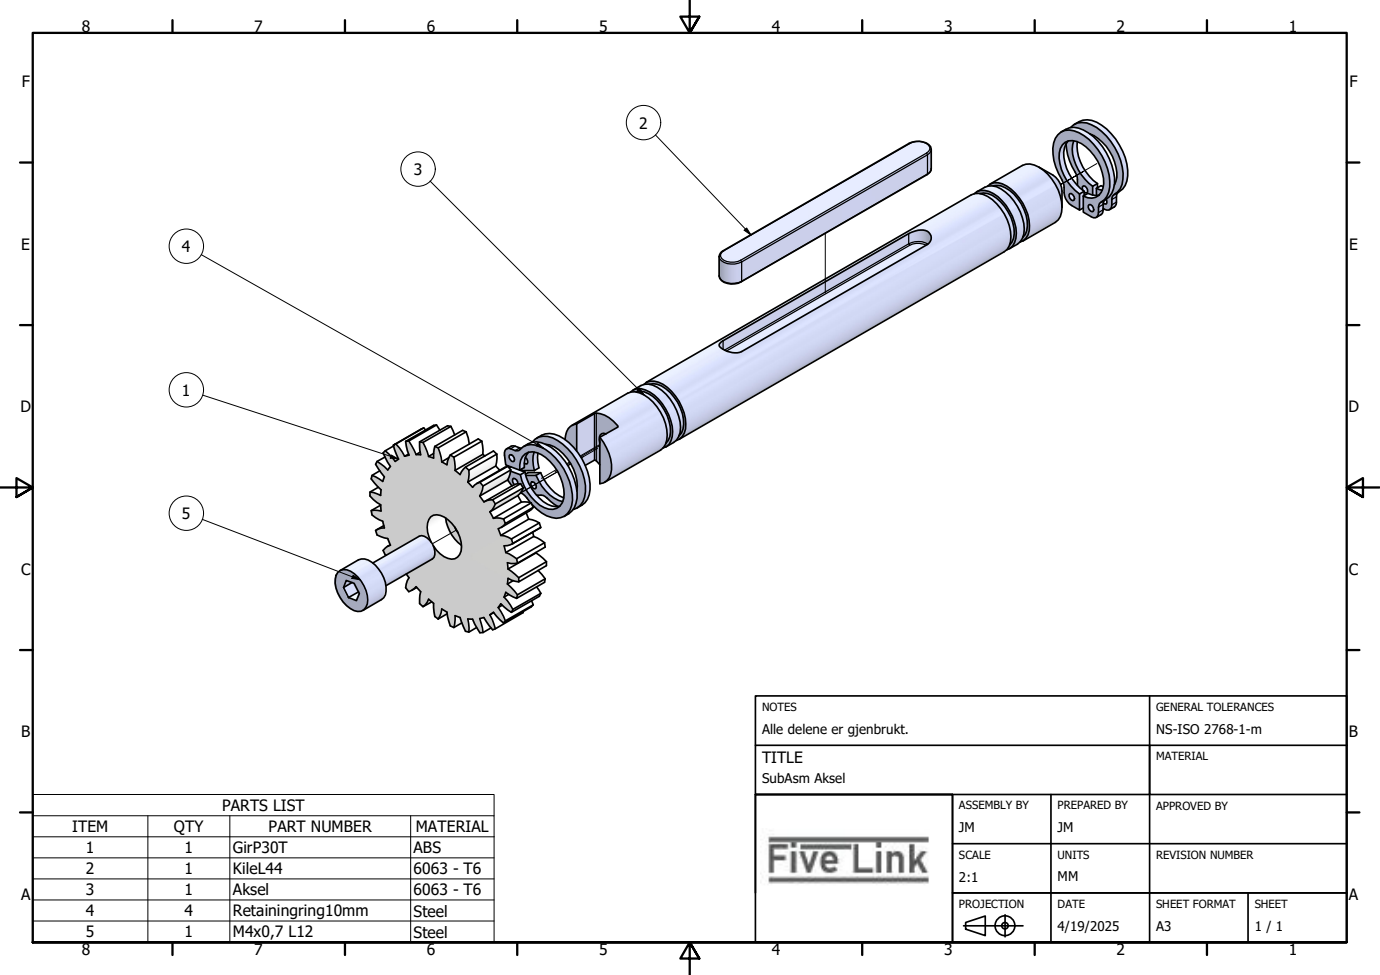
[picture p100: page 1]
PARTS LIST; ASSEMBLY BY; APPROVED BY; PREPARED BY

NOTES Alle delene er gjenbrukt. | GENERAL TOLERANCES NS-ISO 2768-1-m

TITLE SubAsm Aksel | MATERIAL

ITEM | QTY | PART NUMBER | MATERIAL
1 | 1 | GirP30T | ABS
2 | 1 | KileL44 | 6063 - T6
3 | 1 | Aksel | 6063 - T6
4 | 4 | Retainingring10mm | Steel
5 | 1 | M4x0,7 L12 | Steel

SCALE 2:1 | UNITS MM | REVISION NUMBER

PROJECTION | | DATE 4/19/2025 | SHEET FORMAT A3 | SHEET 1 / 1
