Ja-cup/FiveLink/Design/5 Stabilisator/Stabilisator drawing (utdatert).pdf

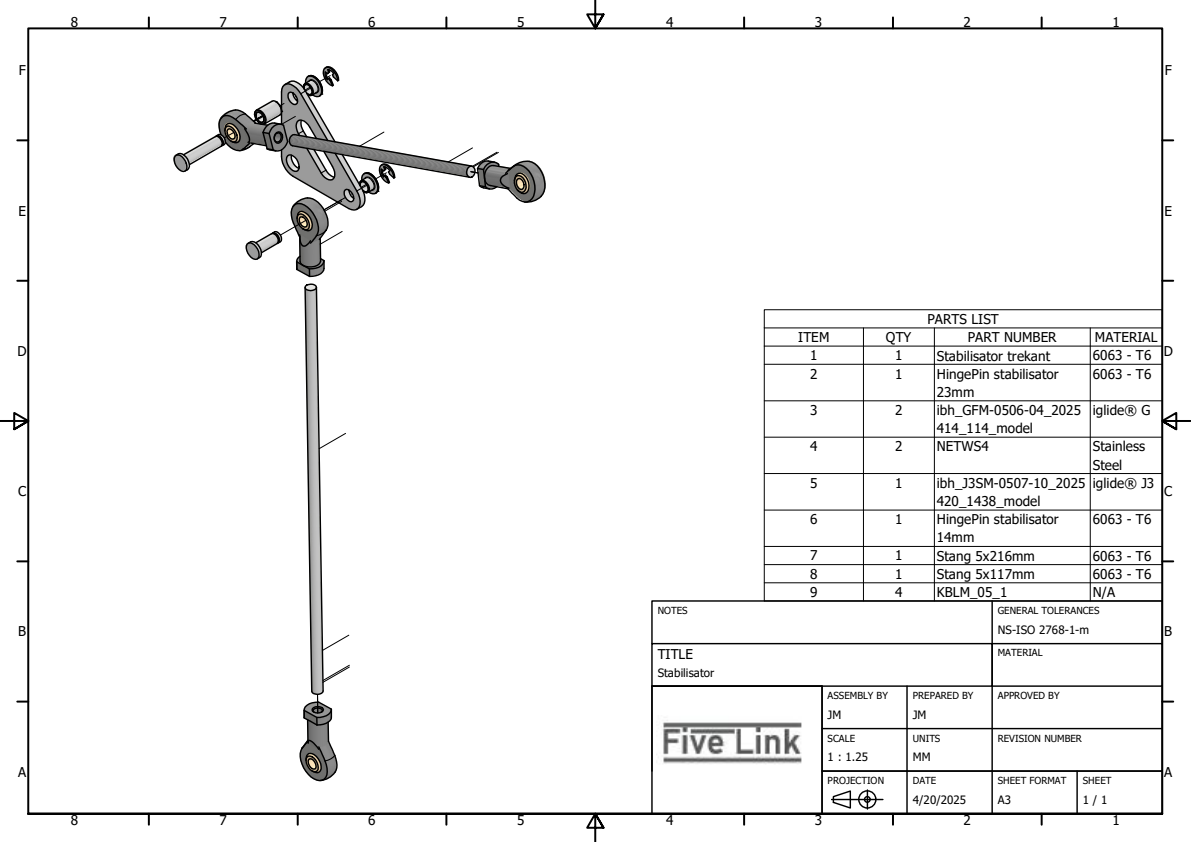
[picture p101: page 1]

I T E M | Q TY | P A RT N U M B E R | M AT E R I A L
1 | 1 | S t a b ili s a t o r t r e k a n t | 6 0 6 3 -T 6
2 | 1 | H i n g e P i n s t a b ili s a t o r 2 3 m m | 6 0 6 3 -T 6

2 | i b h _ G F M -0 5 0 6 el 3 -0 4 _ 2 0 2 5 4 1 4 _ 1 1 4 _ m o d | i gli d e ® G

2 | NETWS4 ibh_J3SM-0507-10_2025 | S iglide t a i el 4 nle s s S t e

1 | HingePin stabilisa el 5 4 2 0 _ 1 4 3 8 _ m o d | ® J 3

7 | 1 | S t a n g 5 x 2 1 6 m m | 6 0 6 3 -T 6
8 | 1 | S t a n g 5 x 1 1 7 m m | 6 0 6 3 -T 6
9 | 4 | K B L M _ 0 5 _ 1 | N /

T I T L E S t a b ili s a t o r | M AT E R I A L
